GonzaCerv/noah-hardware/3D_model/electronics/LCD-1.8/s-l1600.png

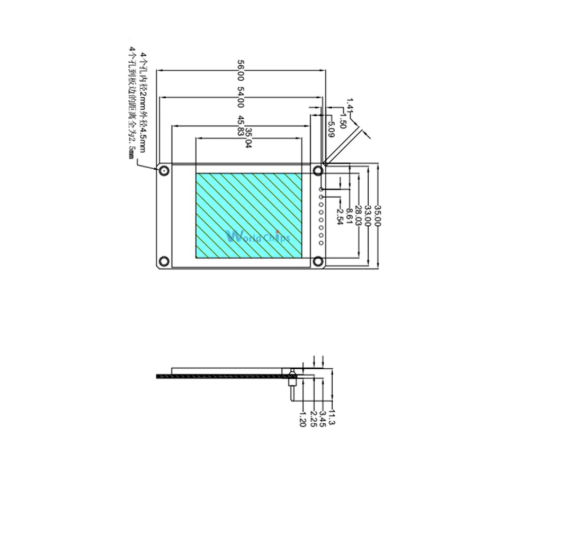
3D_model/electronics/LCD-1.8/s-l1600.png
