GonzaCerv/noah-hardware/3D_model/electronics/MG90S-Servo/Servo-MG90S.JPG

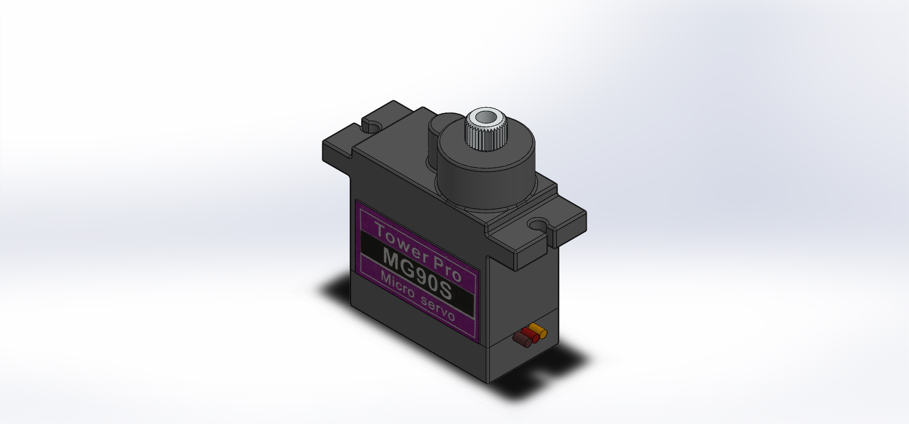
3D_model/electronics/MG90S-Servo/Servo-MG90S.JPG
