GonzaCerv/noah-hardware/3D_model/electronics/RPI3/renders/render1.jpg

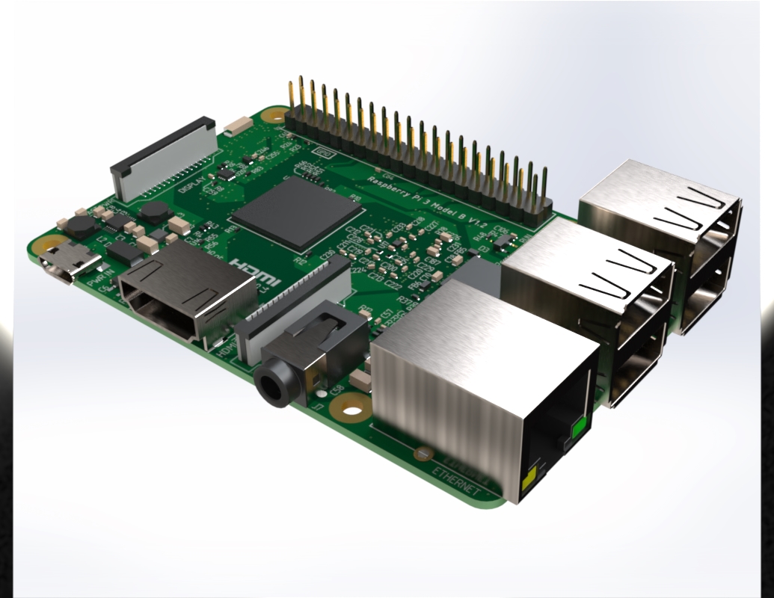
3D_model/electronics/RPI3/renders/render1.jpg
