GonzaCerv/noah-hardware/3D_model/electronics/RPI3/renders/render3.jpg

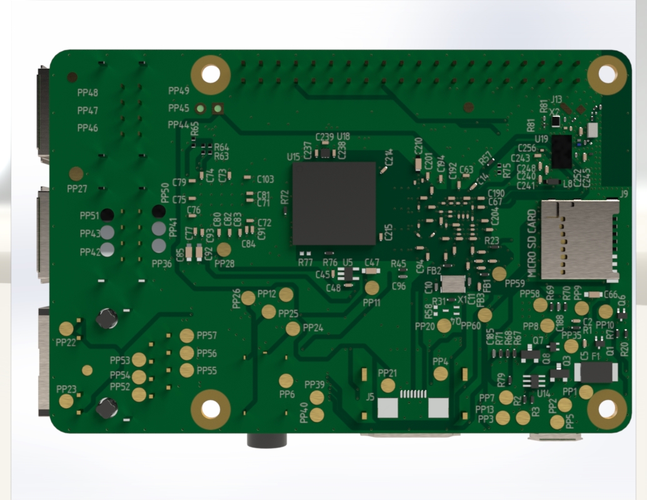
3D_model/electronics/RPI3/renders/render3.jpg
