GonzaCerv/noah-hardware/3D_model/electronics/RPI3/renders/render7.jpg

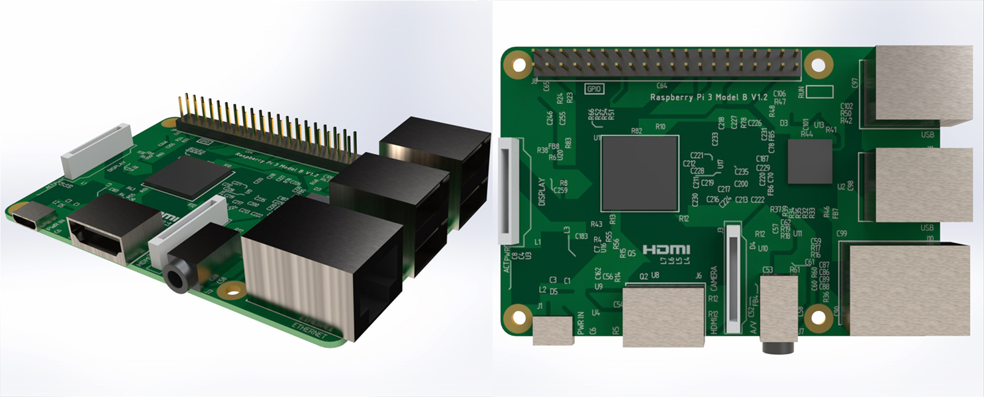
3D_model/electronics/RPI3/renders/render7.jpg
