GonzaCerv/noah-hardware/3D_model/electronics/RPI3/textures/textureBack.png

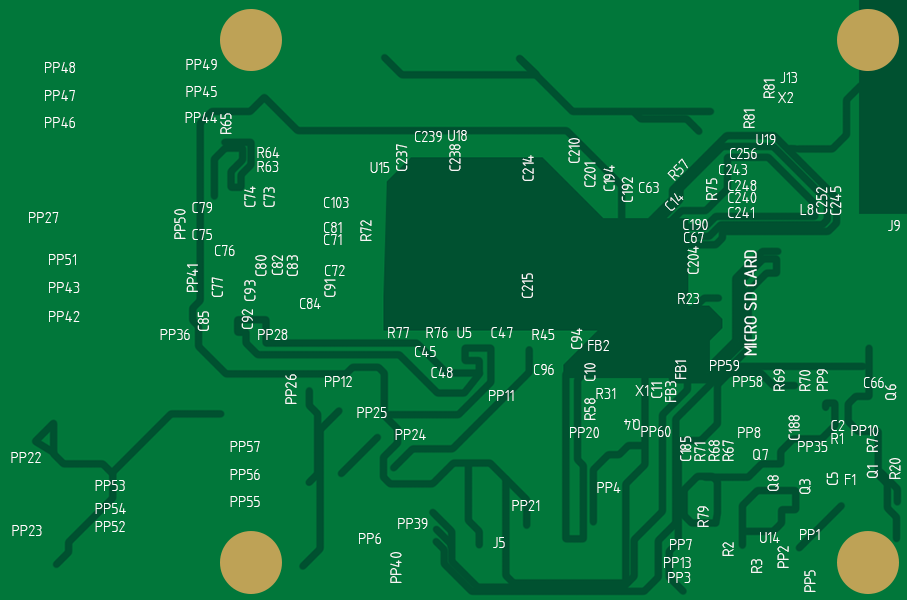
3D_model/electronics/RPI3/textures/textureBack.png
