GonzaCerv/noah-hardware/3D_model/electronics/RPI3/textures/textureFront.png

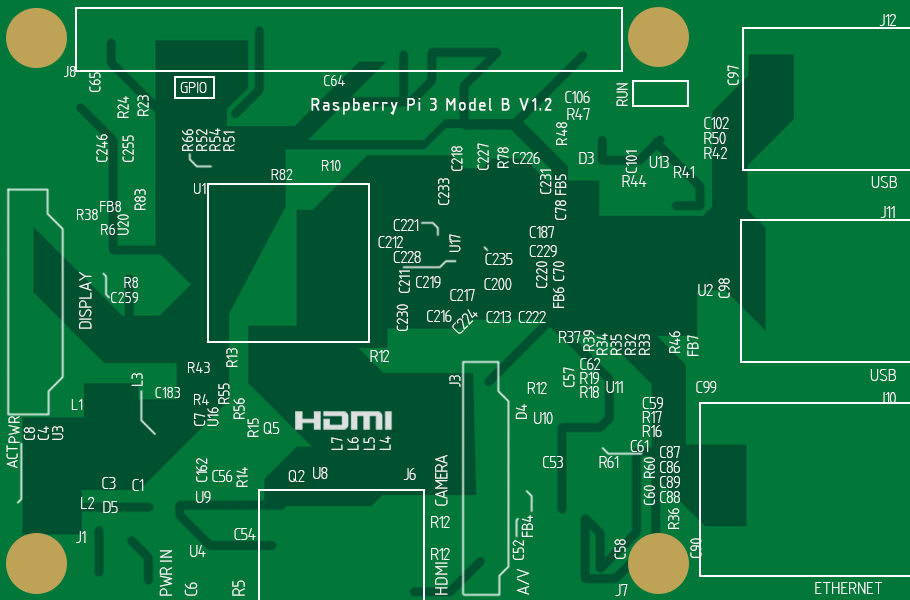
3D_model/electronics/RPI3/textures/textureFront.png
