GonzaCerv/noah-hardware/3D_model/electronics/RPI Cam/back.jpg

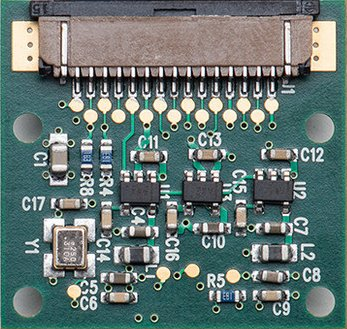
3D_model/electronics/RPI Cam/back.jpg
