GonzaCerv/noah-hardware/3D_model/electronics/RPI Cam/front.jpg

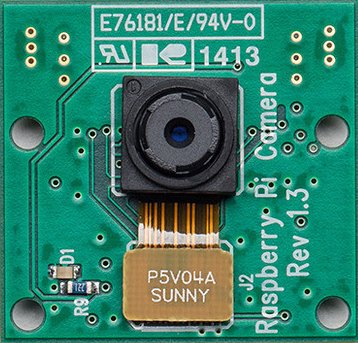
3D_model/electronics/RPI Cam/front.jpg
