GonzaCerv/noah-hardware/3D_model/electronics/RPI Cam/RasPi_Camera.JPG

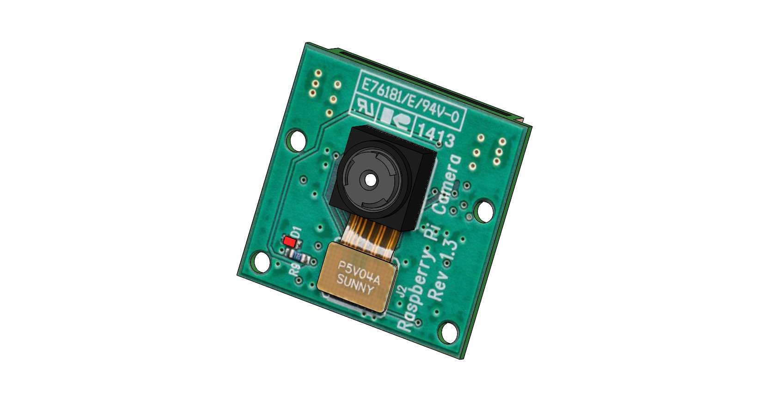
3D_model/electronics/RPI Cam/RasPi_Camera.JPG
