GonzaCerv/noah-hardware/3D_model/electronics/STM32F4/stm32f4/STM32F4-discovery-bottom.jpg

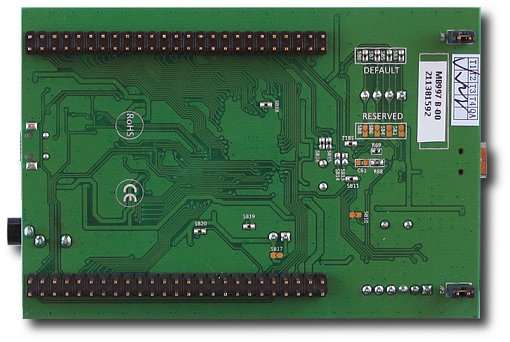
3D_model/electronics/STM32F4/stm32f4/STM32F4-discovery-bottom.jpg
