GonzaCerv/noah-hardware/3D_model/electronics/STM32F4/stm32f4/Stm32F4.jpg

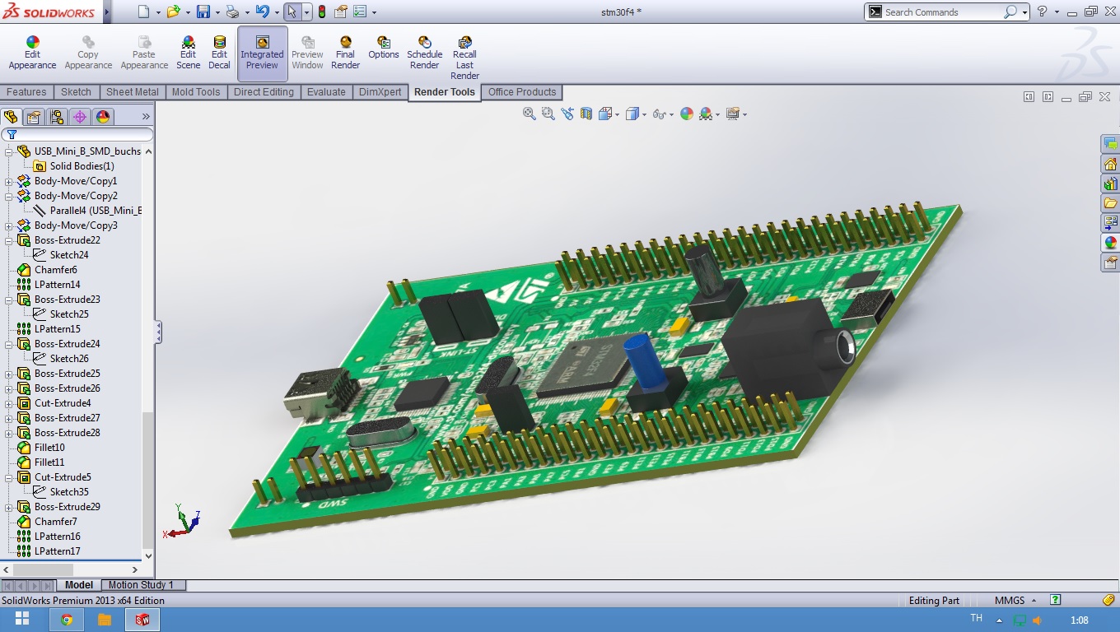
3D_model/electronics/STM32F4/stm32f4/Stm32F4.jpg
