GonzaCerv/noah-hardware/3D_model/electronics/STM32F4/stm32f4/stm32f4_discovery_small.jpg

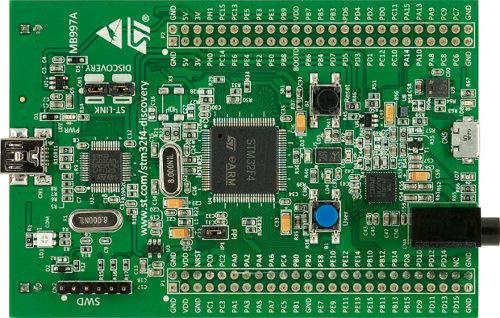
3D_model/electronics/STM32F4/stm32f4/stm32f4_discovery_small.jpg
