GonzaCerv/noah-hardware/Doc/Datasheet/GY-91_SCH.jpg

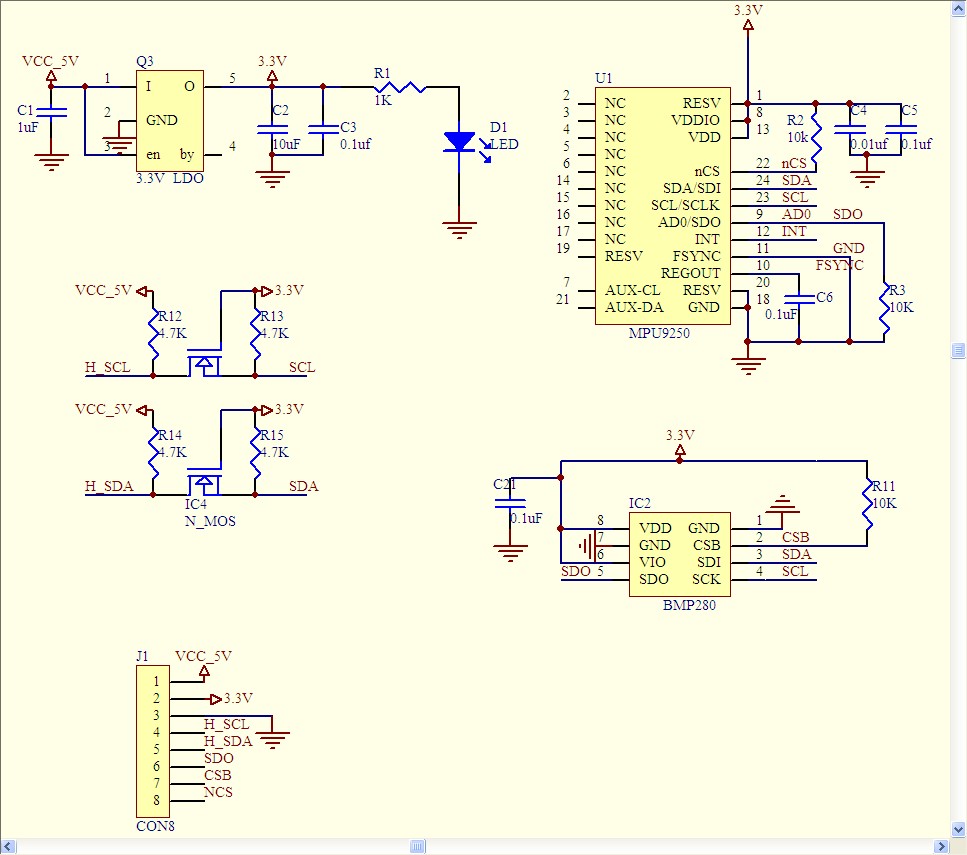
Doc/Datasheet/GY-91_SCH.jpg
