GonzaCerv/noah-hardware/Doc/images/noah_generic_1.jpg

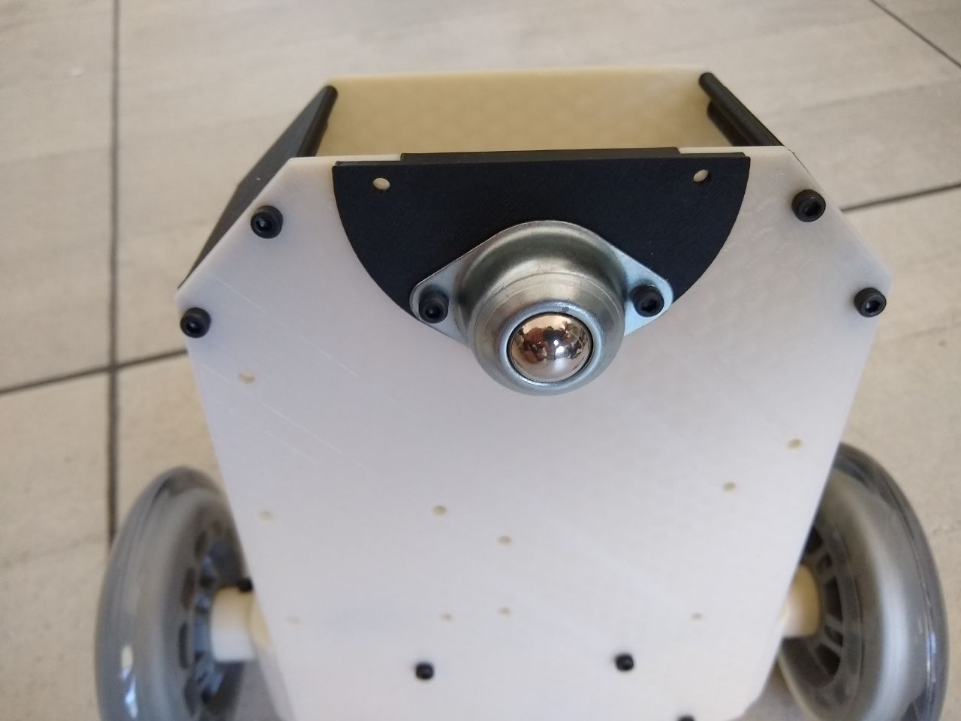
Doc/images/noah_generic_1.jpg
