GonzaCerv/noah-hardware/Doc/images/noah_generic_3.jpg

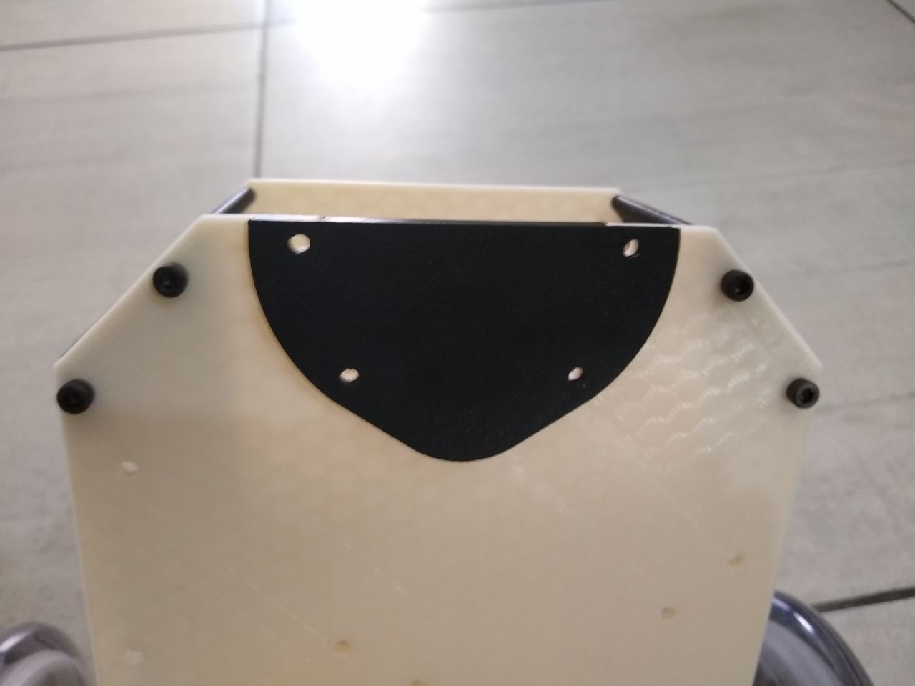
Doc/images/noah_generic_3.jpg
