GonzaCerv/noah-hardware/Doc/images/noah_generic_4.jpg

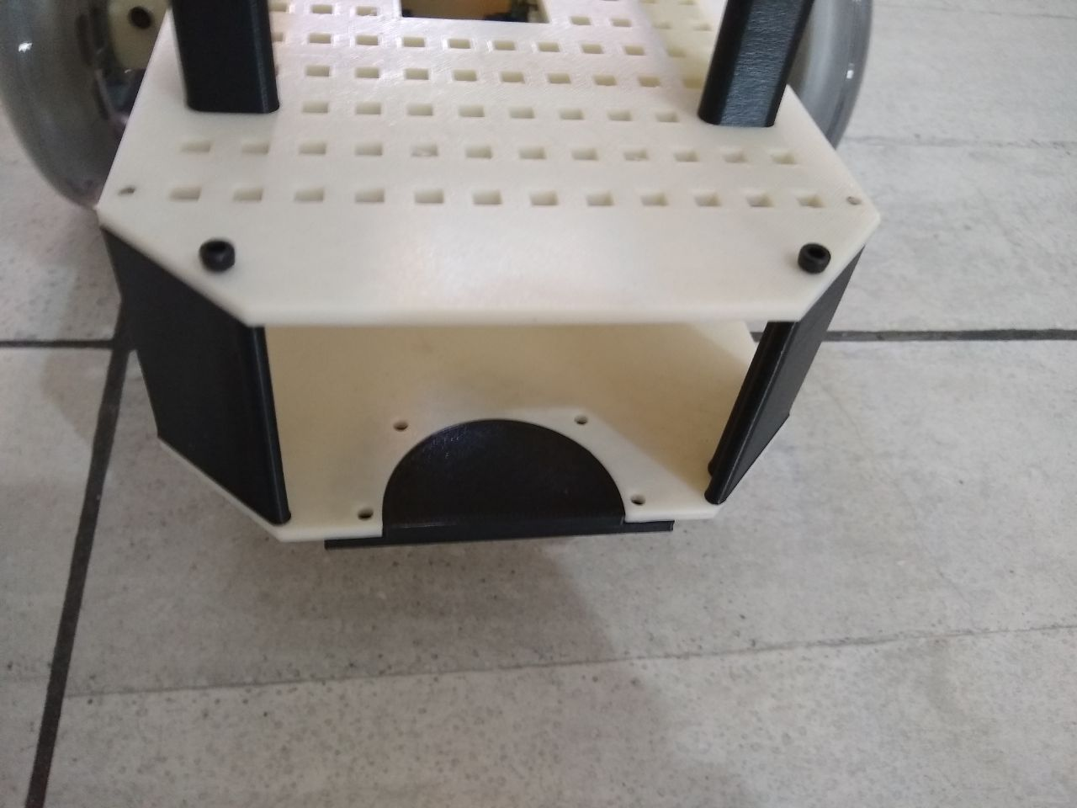
Doc/images/noah_generic_4.jpg
