GonzaCerv/noah-hardware/Doc/BOM.ods

Sheet: Noah-Generic
Item | Categoria | Fabricante | Descripcion | Proveedor | Costo U$S | Costo $ | Referencia
1 | Electronica | Element 14 | Raspberry PI 4 | MercadoLibre | $52.0 | 7,947 | https://articulo.mercadolibre.com.ar/MLA-881506910-raspberry-pi-4b-2gb-ram-original-made-in-uk-_JM
1 | Electrónica | UniBot, PatagoniaTec | Driver Motor DC | MercadoLibre | $3.2 | 500 | https://articulo.mercadolibre.com.ar/MLA-825601902-driver-tb6612-fng-doble-puente-h-15v-max-12a-robotica-ubot-_JM
2 | Electrónica | Itytarg | DC-DC converter | MercadoLibre | $4.6 | 707 | https://articulo.mercadolibre.com.ar/MLA-648618942-step-down-5a-xl4015-cc-cv-led-driver-cbateria-4v-38v-itytarg-_JM
1 | Electrónica | Element 14 | Blue Pill Stm32 | MercadoLibre | $3.9 | 599 | https://articulo.mercadolibre.com.ar/MLA-777080676-modulo-desarrollo-stm32f103c8t6-blue-pill-stm32-cs32f103c8t6-_JM
1 | Electrónica | China | DC motor + Encoder | Openhacks | $26.0 | 4030 | https://www.openhacks.com/page/productos/id/1775/title/DC6-24v-Gear-Motor-with-Encoder#.YJh7QbX0lPY
4 | Electrónica | China | Celda 3.7v 18650 | MercadoLibre | $5.8 | 900 | https://articulo.mercadolibre.com.ar/MLA-624246943-pila-de-litio-ion-icr18650-26f-samsung-2600mah-p-linternas-_JM
1 | Electrónica | China | BMS Proteccion-Balanceo Baterías litio | Mercadolibre | $10.9 | 1690 | https://articulo.mercadolibre.com.ar/MLA-795341093-modulo-proteccion-4-baterias-li-ion-18650-bms-4-celdas-30a-_JM
1 | Electrónica | China | Cables varios | Mercadolibre | $4.2 | 650 | https://articulo.mercadolibre.com.ar/MLA-621519912-kit-120-cables-x-20-cm-dupont-protoboard-arduino-mm-mh-hh-_JM
1 | Electronica | China | llave micro E | Mercadolibre | $7.2 | 1110 | https://articulo.mercadolibre.com.ar/MLA-866399995-smts102-micro-llave-palanca-simple-on-on-3a-250v-pack-x5-_JM
2 | Mecánica | Tuxs | Rueda Roller 100mm (no bearing) | Mercadolibre | $16.1 | 2490 | https://articulo.mercadolibre.com.ar/MLA-797050834-4-ruedas-silicona-para-rollers-monopatin-100-mm-estacion-deportes-olivos-_JM
8 | Mecánica | China | Holder 18650 | Mercadolibre | $0.5 | 75 | https://articulo.mercadolibre.com.ar/MLA-917623042-holder-separador-porta-pila-18650-encastrable-_JM
34 | Mecánica |  | Tornillos M3 x 10mm | Mercadolibre | $3.2 | 500 | https://articulo.mercadolibre.com.ar/MLA-724797219-tornillos-electronica-m3-x-10mm-caja-x-100-unid-con-tuercas-_JM
34 | Mecánica |  | Arandelas M3 | Mercadolibre | $2.5 | 389 | https://articulo.mercadolibre.com.ar/MLA-919535639-arandelas-m3-pack-x-200-unidades-plateadas-electronica-_JM
12 | Mecánica |  | Tuercas M3 | Mercadolibre | $1.2 | 191 | https://articulo.mercadolibre.com.ar/MLA-728283877-x20-tuerca-metrica-m3-hexagonal-lock-nust-05mm-_JM
2 | Mecánica |  | Rueda Loca Arduino | Mercadolibre | $1.4 | 214 | https://articulo.mercadolibre.com.ar/MLA-759018310-rueda-loca-arduino-tipo-bola-para-robot-rover-auto-ptec-_JM
1 | Parte 3D | - | front | - | - | -
1 | Parte 3D | - | C000 | - | - | -
1 | Parte 3D | - | C001 | - | - | -
2 | Parte 3D | - | Adapter1 | - | - | -
2 | Parte 3D | - | Adapter2 | - | - | -
1 | Parte 3D | - | base_generic | - | - | -
1 | Parte 3D | - | top_generic | - | - | -
1 | Parte 3D | - | shelf | - | - | -
1 | Parte 3D | - | back_left | - | - | -
1 | Parte 3D | - | back_right | - | - | -
1 | Parte 3D | - | SMPS_support | - | - | -
4 | Parte 3D | - | spacer50mm | - | - | -

Sheet: Copia de Hoja 1
Item | Categoria | Fabricante | Descripcion | Proveedor | Costo U$S | Costo $ | Referencia
1 | Vehiculo | Cub Cadet | 42" mower with 18HP Kohler engine | MercadoLibre | $1,650
1 | Direccion |  | 12 volt power steering motor | ebay | $50
1 | Transimision |  | linear actuator
1 | Direccion |  | motor controller |  |  |  | Investigate using a Sabertooth controller and py lib (https://github.com/MomsFriendlyRobotCompany/pysabertooth); See also https://www.dimensionengineering.com/datasheets/Sabertooth2x25v2.pdf
 | Seguridad |  | wireless kill switch and transmitter
 | Seguridad |  | lanyard kill switch
 | Electronica |  | RPi 3 for companion computer
 | Electronica | Tinkerforge | IMU Brick 2 | Tinkerforge
 | Electronica |  | Ppowered USB hub
 | Electronica |  | RTK GNSS module and antennae
 | Electronica |  | Terminal wiring blocks
 |  |  | 5 color wire (18 AWG)
