GonzaCerv/noah-hardware/3D_model/assembly_front.SLDASM

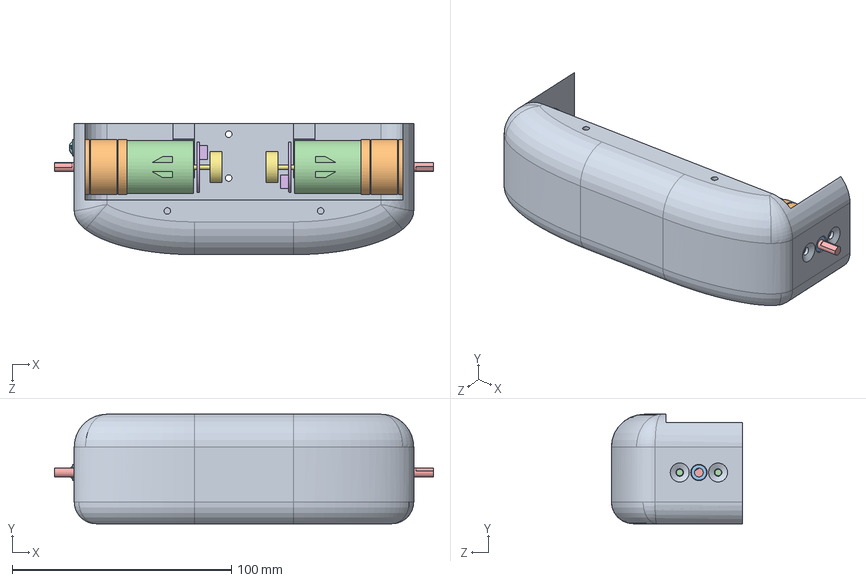
[picture p26: CAD file, 2020-10-06]
3D_model/assembly_front.SLDASM
173.0 x 50.0 x 60.0 mm
front_noah
Gearbox x 2
hub x 2
Motor x 2
Axis x 2
PCB x 2
Magnet x 2
