GonzaCerv/noah-hardware/3D_model/case/casterjoint/noah/CasterJoint.SLDASM

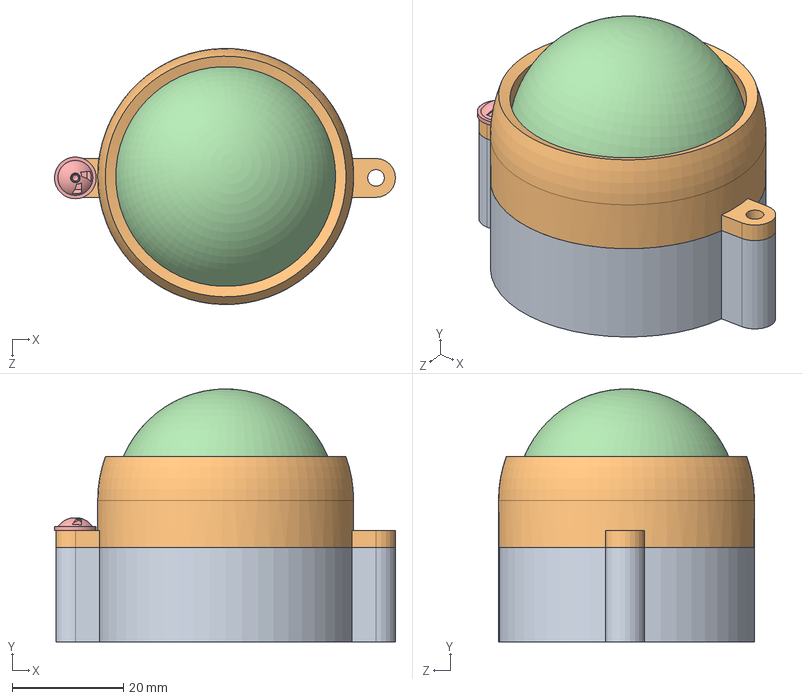
[picture p27: CAD file, 2020-10-18]
3D_model/case/casterjoint/noah/CasterJoint.SLDASM
61.2 x 45.4 x 46.0 mm
C000
C001
BALL6MM x 3
BALL40MM
