GonzaCerv/noah-hardware/3D_model/electronics/18650bat/BatteryPack.SLDASM

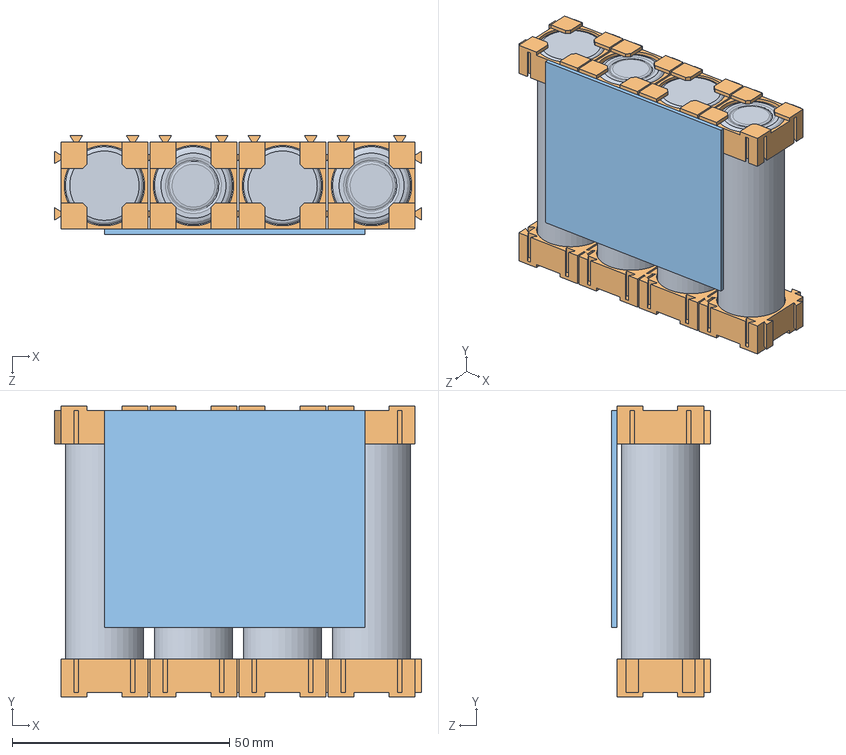
[picture p28: CAD file, 2020-05-14]
3D_model/electronics/18650bat/BatteryPack.SLDASM
84.5 x 67.0 x 22.7 mm
ELEB05 x 4
ELEB04 x 8
BMS
