GonzaCerv/noah-hardware/3D_model/electronics/JA25-371-12v motor/JA25-371-12V.SLDASM

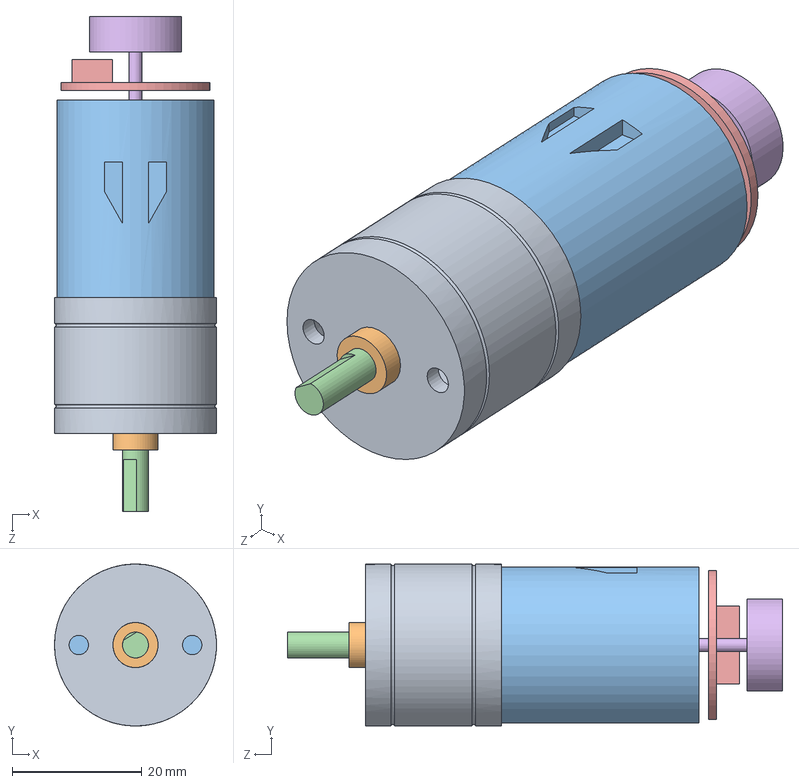
[picture p29: CAD file, 2020-05-14]
3D_model/electronics/JA25-371-12v motor/JA25-371-12V.SLDASM
25.0 x 25.0 x 76.4 mm
Gearbox
hub
Motor
Axis
PCB
Magnet
