GonzaCerv/noah-hardware/3D_model/electronics/Misc/LED 3mm Red 3mm Leads.SLDASM

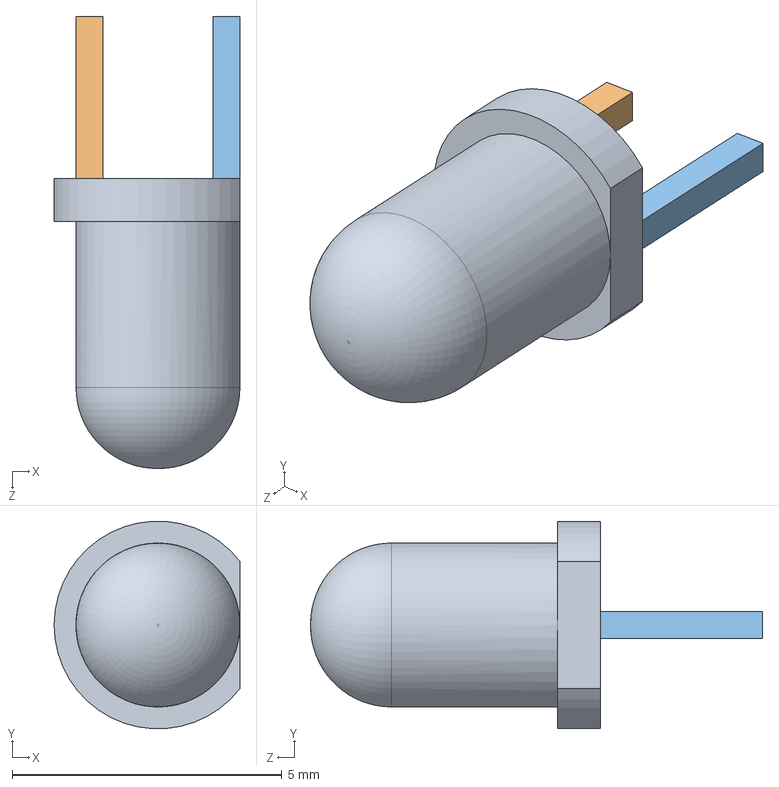
[picture p30: CAD file, 2020-10-06]
3D_model/electronics/Misc/LED 3mm Red 3mm Leads.SLDASM
3.44 x 3.84 x 8.38 mm
LEDBody.step
Lead1Body.step
Lead2Body.step
