GonzaCerv/noah-hardware/3D_model/assembly_button.SLDASM

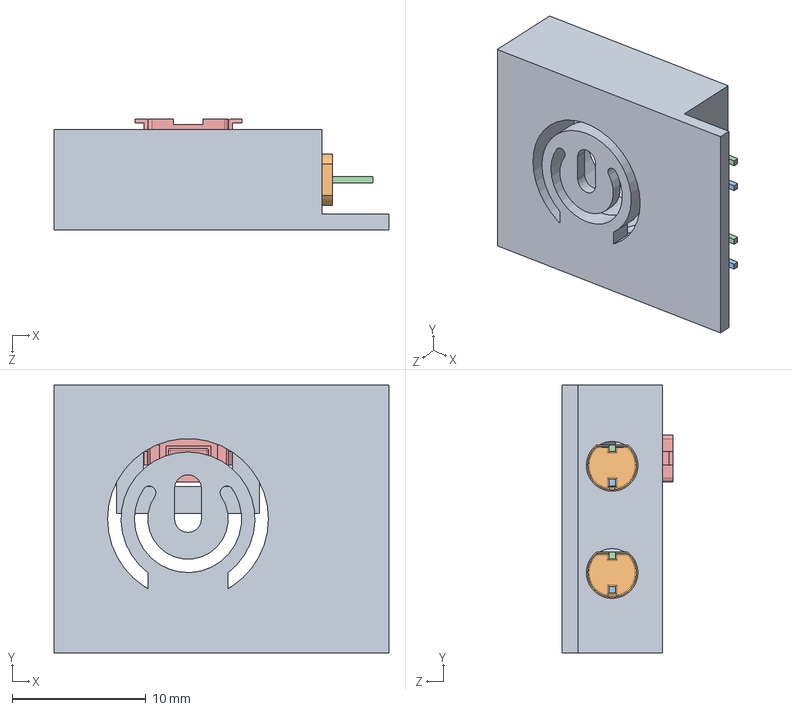
[picture p31: CAD file, 2020-10-06]
3D_model/assembly_button.SLDASM
25.0 x 20.0 x 8.30 mm
power_button_noah
LEDBody.step x 2
Lead1Body.step x 2
Lead2Body.step x 2
Tactile_Switch_SMD
hex thin nut gradeb_din x 2
