GonzaCerv/noah-hardware/3D_model/case/wheel/noah/TuxsWheel100mm.SLDASM

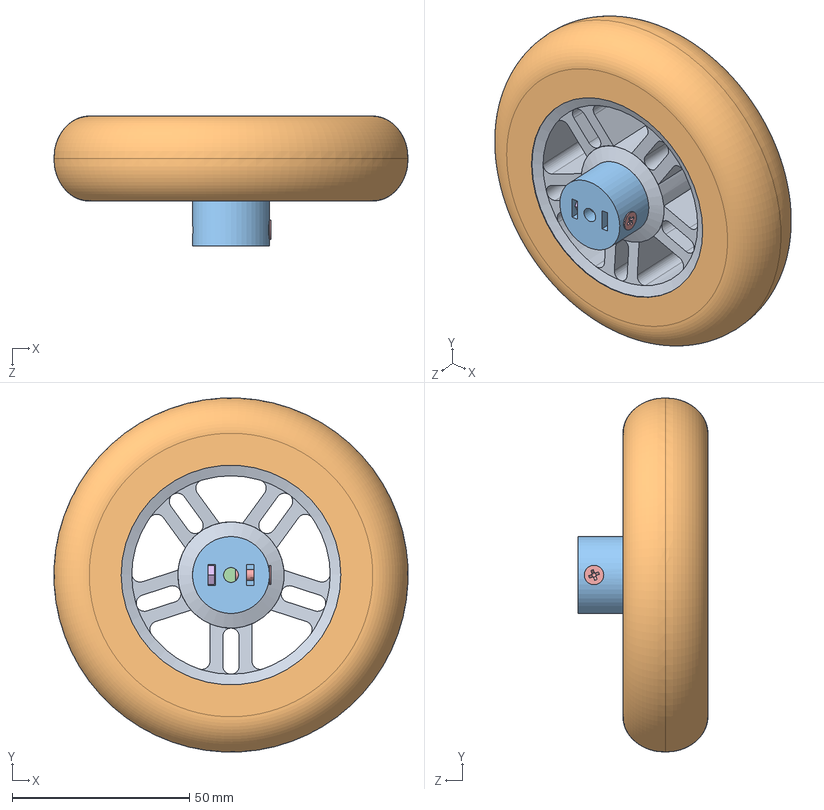
[picture p32: CAD file, 2020-10-18]
3D_model/case/wheel/noah/TuxsWheel100mm.SLDASM
99.9 x 99.9 x 36.6 mm
B02
B021
Adapter1
Adapter2
