GonzaCerv/noah-hardware/3D_model/electronics/N20 Micromotor/N20Motor.SLDASM

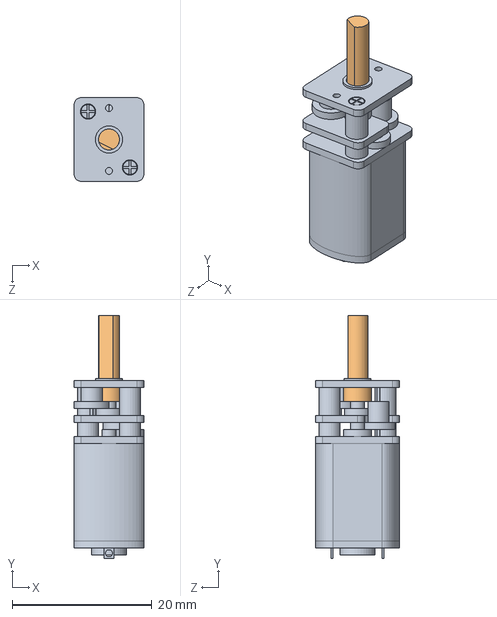
[picture p33: CAD file, 2020-04-07]
3D_model/electronics/N20 Micromotor/N20Motor.SLDASM
10.0 x 34.8 x 12.0 mm
Motor
Brazo
