GonzaCerv/noah-hardware/3D_model/electronics/RPI Cam/OVA5647.SLDASM

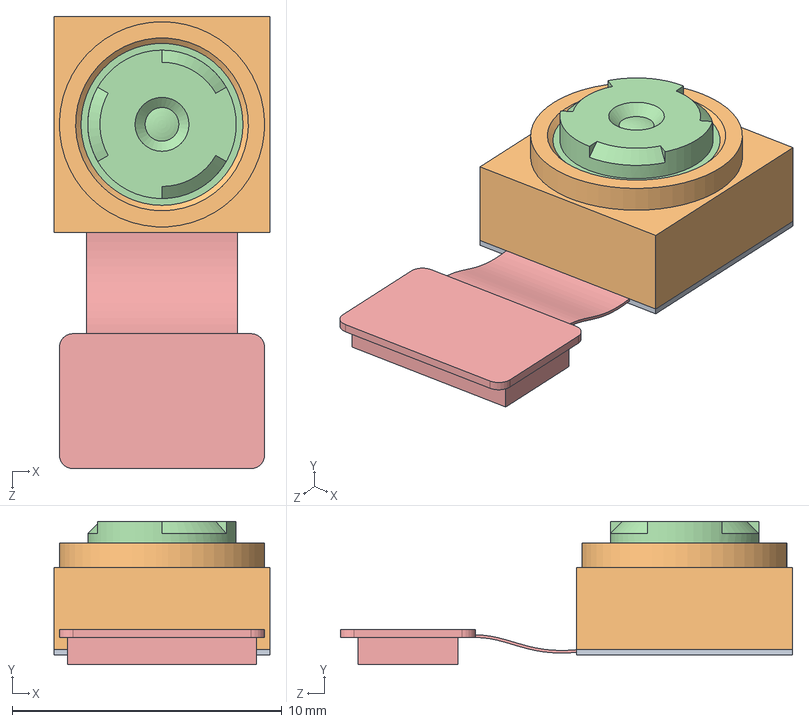
[picture p34: CAD file, 2020-04-07]
3D_model/electronics/RPI Cam/OVA5647.SLDASM
8.00 x 5.30 x 16.8 mm
OVA5647
OVA5647_Housing
OVA5647_IR-Glas
OVA5647_Lens
OVA5647_Pigtail
