GonzaCerv/noah-hardware/3D_model/electronics/TactSwitch/6mm button.SLDASM

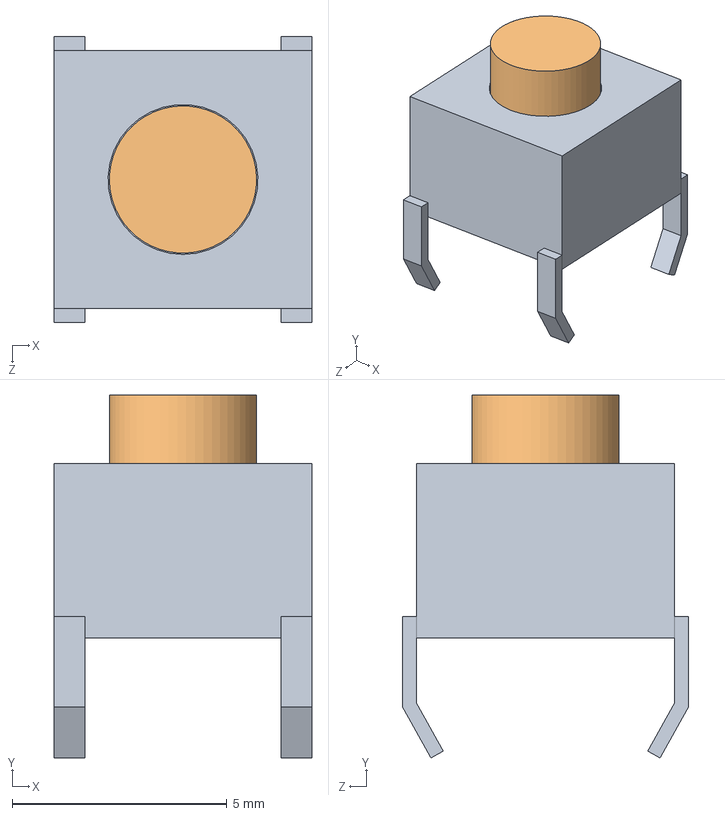
[picture p35: CAD file, 2020-04-07]
3D_model/electronics/TactSwitch/6mm button.SLDASM
6.00 x 8.46 x 6.66 mm
6mm button base
6mm button shaft
