GonzaCerv/noah-hardware/3D_model/electronics/Arduino/L298/Montaj - L298 DC Motor Drive.SLDASM

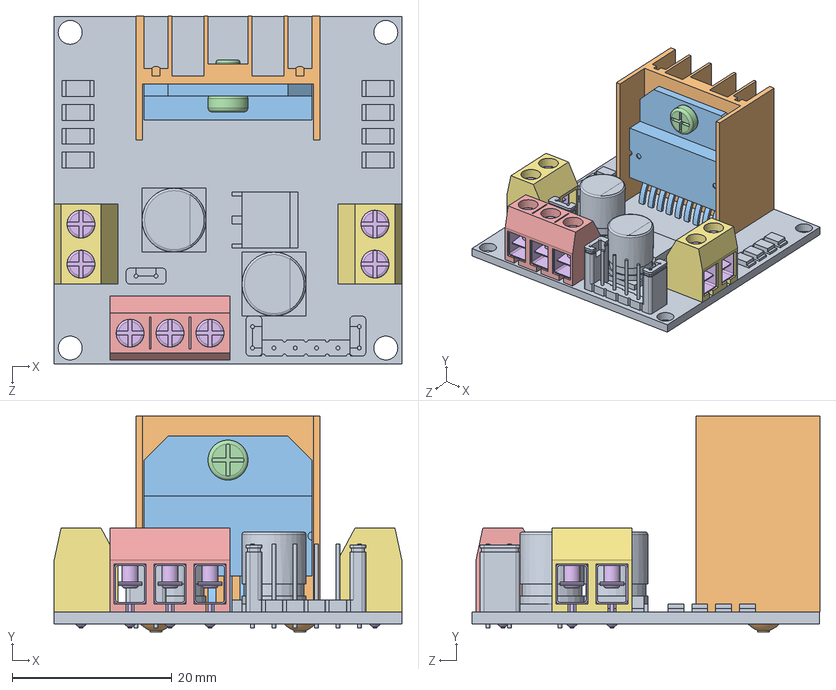
[picture p36: CAD file, 2020-10-18]
3D_model/electronics/Arduino/L298/Montaj - L298 DC Motor Drive.SLDASM
43.5 x 27.0 x 43.5 mm
L298 Board
Cooler Blok
L298N Regulator
Vida M3x4.5
Clamp Body
Metal Clamp Part x 7
Clamp Body 2x x 2
