GonzaCerv/noah-hardware/3D_model/electronics/PCB/PCB.SLDASM

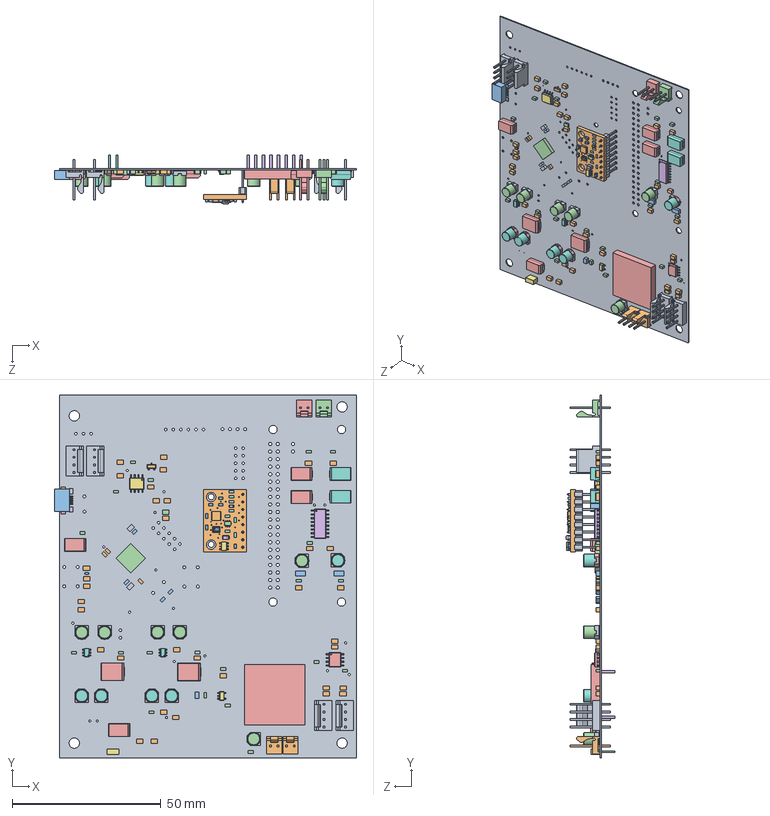
[picture p37: CAD file, 2020-04-07]
3D_model/electronics/PCB/PCB.SLDASM
101.6 x 122.0 x 16.3 mm
Board
Extruded x 34
Extruded_2 x 2
PinsArrayLR
PinKIdent
PinK
PinA
Extruded_3 x 19
Base
Pin1Fillet
Pin2Fillet
Base_2 x 2
Pin1Fillet_2 x 2
Pin2Fillet_2 x 2
FilletPin1 x 4
FilletPin2 x 4
FilletPin1_2 x 2
FilletPin2_2 x 2
Extruded_4
Extruded_5
Base_3 x 4
Pin1Fillet_3 x 4
Pin2Fillet_3 x 4
Base_4 x 4
Pin1Fillet_4 x 4
Pin2Fillet_4 x 4
Leads x 16
PinsArrayL
PinsArrayR
('pin'
('pin'_2
('pin'_3
('pin'_4
('pin'_5
('pin'_6
('pin'_7
('pin'_8
('pin'_9
('pin'_10
('pin'_11
Leads_2 x 2
Extruded_6 x 2
Extruded_7 x 3
Extruded_8 x 4
Extruded_9
FilletPin1_3 x 2
FilletPin2_3 x 2
PinsArrayLR_2 x 2
Board_2
C0603 x 6
SOT65P210X110-6
CHIP-LED0603
CAPMP2013X150
SOT95P280X145-5
R0603 x 8
2.54MM1X8
QFN24(3MMX3MMX1MM)
BMP280AU
Extruded_10
PinsArrayLR_3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
