GonzaCerv/noah-hardware/3D_model/case/base/base_generic.SLDPRT

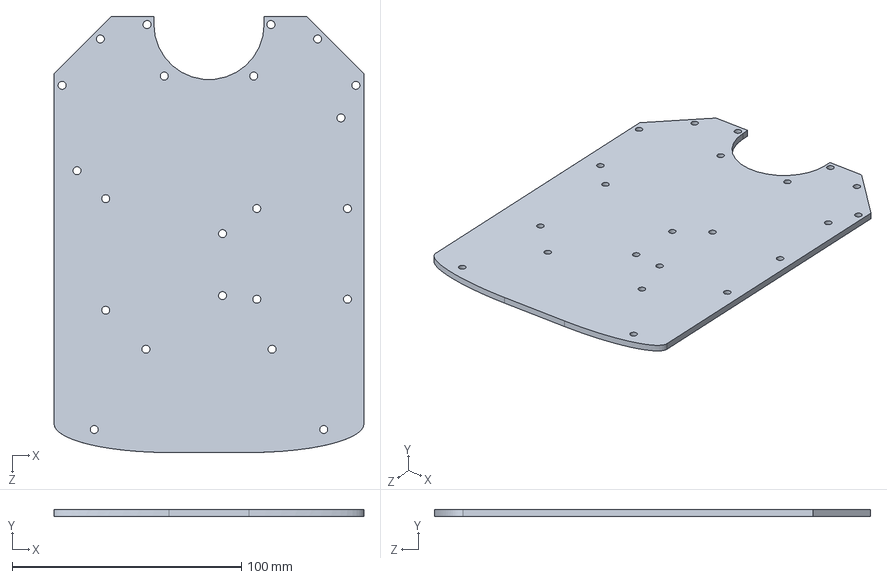
[picture p38: CAD file, 2020-10-18]
3D_model/case/base/base_generic.SLDPRT
135.0 x 3.00 x 190.0 mm
