GonzaCerv/noah-hardware/3D_model/case/casterjoint/caster_generic.SLDPRT

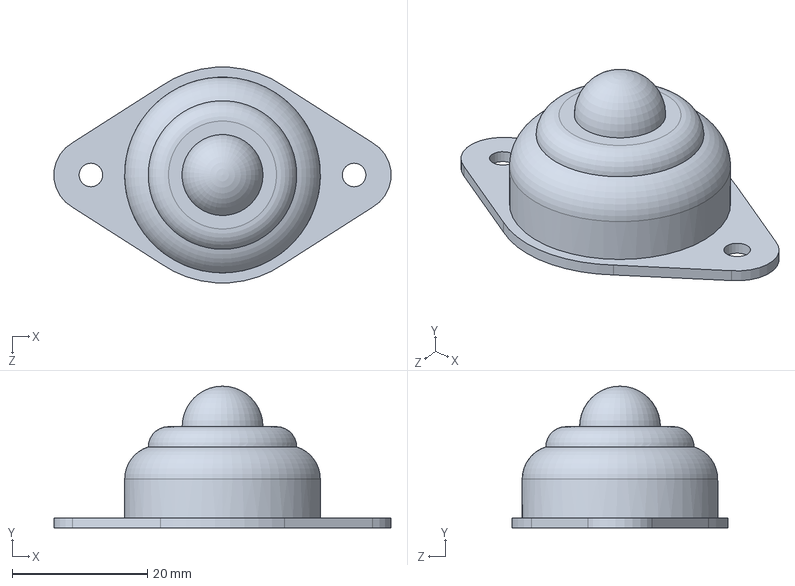
[picture p39: CAD file, 2020-10-18]
3D_model/case/casterjoint/caster_generic.SLDPRT
49.9 x 21.0 x 31.9 mm
