GonzaCerv/noah-hardware/3D_model/case/front/front_noah.SLDPRT

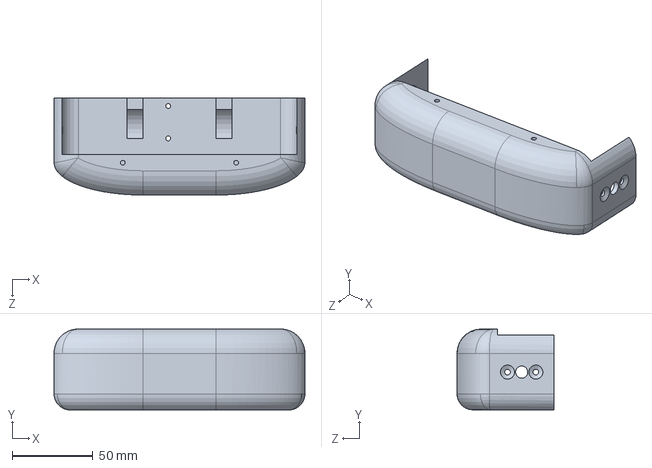
[picture p40: CAD file, 2020-08-07]
3D_model/case/front/front_noah.SLDPRT
155.0 x 50.0 x 60.0 mm
