GonzaCerv/noah-hardware/3D_model/case/pcb_bolder/noah/power_button_noah.SLDPRT

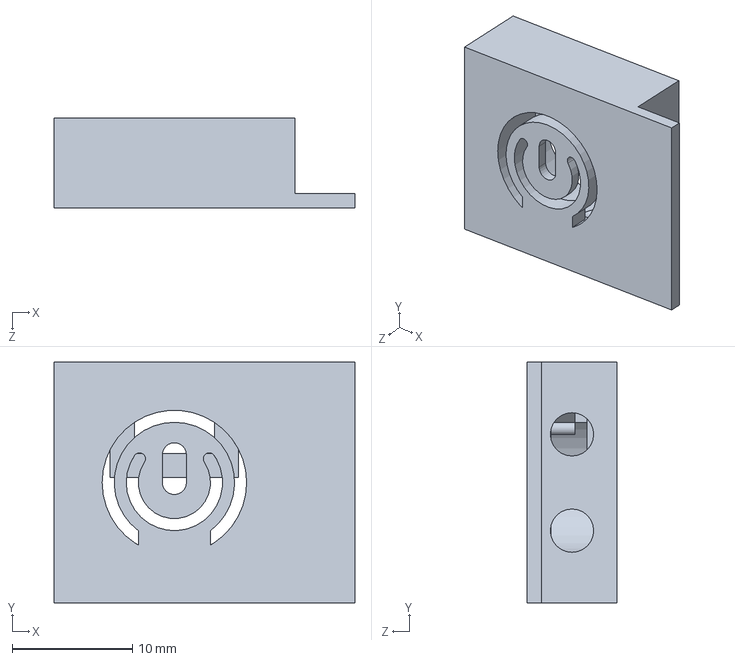
[picture p41: CAD file, 2020-10-06]
3D_model/case/pcb_bolder/noah/power_button_noah.SLDPRT
25.0 x 20.0 x 7.50 mm
