GonzaCerv/noah-hardware/3D_model/case/shelf/shelf_generic.SLDPRT

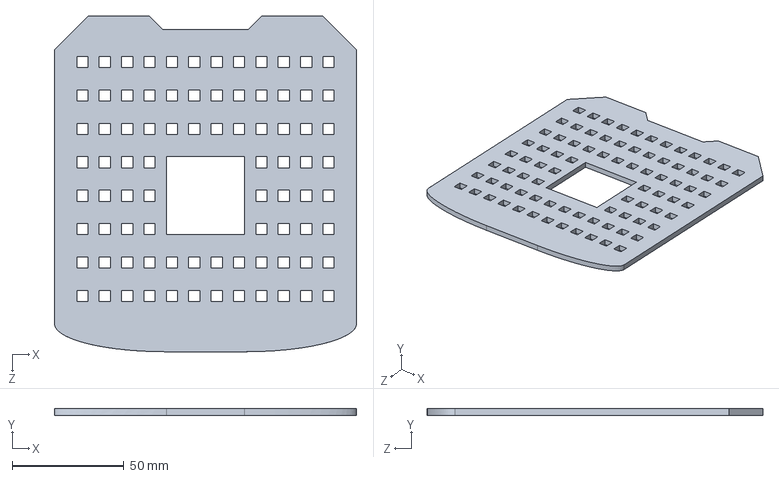
[picture p42: CAD file, 2020-10-18]
3D_model/case/shelf/shelf_generic.SLDPRT
135.0 x 3.00 x 150.0 mm
