GonzaCerv/noah-hardware/3D_model/case/support/generic/SMPS_support.SLDPRT

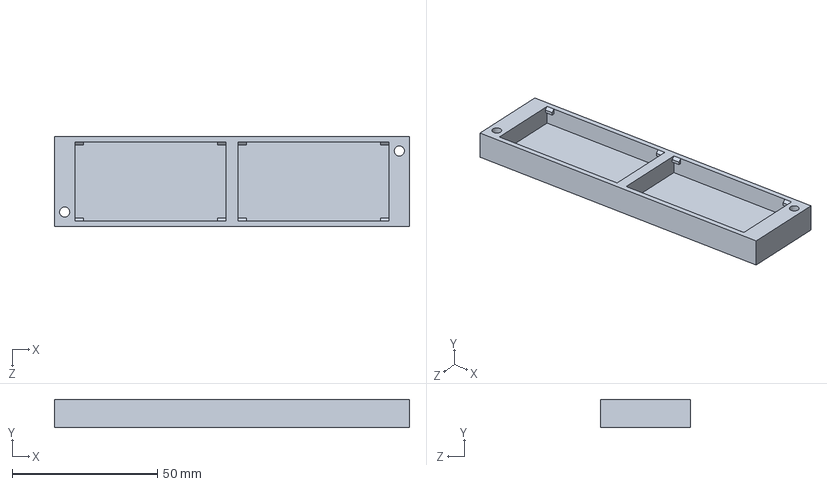
[picture p43: CAD file, 2020-10-18]
3D_model/case/support/generic/SMPS_support.SLDPRT
122.0 x 9.70 x 31.0 mm
