GonzaCerv/noah-hardware/3D_model/case/support/noah/Spacer50mm_metal.SLDPRT

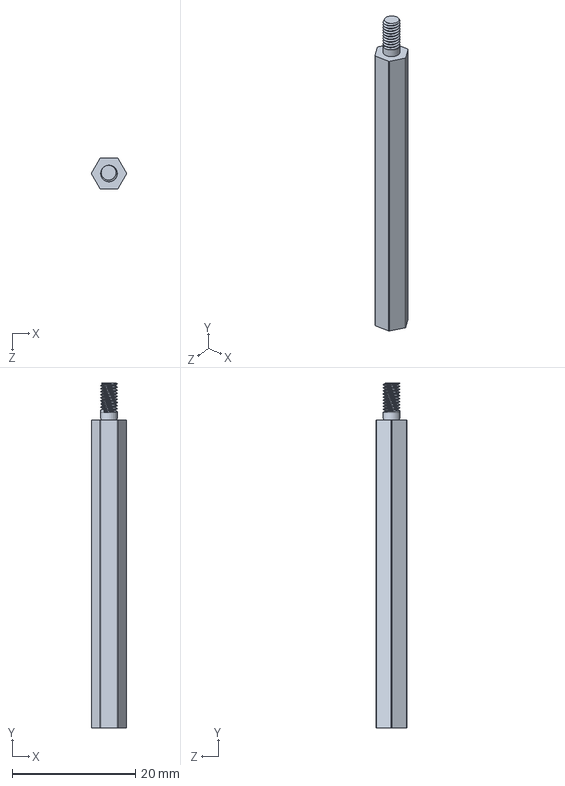
[picture p44: CAD file, 2020-04-07]
3D_model/case/support/noah/Spacer50mm_metal.SLDPRT
5.71 x 56.0 x 5.00 mm
