GonzaCerv/noah-hardware/3D_model/case/wheel/noah/Adapter1.SLDPRT

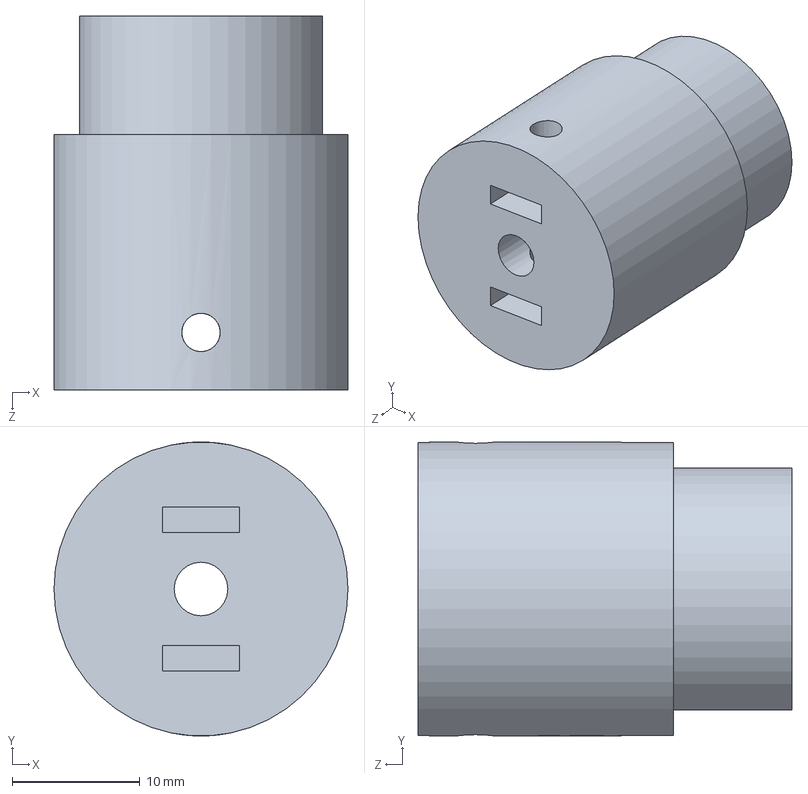
[picture p45: CAD file, 2020-10-18]
3D_model/case/wheel/noah/Adapter1.SLDPRT
23.0 x 23.0 x 29.3 mm
