GonzaCerv/noah-hardware/3D_model/case/wheel/printed/B02.SLDPRT

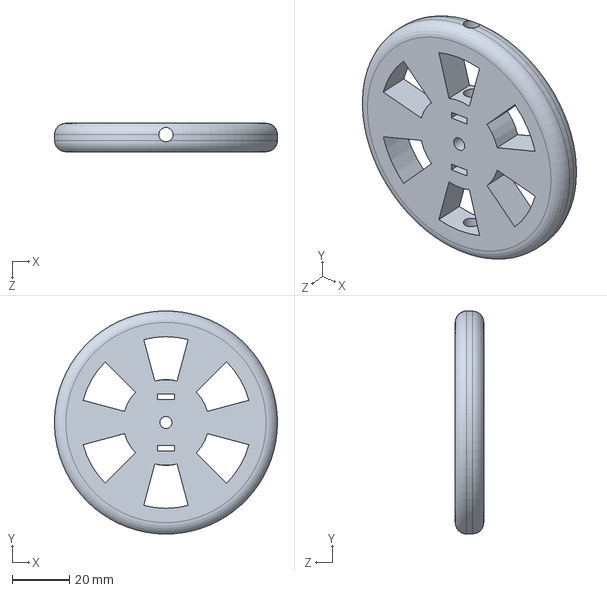
[picture p46: CAD file, 2020-04-07]
3D_model/case/wheel/printed/B02.SLDPRT
78.0 x 78.0 x 10.0 mm
