GonzaCerv/noah-hardware/3D_model/electronics/Arduino/Arduino Uno.SLDPRT

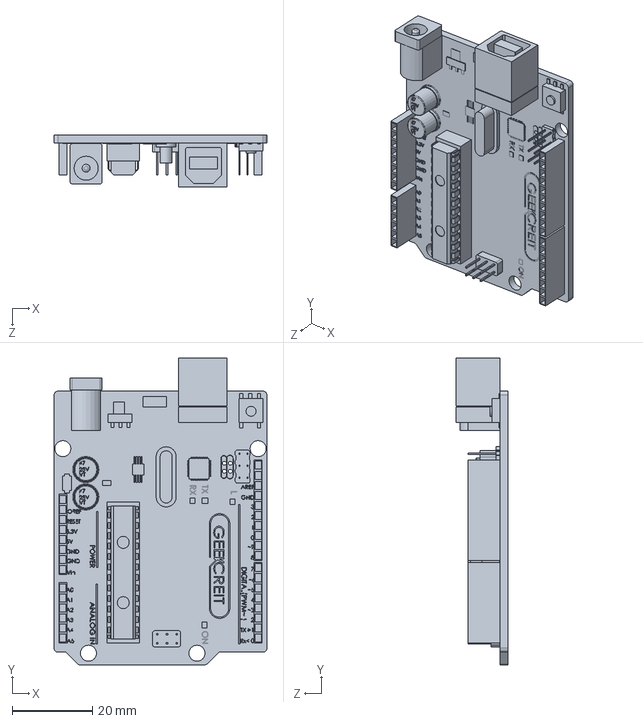
[picture p47: CAD file, 2020-10-18]
3D_model/electronics/Arduino/Arduino Uno.SLDPRT
53.0 x 76.4 x 13.0 mm
