GonzaCerv/noah-hardware/3D_model/electronics/Arduino/L298/Clamp Body.SLDPRT

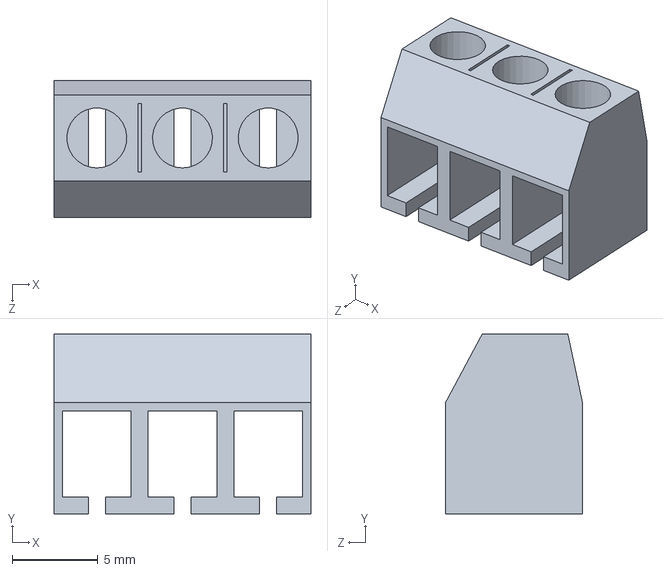
[picture p48: CAD file, 2020-10-18]
3D_model/electronics/Arduino/L298/Clamp Body.SLDPRT
15.0 x 10.5 x 8.00 mm
