GonzaCerv/noah-hardware/3D_model/electronics/CNY70/CNY70.SLDPRT

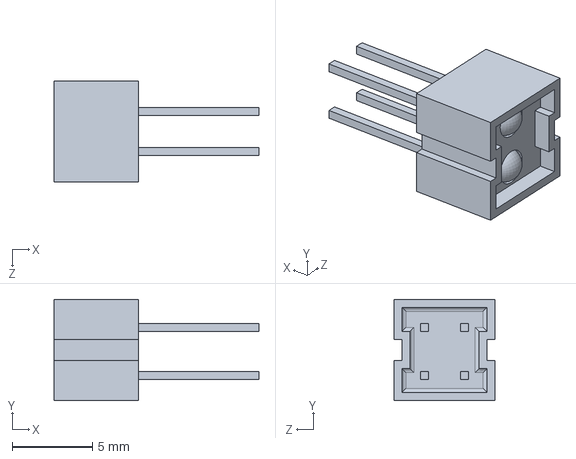
[picture p49: CAD file, 2020-04-07]
3D_model/electronics/CNY70/CNY70.SLDPRT
12.8 x 6.30 x 6.30 mm
