GonzaCerv/noah-hardware/3D_model/electronics/IR_Sensor/IRSensor.SLDPRT

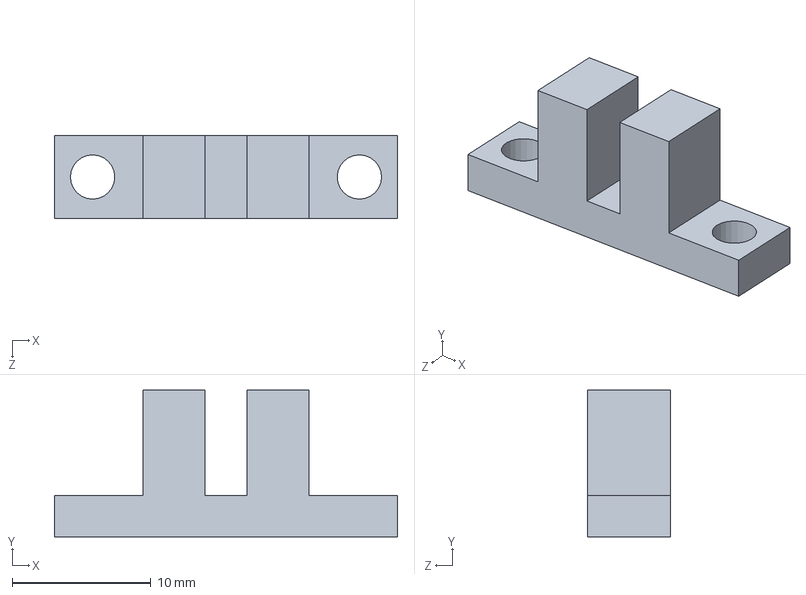
[picture p50: CAD file, 2020-04-07]
3D_model/electronics/IR_Sensor/IRSensor.SLDPRT
24.8 x 10.6 x 6.00 mm
