GonzaCerv/noah-hardware/3D_model/electronics/IR_Sensor2/IR_Sensor.SLDPRT

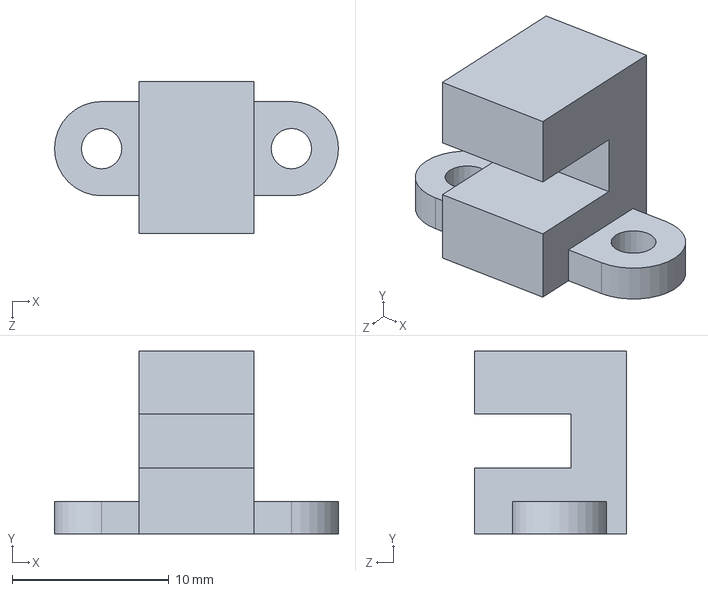
[picture p51: CAD file, 2020-04-07]
3D_model/electronics/IR_Sensor2/IR_Sensor.SLDPRT
18.1 x 11.6 x 9.68 mm
