GonzaCerv/noah-hardware/3D_model/electronics/LCD-1.8/1.8_inches_128x160_RGB_TFT_LCD.stp

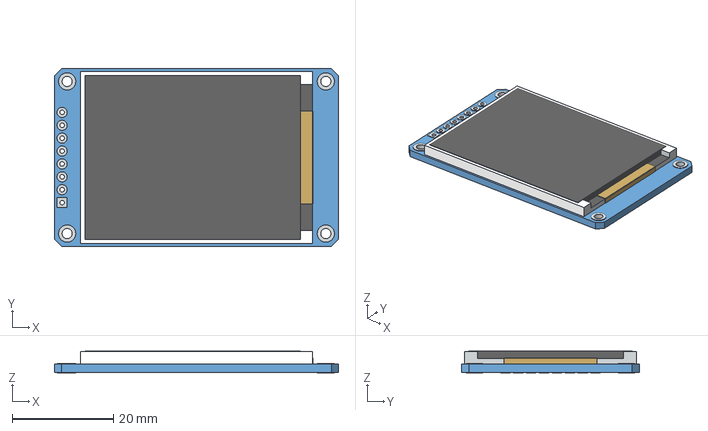
[picture p52: CAD file, 2020-04-07]
3D_model/electronics/LCD-1.8/1.8_inches_128x160_RGB_TFT_LCD.stp
56.0 x 35.0 x 4.25 mm
