GonzaCerv/noah-hardware/3D_model/electronics/MG90S-Servo/Servo-MG90S.SLDPRT

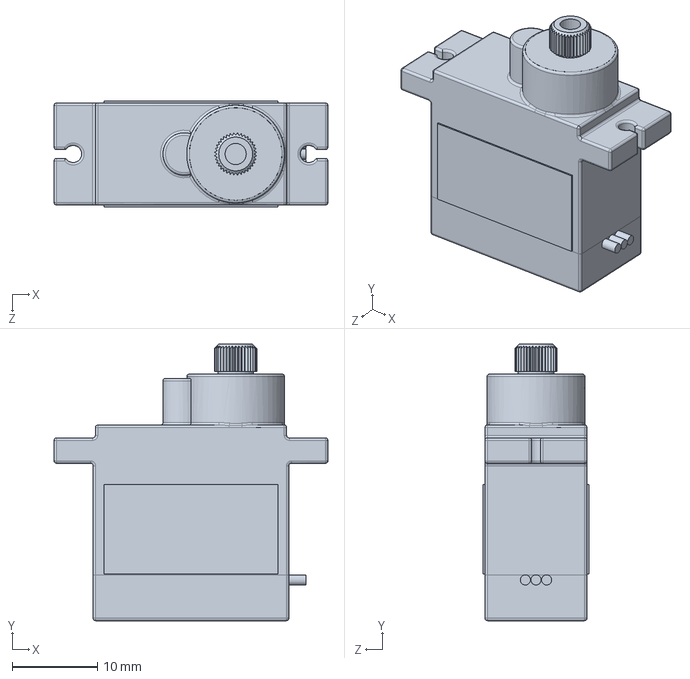
[picture p53: CAD file, 2020-04-07]
3D_model/electronics/MG90S-Servo/Servo-MG90S.SLDPRT
32.2 x 32.5 x 12.4 mm
