GonzaCerv/noah-hardware/3D_model/electronics/N20 Micromotor/Brazo.SLDPRT

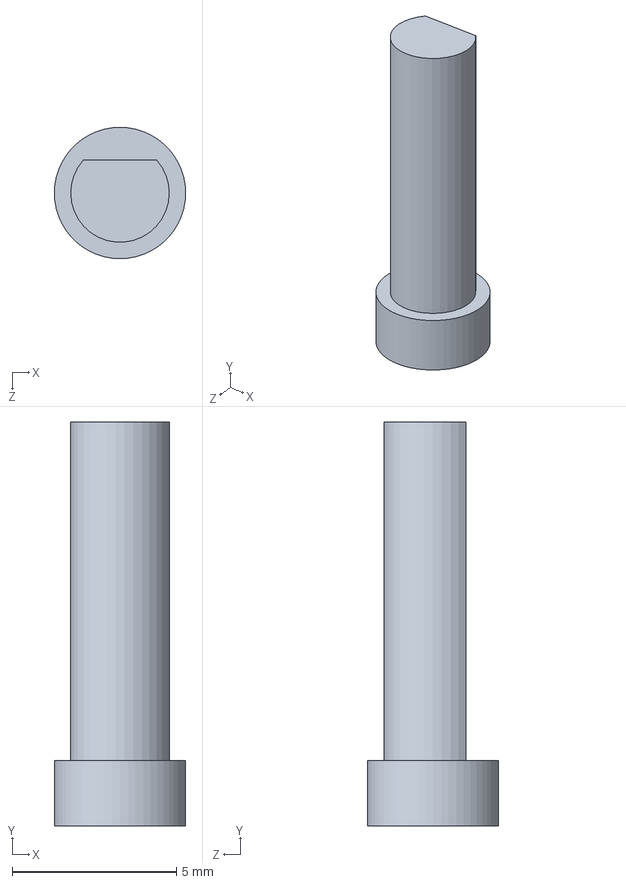
[picture p54: CAD file, 2020-04-07]
3D_model/electronics/N20 Micromotor/Brazo.SLDPRT
4.00 x 12.3 x 4.00 mm
