GonzaCerv/noah-hardware/3D_model/electronics/RPI Cam/OVA5647_IR-Glas.SLDPRT

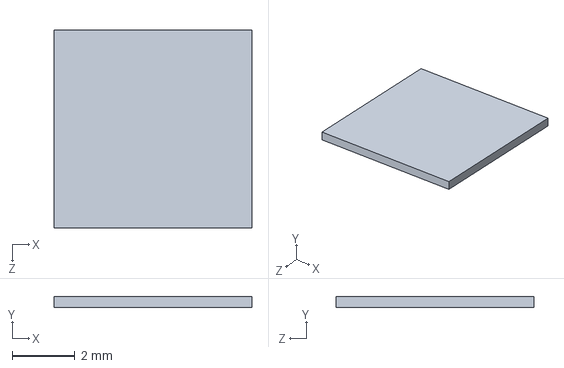
[picture p55: CAD file, 2020-04-07]
3D_model/electronics/RPI Cam/OVA5647_IR-Glas.SLDPRT
6.30 x 0.35 x 6.30 mm
