GonzaCerv/noah-hardware/3D_model/electronics/RPI IR/LED INFRARED CAMERA PI.STEP

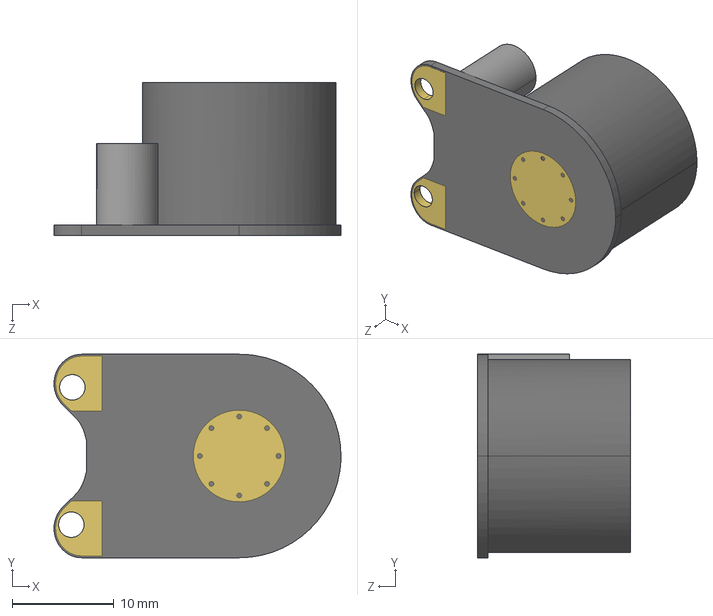
[picture p56: CAD file, 2020-04-07]
3D_model/electronics/RPI IR/LED INFRARED CAMERA PI.STEP
28.2 x 20.0 x 15.0 mm
