GonzaCerv/noah-hardware/3D_model/electronics/RPI Zero W/RaspberryPiZeroW.SLDPRT

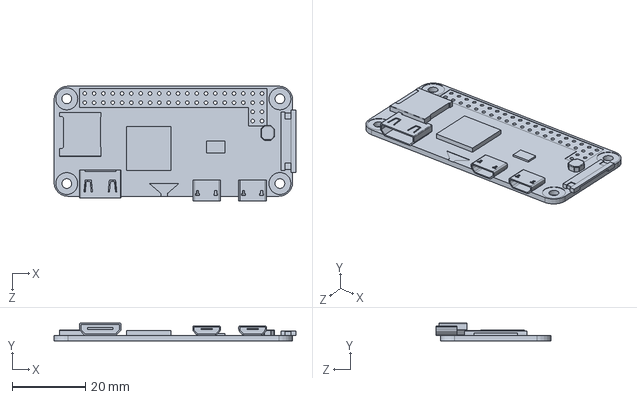
[picture p57: CAD file, 2020-04-07]
3D_model/electronics/RPI Zero W/RaspberryPiZeroW.SLDPRT
65.9 x 4.80 x 31.2 mm
