GonzaCerv/noah-hardware/3D_model/electronics/RPI3/raspberryPi3BSimplified_STEP.STEP

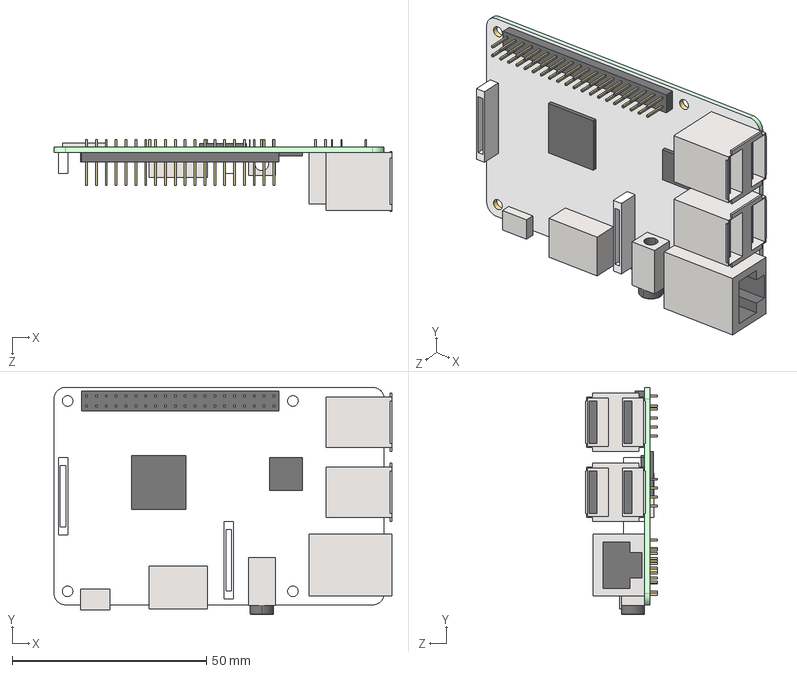
[picture p58: CAD file, 2020-04-07]
3D_model/electronics/RPI3/raspberryPi3BSimplified_STEP.STEP
87.0 x 58.5 x 18.6 mm
