GonzaCerv/noah-hardware/3D_model/electronics/TactSwitch/6mm button base.SLDPRT

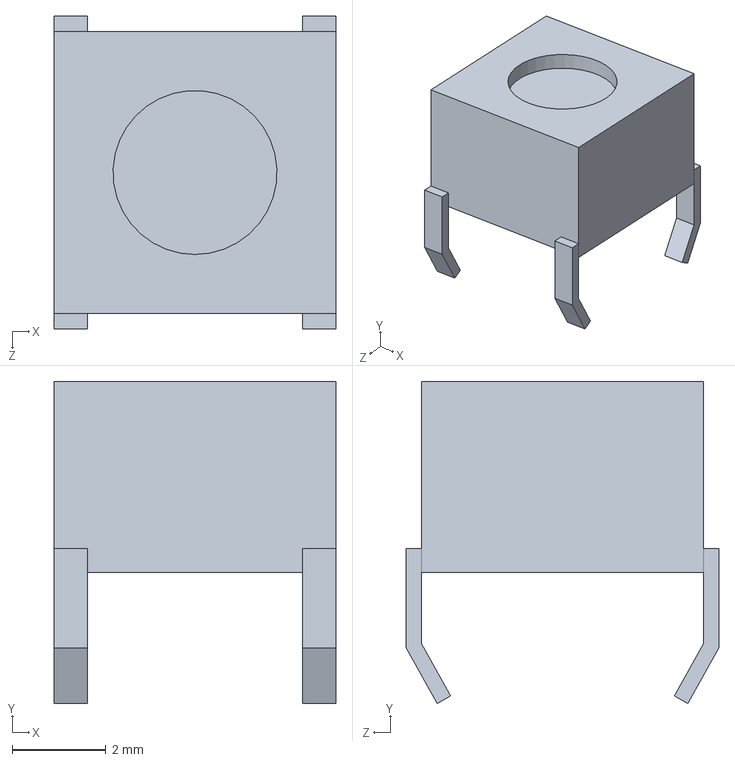
[picture p59: CAD file, 2020-04-07]
3D_model/electronics/TactSwitch/6mm button base.SLDPRT
6.00 x 6.86 x 6.66 mm
