GonzaCerv/noah-hardware/3D_model/electronics/VL53L0X/VL53L0X.SLDPRT

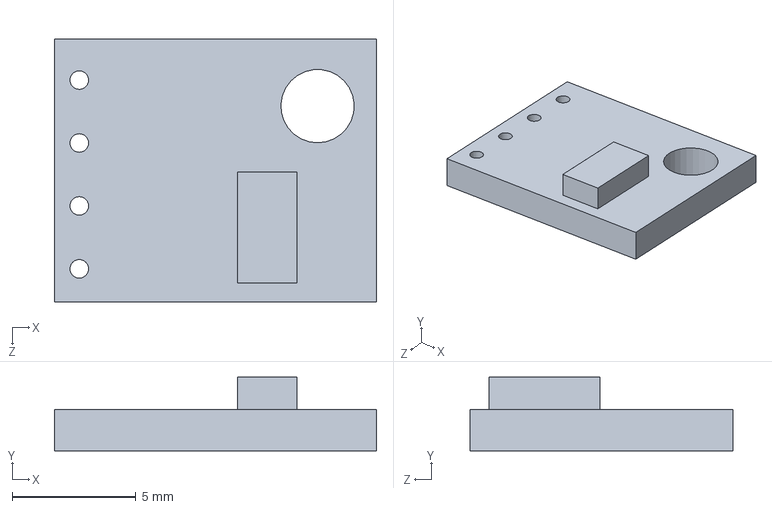
[picture p60: CAD file, 2020-04-07]
3D_model/electronics/VL53L0X/VL53L0X.SLDPRT
13.0 x 2.98 x 10.6 mm
