GonzaCerv/noah-hardware/(list of files, cad)

Other CAD files:
3D_model/electronics/PCB/C8.sldasm
3D_model/electronics/PCB/R8.sldasm
3D_model/electronics/PCB/R30.sldasm
3D_model/electronics/PCB/C32.sldasm
3D_model/electronics/PCB/C24.sldasm
3D_model/electronics/PCB/C51.sldasm
3D_model/electronics/PCB/J7.sldasm
3D_model/electronics/PCB/C7.sldasm
3D_model/electronics/PCB/R5.sldasm
3D_model/electronics/PCB/C43.sldasm
3D_model/electronics/PCB/C47.sldasm
3D_model/electronics/PCB/C37.sldasm
3D_model/electronics/PCB/C1.sldasm
3D_model/electronics/PCB/C39.sldasm
3D_model/electronics/PCB/C36.sldasm
3D_model/electronics/PCB/D3.sldasm
3D_model/electronics/PCB/C17.sldasm
3D_model/electronics/PCB/R24.sldasm
3D_model/electronics/PCB/C49.sldasm
3D_model/electronics/PCB/R13.sldasm
3D_model/electronics/PCB/R29.sldasm
3D_model/electronics/PCB/J9.sldasm
3D_model/electronics/PCB/U4.sldasm
3D_model/electronics/PCB/C12.sldasm
3D_model/electronics/PCB/J2.sldasm
3D_model/electronics/PCB/C4.sldasm
3D_model/electronics/PCB/R1.sldasm
3D_model/electronics/PCB/J3.sldasm
3D_model/electronics/PCB/R6.sldasm
3D_model/electronics/PCB/J4.sldasm
3D_model/electronics/PCB/IC3.sldasm
3D_model/electronics/PCB/R7.sldasm
3D_model/electronics/PCB/R10.sldasm
3D_model/electronics/PCB/R9.sldasm
3D_model/electronics/PCB/C14.sldasm
3D_model/electronics/PCB/C30.sldasm
3D_model/electronics/PCB/C38.sldasm
3D_model/electronics/PCB/D4.sldasm
3D_model/electronics/PCB/R12.sldasm
3D_model/electronics/PCB/GY-91.sldasm
3D_model/electronics/PCB/C28.sldasm
3D_model/electronics/PCB/U3.sldasm
3D_model/electronics/PCB/IC4.sldasm
3D_model/electronics/PCB/R15.sldasm
3D_model/electronics/PCB/C45.sldasm
3D_model/electronics/PCB/U1.sldasm
3D_model/electronics/PCB/R32.sldasm
3D_model/electronics/PCB/C35.sldasm
3D_model/electronics/PCB/R4.sldasm
3D_model/electronics/PCB/R28.sldasm
3D_model/electronics/PCB/C42.sldasm
3D_model/electronics/PCB/IC5.sldasm
3D_model/electronics/PCB/PCB_Component.sldasm
3D_model/electronics/PCB/C44.sldasm
3D_model/electronics/PCB/R26.sldasm
3D_model/electronics/PCB/C48.sldasm
3D_model/electronics/PCB/C9.sldasm
3D_model/electronics/PCB/C41.sldasm
3D_model/electronics/PCB/C46.sldasm
3D_model/electronics/PCB/R33.sldasm
3D_model/electronics/PCB/R21.sldasm
3D_model/electronics/PCB/R19.sldasm
3D_model/electronics/PCB/C22.sldasm
3D_model/electronics/PCB/C3.sldasm
3D_model/electronics/PCB/C33.sldasm
3D_model/electronics/PCB/C20.sldasm
3D_model/electronics/PCB/R17.sldasm
3D_model/electronics/PCB/R11.sldasm
3D_model/electronics/PCB/C19.sldasm
3D_model/electronics/PCB/R14.sldasm
3D_model/electronics/PCB/C25.sldasm
3D_model/electronics/PCB/D1.sldasm
3D_model/electronics/PCB/C18.sldasm
3D_model/electronics/PCB/R18.sldasm
3D_model/electronics/PCB/R22.sldasm
3D_model/electronics/PCB/C10.sldasm
3D_model/electronics/PCB/J1.sldasm
3D_model/electronics/PCB/R34.sldasm
3D_model/electronics/PCB/R2.sldasm
3D_model/electronics/PCB/Q1.sldasm
3D_model/electronics/PCB/C26.sldasm
3D_model/electronics/PCB/C2.sldasm
3D_model/electronics/PCB/U2.sldasm
3D_model/electronics/PCB/C52.sldasm
3D_model/electronics/PCB/RT1.sldasm
3D_model/electronics/PCB/IC6.sldasm
3D_model/electronics/PCB/C16.sldasm
3D_model/electronics/PCB/C23.sldasm
3D_model/electronics/PCB/C27.sldasm
3D_model/electronics/PCB/C31.sldasm
3D_model/electronics/PCB/C50.sldasm
3D_model/electronics/PCB/IC2.sldasm
3D_model/electronics/PCB/R25.sldasm
3D_model/electronics/PCB/R27.sldasm
3D_model/electronics/PCB/C40.sldasm
3D_model/electronics/PCB/R23.sldasm
3D_model/electronics/PCB/C34.sldasm
3D_model/electronics/PCB/R16.sldasm
3D_model/electronics/PCB/C6.sldasm
3D_model/electronics/PCB/R20.sldasm
3D_model/electronics/PCB/C29.sldasm
3D_model/electronics/PCB/C15.sldasm
3D_model/electronics/PCB/J5.sldasm
3D_model/electronics/PCB/J8.sldasm
3D_model/electronics/PCB/R3.sldasm
3D_model/electronics/PCB/D2.sldasm
3D_model/electronics/PCB/R31.sldasm
3D_model/electronics/PCB/J10.sldasm
3D_model/electronics/PCB/C21.sldasm
3D_model/case/top/top_generic.SLDPRT
3D_model/forConstruction/base/noah_base_generic_printed.STL
3D_model/forConstruction/casterjoint/noah/C000_printed.STL
3D_model/forConstruction/front/front_noah_printed.STL
3D_model/forConstruction/pcb_bolder/noah/power_button_printed.STL
3D_model/forConstruction/shelf/shelf_noah_printed.STL
3D_model/case/base/base_noah.SLDPRT
3D_model/case/casterjoint/noah/BALL40MM.SLDPRT
3D_model/case/casterjoint/noah/BALL6MM.SLDPRT
3D_model/case/casterjoint/noah/C00.SLDPRT
3D_model/case/casterjoint/noah/C000.SLDPRT
3D_model/case/casterjoint/noah/C001.SLDPRT
3D_model/case/casterjoint/noah/C01.SLDPRT
3D_model/case/casterjoint/noah/C02.SLDPRT
3D_model/case/pcb_bolder/noah/pcb_holder_noah.SLDPRT
3D_model/case/shelf/shelf_noah.SLDPRT
3D_model/case/support/generic/Spacer10mm.SLDPRT
3D_model/case/support/generic/Spacer50mm.SLDPRT
3D_model/case/support/generic/back_left.SLDPRT
3D_model/case/support/generic/back_right.SLDPRT
3D_model/case/top/top_noah.SLDPRT
3D_model/case/wheel/noah/Adapter2.SLDPRT
3D_model/case/wheel/noah/B02.SLDPRT
3D_model/case/wheel/noah/B021.SLDPRT
3D_model/case/wheel/printed/B021.SLDPRT
3D_model/electronics/18650bat/BMS.SLDPRT
3D_model/electronics/18650bat/ELEB04.SLDPRT
3D_model/electronics/18650bat/ELEB05.SLDPRT
3D_model/electronics/Arduino/L298/Clamp Body 2x.SLDPRT
3D_model/electronics/Arduino/L298/Cooler Blok.SLDPRT
3D_model/electronics/Arduino/L298/L298 Board.SLDPRT
3D_model/electronics/Arduino/L298/L298N Regulator.SLDPRT
3D_model/electronics/Arduino/L298/Metal Clamp Part.SLDPRT
3D_model/electronics/Arduino/L298/Vida M3x4.5.SLDPRT
3D_model/electronics/JA25-371-12v motor/Axis.SLDPRT
3D_model/electronics/JA25-371-12v motor/Gearbox.SLDPRT
3D_model/electronics/JA25-371-12v motor/Magnet.SLDPRT
3D_model/electronics/JA25-371-12v motor/Motor.SLDPRT
3D_model/electronics/JA25-371-12v motor/PCB.SLDPRT
3D_model/electronics/JA25-371-12v motor/hub.SLDPRT
3D_model/electronics/LCD-1.8/1.8_inches_128x160_RGB_TFT_LCD.ipt
3D_model/electronics/LCD-1.8/LCD_1.8.SLDPRT
3D_model/electronics/Misc/Tactile_Switch_SMD.SLDPRT
3D_model/electronics/N20 Micromotor/Motor.SLDPRT
3D_model/electronics/PCB/('pin'.sldprt
3D_model/electronics/PCB/('pin'_10.sldprt
3D_model/electronics/PCB/('pin'_11.sldprt
3D_model/electronics/PCB/('pin'_2.sldprt
3D_model/electronics/PCB/('pin'_3.sldprt
3D_model/electronics/PCB/('pin'_4.sldprt
3D_model/electronics/PCB/('pin'_5.sldprt
3D_model/electronics/PCB/('pin'_6.sldprt
3D_model/electronics/PCB/('pin'_7.sldprt
3D_model/electronics/PCB/('pin'_8.sldprt
3D_model/electronics/PCB/('pin'_9.sldprt
3D_model/electronics/PCB/2.54MM1X8.sldprt
3D_model/electronics/PCB/861464560.sldasm
3D_model/electronics/PCB/861617032.sldasm
3D_model/electronics/PCB/861619208.sldasm
3D_model/electronics/PCB/861619344.sldprt
3D_model/electronics/PCB/861628320.sldasm
3D_model/electronics/PCB/861628456.sldasm
3D_model/electronics/PCB/861628592.sldasm
3D_model/electronics/PCB/861628728.sldasm
3D_model/electronics/PCB/861628864.sldasm
3D_model/electronics/PCB/861629000.sldasm
3D_model/electronics/PCB/861629136.sldasm
3D_model/electronics/PCB/861629272.sldasm
3D_model/electronics/PCB/861629408.sldasm
3D_model/electronics/PCB/861629544.sldasm
3D_model/electronics/PCB/977575040.sldprt
3D_model/electronics/PCB/977575296.sldprt
3D_model/electronics/PCB/977576320.sldasm
3D_model/electronics/PCB/977576448.sldasm
3D_model/electronics/PCB/977576576.sldasm
3D_model/electronics/PCB/977576704.sldasm
3D_model/electronics/PCB/977576832.sldasm
3D_model/electronics/PCB/977576960.sldprt
3D_model/electronics/PCB/977577088.sldasm
3D_model/electronics/PCB/977577216.sldasm
3D_model/electronics/PCB/977577344.sldasm
3D_model/electronics/PCB/977577472.sldasm
3D_model/electronics/PCB/977577600.sldasm
3D_model/electronics/PCB/977577728.sldasm
3D_model/electronics/PCB/977577984.sldasm
3D_model/electronics/PCB/977578112.sldasm
3D_model/electronics/PCB/977578368.sldasm
3D_model/electronics/PCB/BMP280AU.sldprt
3D_model/electronics/PCB/Base.sldprt
3D_model/electronics/PCB/Base_2.sldprt
3D_model/electronics/PCB/Base_3.sldprt
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
