GonzaCerv/noah-hardware/Doc/assembly_noah.md

# Mechanics assembly

## Table of Contents

- [Mechanics assembly](#mechanics-assembly)
  - [Table of Contents](#table-of-contents)
  - [About ](#about-)
  - [Parts required ](#parts-required-)
  - [Electronics ](#electronics-)
    - [Assembly of power button ](#assembly-of-power-button-)
    - [Assembly of pcb holder ](#assembly-of-pcb-holder-)
  - [Mechanics ](#mechanics-)
    - [Assembly of Caster joint ](#assembly-of-caster-joint-)
    - [Assembly of wheel adapter ](#assembly-of-wheel-adapter-)
    - [Assembly front ](#assembly-front-)
    - [Assembly base ](#assembly-base-)

----------

## About 

This file lists all the necessary steps in order to assembly the mechanics of the robot.

----------

## Parts required 

In order to build the robot you will need some 3D printed parts, some laser cut parts and some vitamins (parts that must be bought). All the models are inside **3D_model**. 
the files required for materialization are available [here](../3D_model/forConstruction/). In case you need to modify the parts to suit your requirements you can have access to the designs in the [case](../3D_model/case/) section. The designs were made on SolidWorks 2019

You can see that all the parts are grouped into folders. Each folder represent a type of piece that is needed to build the robot. You will need at least one piece of each folder in to build it. multiple designs will be implemented and stored on the same folders. In order to identify the right piece for your project, look for the same project name, for example **_generic** or **_noah** (most of the parts of the same type are interchangeable). 

The most biggest parts (base, top and shelf) are designed to be laser cut but it was also provided the files for 3D printing.

3D printed elementary parts:

|Parts | Quantity | 
|---|---|
| front | 1 |
| C000 | 1 |
| C001 | 1 |
| Adapter1 | 2 |
| Adapter2 | 2 |
| base | 1 |
| top | 1 |
| shelf | 1 |

If you are going to use Noah board V2:

|Parts | Quantity | 
|---|---|
| pcb_holder | 1 |
| power_button | 1 |

These are the vitamins, parts that are neither printed nor laser cut.
 
|Parts | Quantity | 
|---|---|
| 10mm M3 screw | 38 |
| 10mm M3 washer | 42 |
| 10mm M3 nut | 20 |
| 50mm M3 separator | 6 |
| 100mm roller wheel | 2 | 
| 6mm steel ball | 3 | 

----------

## Electronics 

----------

### Assembly of power button 

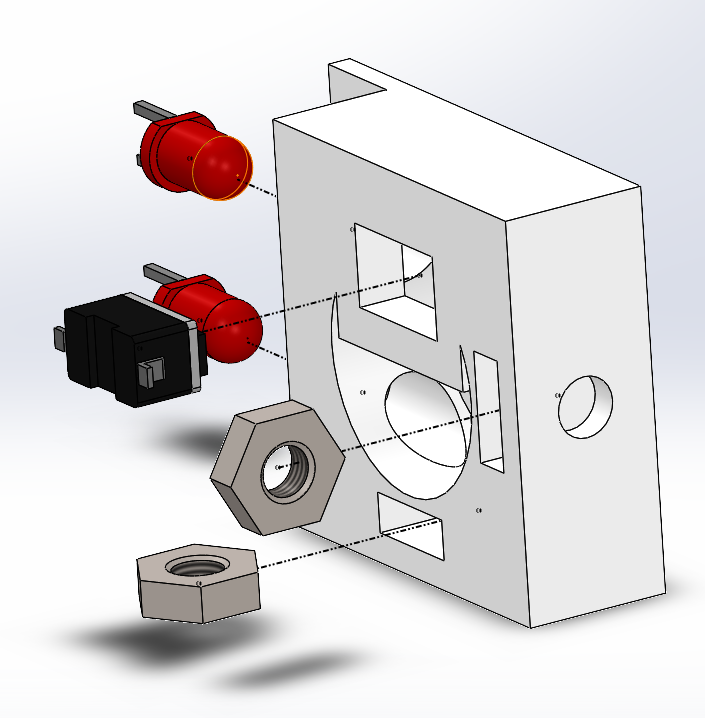
[picture p70: Doc/images/assembly_power_button.png]
</a>

### Assembly of pcb holder 

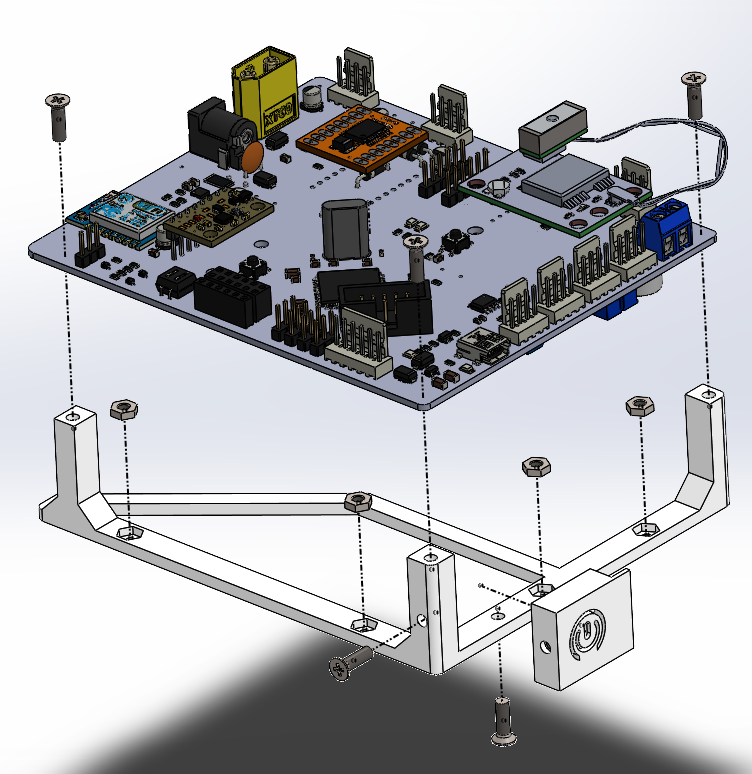
[picture p71: Doc/images/assembly_pcb_support.png]
</a>

----------

## Mechanics 

----------

### Assembly of Caster joint 

Project logo</a>

### Assembly of wheel adapter 

Project logo</a>

### Assembly front 

Project logo</a>

### Assembly base 

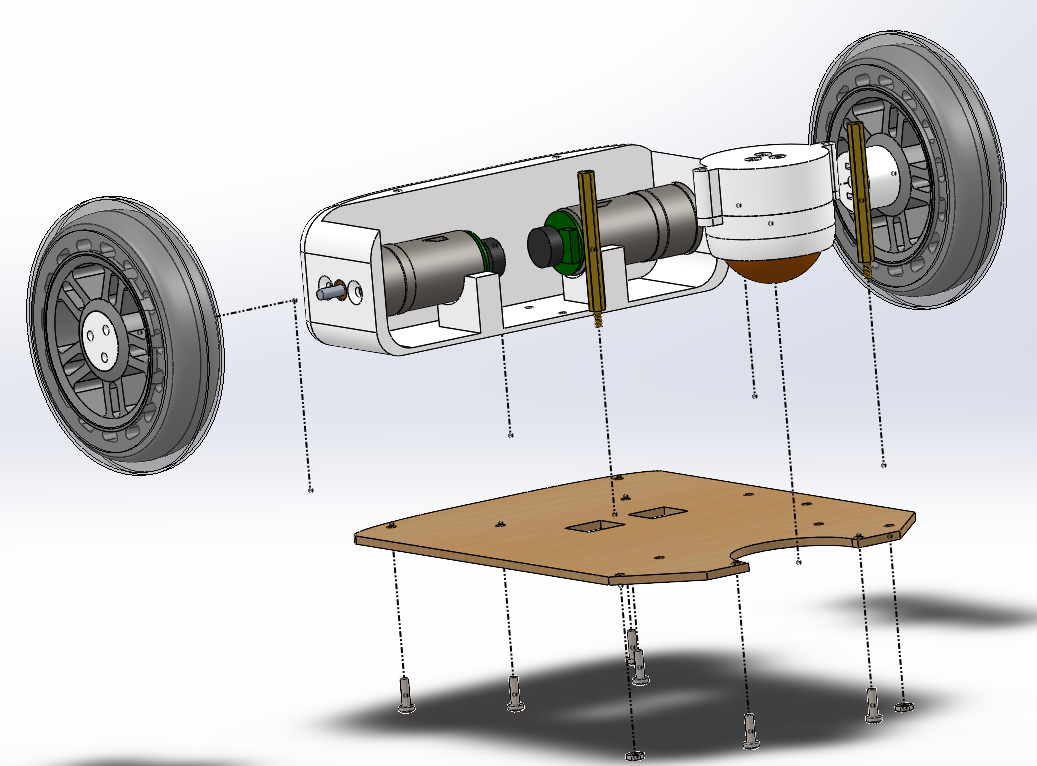
[picture p72: Doc/images/assembly_base_1.png]
</a>

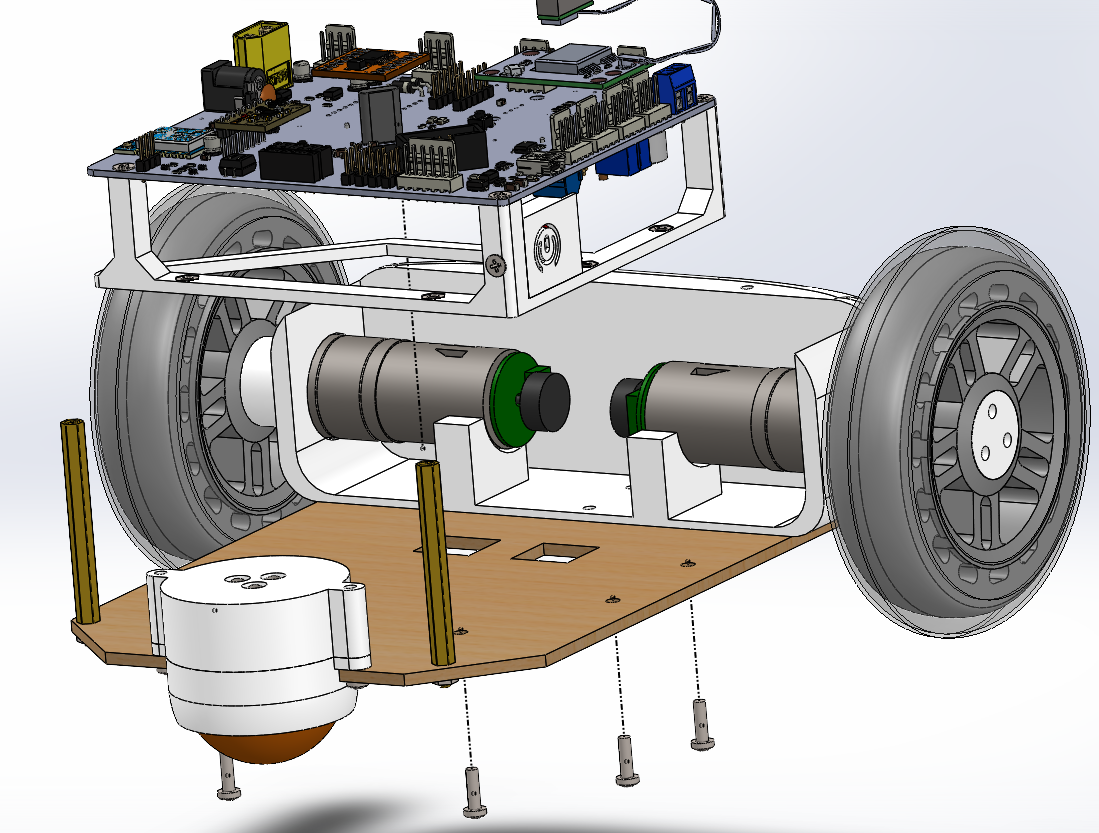
[picture p73: Doc/images/assembly_base_2.png]
</a>

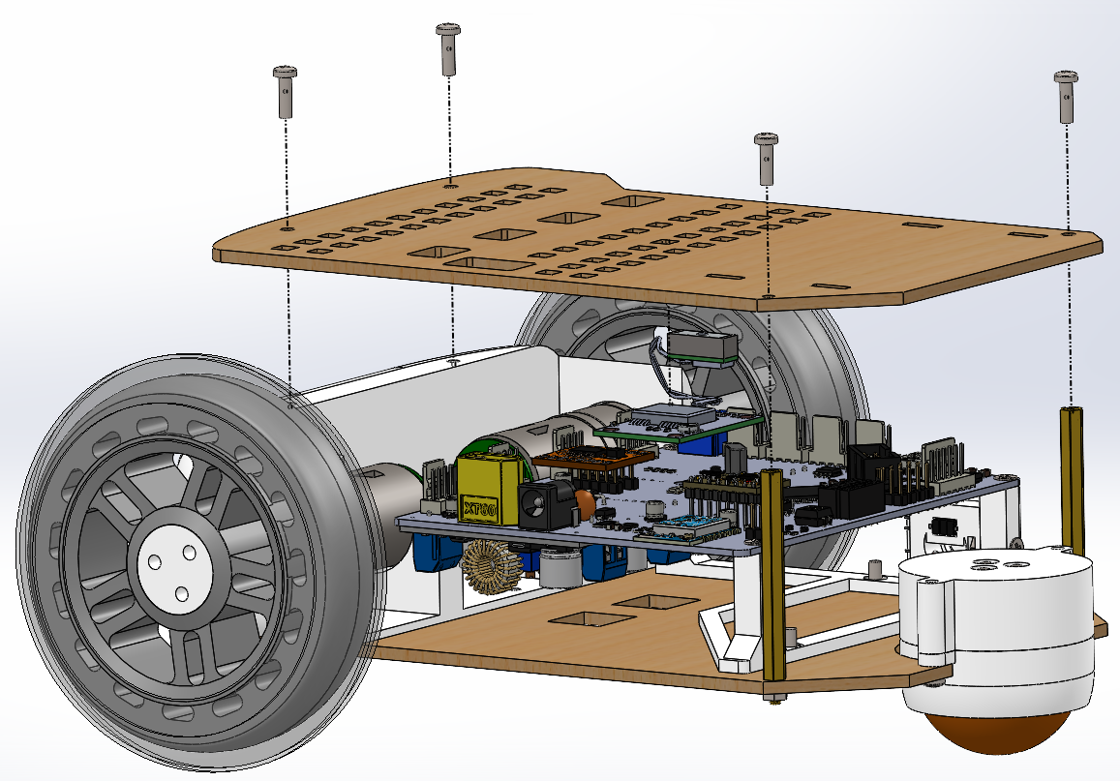
[picture p74: Doc/images/assembly_base_3.png]
</a>

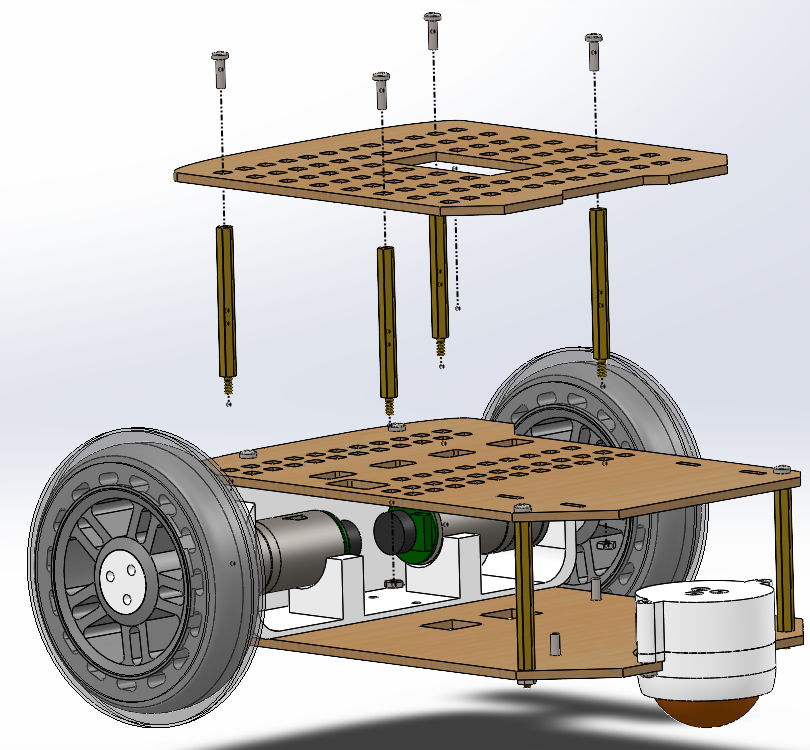
[picture p75: Doc/images/assembly_base_4.png]
</a>
