GonzaCerv/noah-hardware/(threads)

Thread 16 (2021-04-27):

Add BOM of materials

GonzaCerv, 2021-04-27:
I need some file which lists the elements I need to build the robot

rje1974, 2021-04-27:
I do not understand what you mean. In other projects we use a [simple spreadsheet file like this](https://docs.google.com/spreadsheets/d/1Sx_uUpSsDXjSyWeXivDuVfrgE3z1wKk2N7qOIa2kCy0/edit?usp=sharing).

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
