GonzaCerv/noah-hardware/3D_model/forConstruction/base/base_generic_laser.PDF

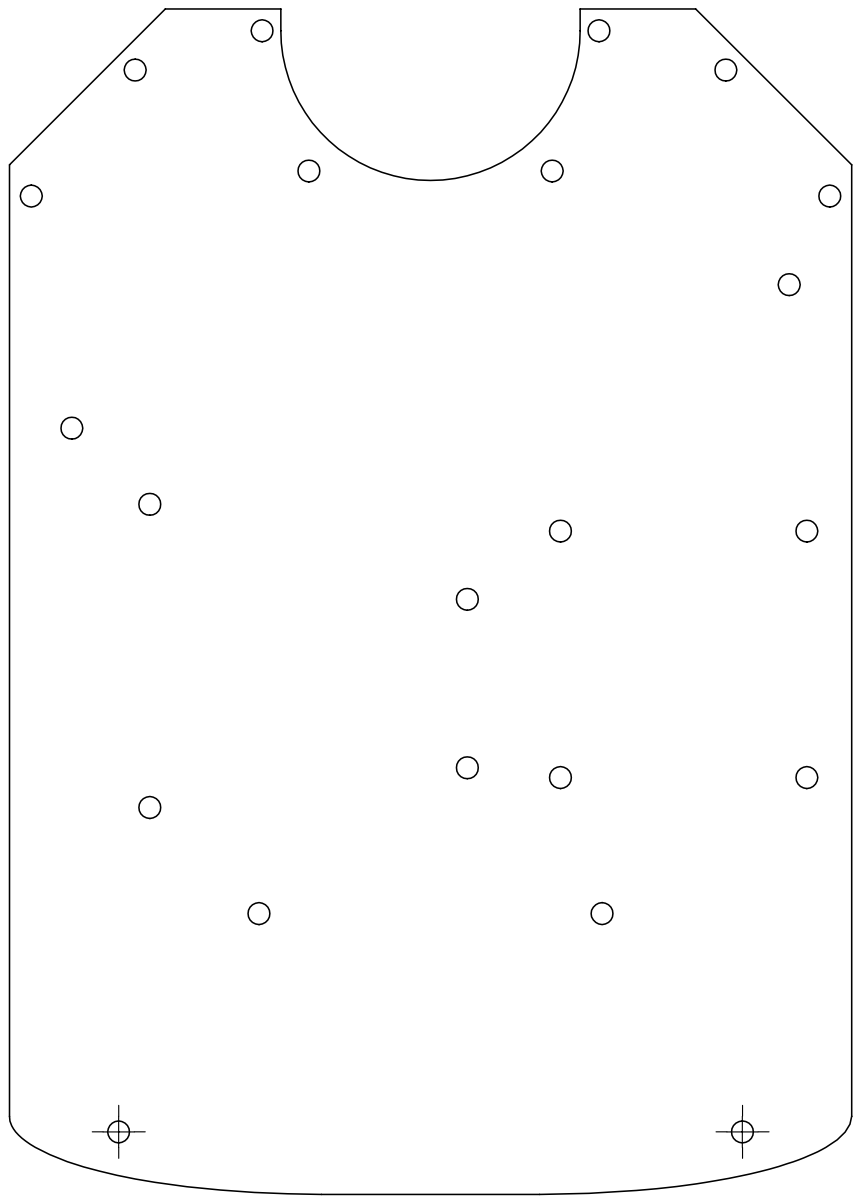
[picture p76: page 1]
