GonzaCerv/noah-hardware/3D_model/forConstruction/shelf/shelf_noah_laser.PDF

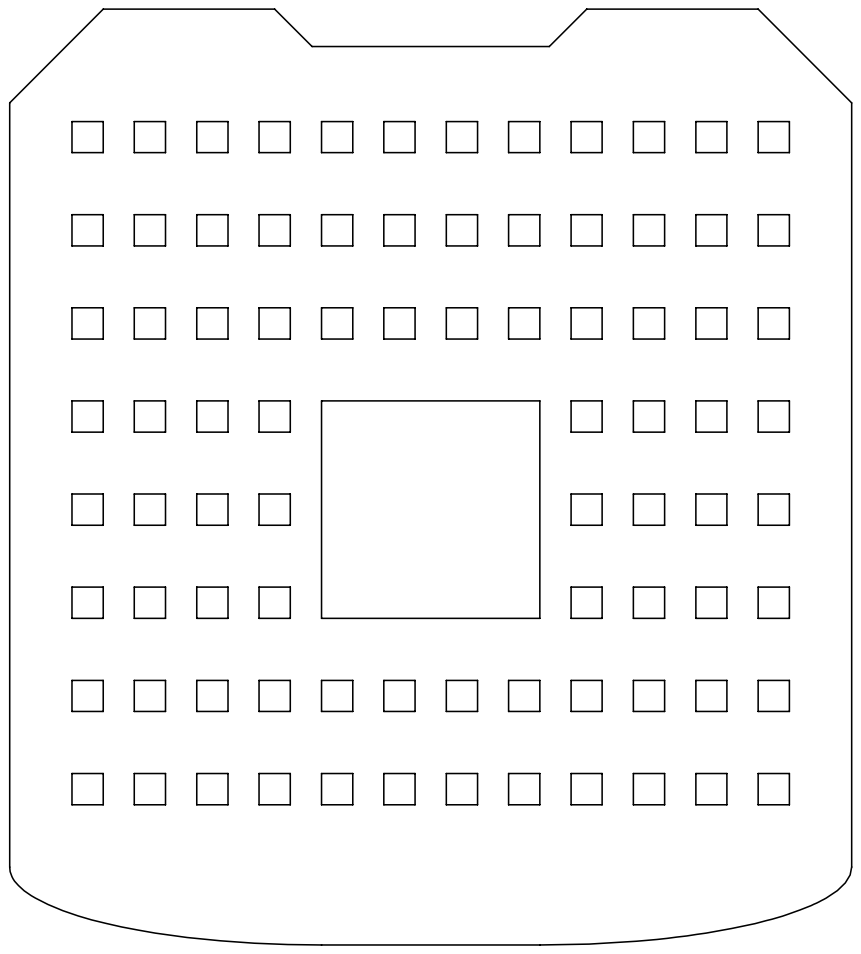
[picture p77: page 1]
