GonzaCerv/noah-hardware/3D_model/forConstruction/top/top_generic_laser.PDF

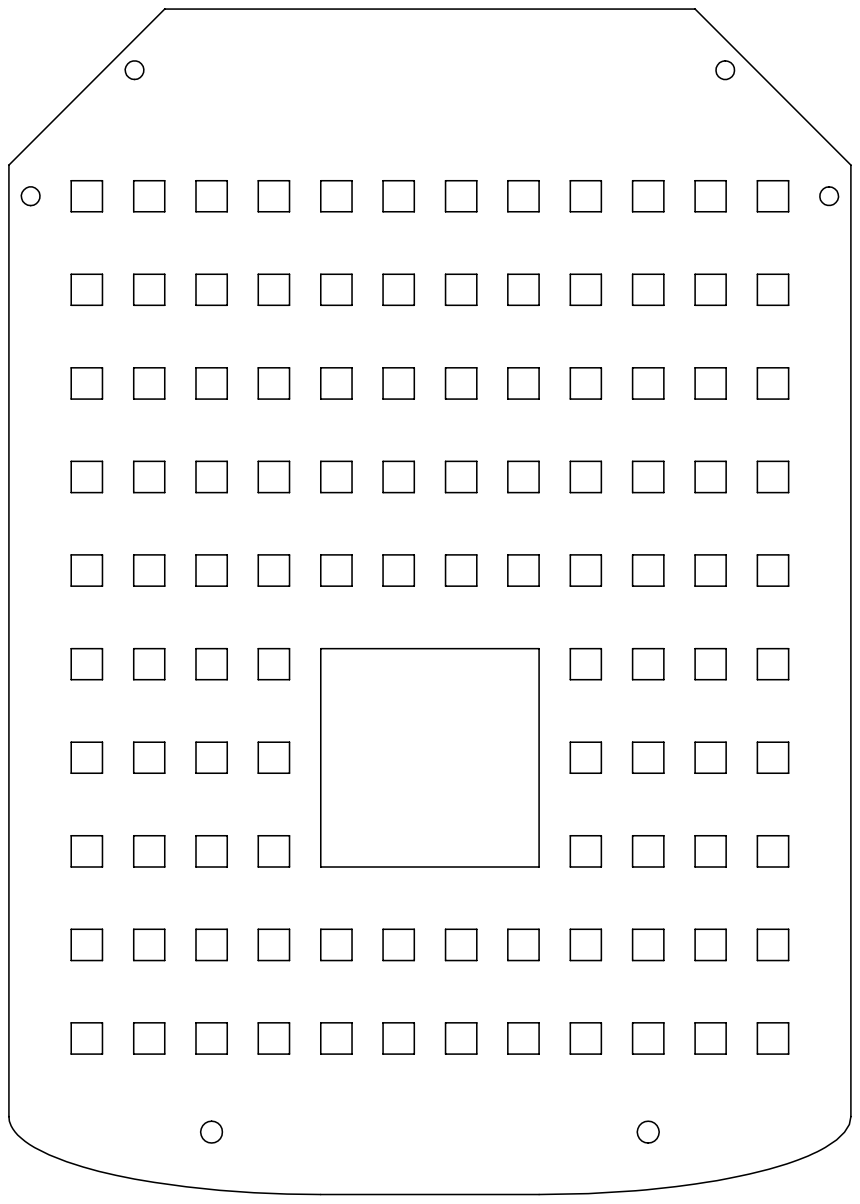
[picture p78: page 1]
