GonzaCerv/noah-hardware/3D_model/forConstruction/base/noah_base_laser.pdf

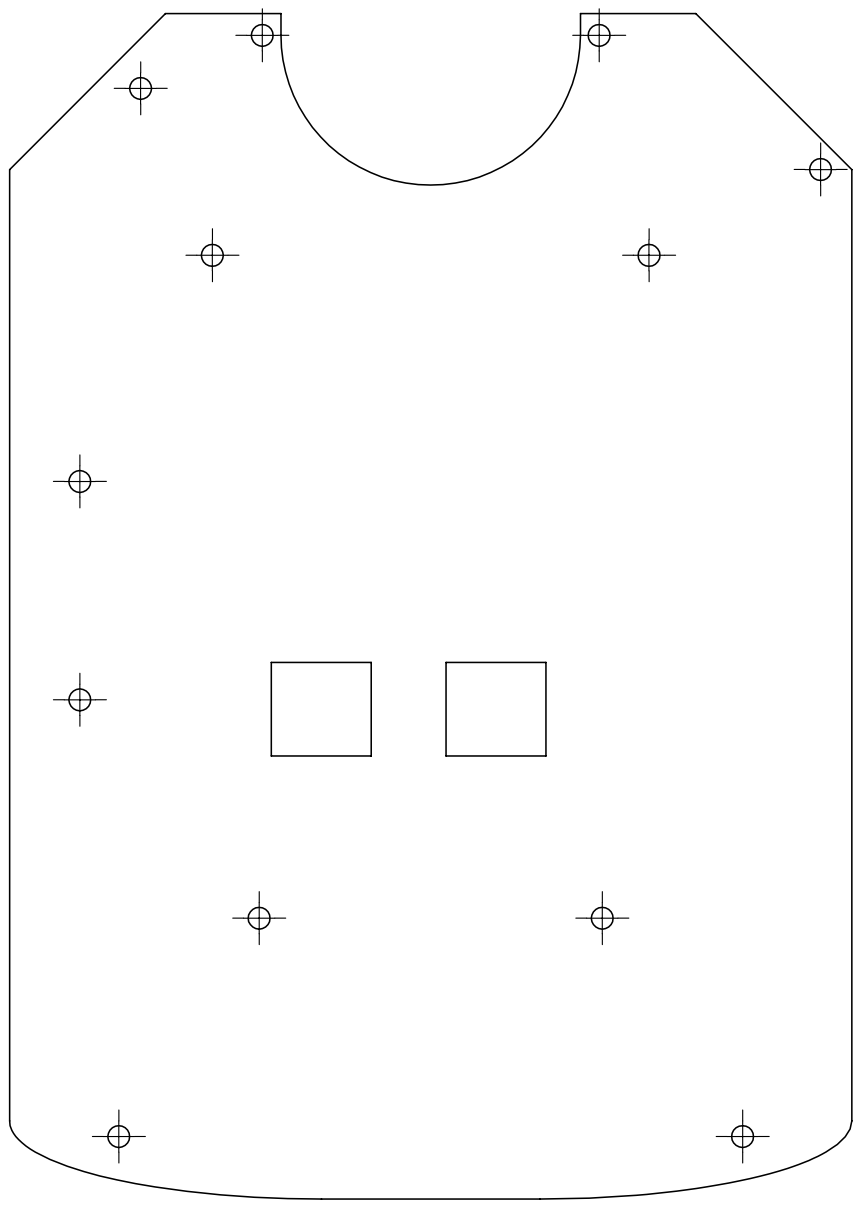
[picture p79: page 1]
