GonzaCerv/noah-hardware/3D_model/forConstruction/top/top_noah_laser.PDF

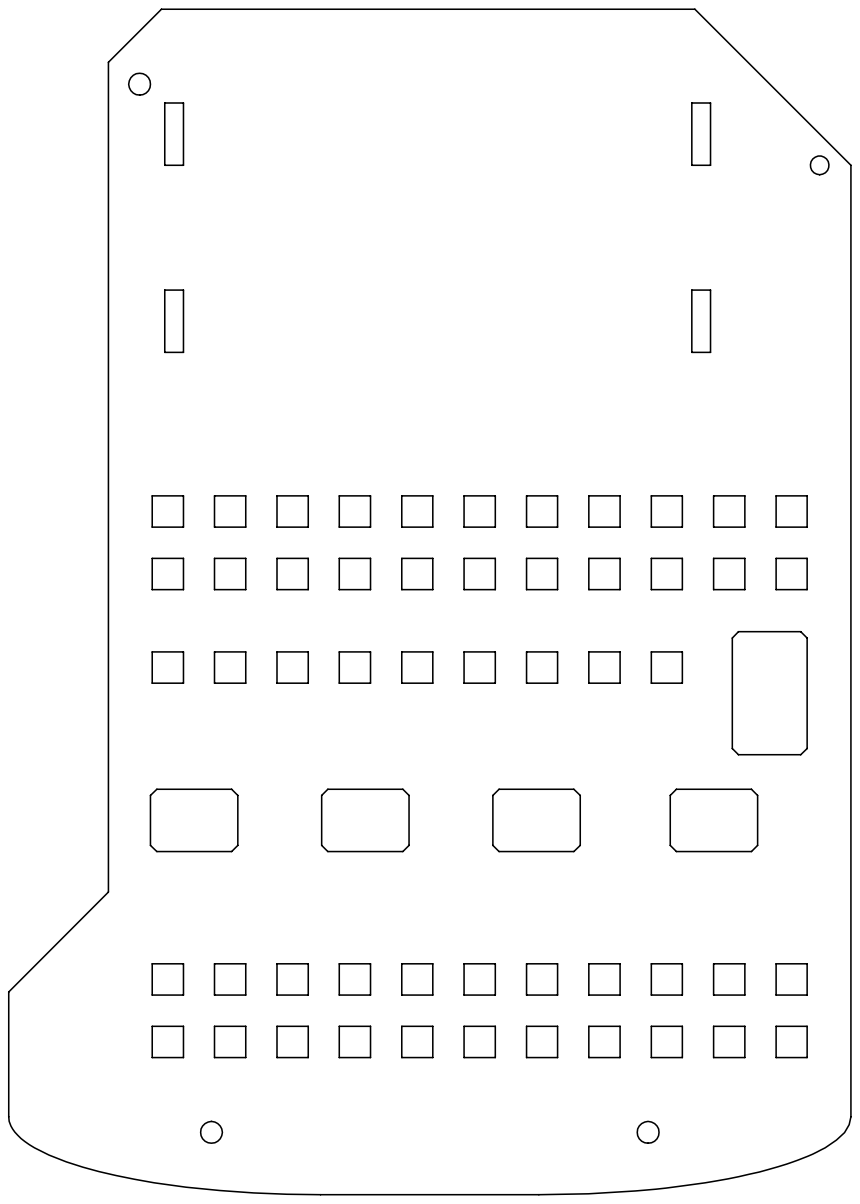
[picture p80: page 1]
