GonzaCerv/noah-hardware/PCB/root.kicad_pcb

## KiCad design PCB/root.kicad_pcb (2020-09-16)

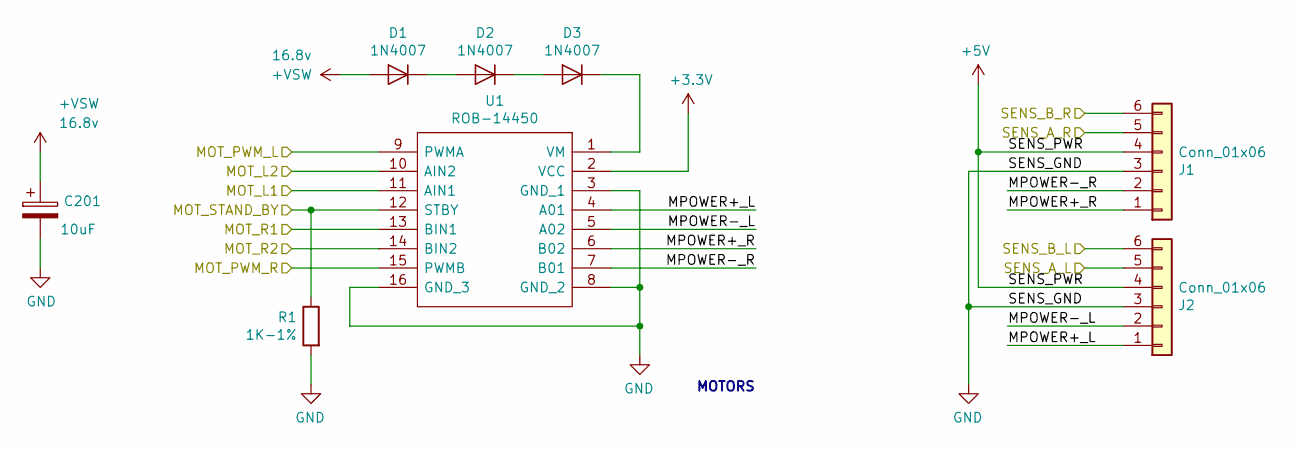
[picture p81: schematic Motors.sch]

Parts:
C201: 10uF; CP_Elec_4x4.5
D1, D2, D3: 1N4007; D_DO-41_SOD81_P10.16mm_Horizontal
J1, J2: Conn_01x06; PinHeader_1x06_P2.54mm_Vertical
R1: 1K-1%; R_0805_2012Metric_Pad1.15x1.40mm_HandSolder
U1: ROB-14450; ROB14450; Manufacturer_Part_Number ROB-14450; Mouser Part Number 474-ROB-14450

Connections:
+3V3: U1.2 (VCC); also elsewhere on the board
+5V: J1.4, J2.4; also elsewhere on the board
+VSW: C201.1, D1.2 (A); also elsewhere on the board
/Microcontroller/MOT_L1: U1.11 (AIN1); also elsewhere on the board
/Microcontroller/MOT_L2: U1.10 (AIN2); also elsewhere on the board
/Microcontroller/MOT_PWM_L: U1.9 (PWMA); also elsewhere on the board
/Microcontroller/MOT_PWM_R: U1.15 (PWMB); also elsewhere on the board
/Microcontroller/MOT_R1: U1.13 (BIN1); also elsewhere on the board
/Microcontroller/MOT_R2: U1.14 (BIN2); also elsewhere on the board
/Microcontroller/MOT_STAND_BY: R1.1, U1.12 (STBY); also elsewhere on the board
/Microcontroller/SENS_A_L: J2.5; also elsewhere on the board
/Microcontroller/SENS_A_R: J1.5; also elsewhere on the board
/Microcontroller/SENS_B_L: J2.6; also elsewhere on the board
/Microcontroller/SENS_B_R: J1.6; also elsewhere on the board
/Motors/MPOWER+_L: J2.1, U1.4 (A01)
/Motors/MPOWER+_R: J1.1, U1.6 (B02)
/Motors/MPOWER-_L: J2.2, U1.5 (A02)
/Motors/MPOWER-_R: J1.2, U1.7 (B01)
GND: C201.2, J1.3, J2.3, R1.2, U1.3 (GND_1), U1.8 (GND_2), U1.16 (GND_3); also elsewhere on the board
unnamed: D1.1 (K), D2.2 (A)
unnamed: D2.1 (K), D3.2 (A)
unnamed: D3.1 (K), U1.1 (VM)

Notes on the sheet:
MOTORS

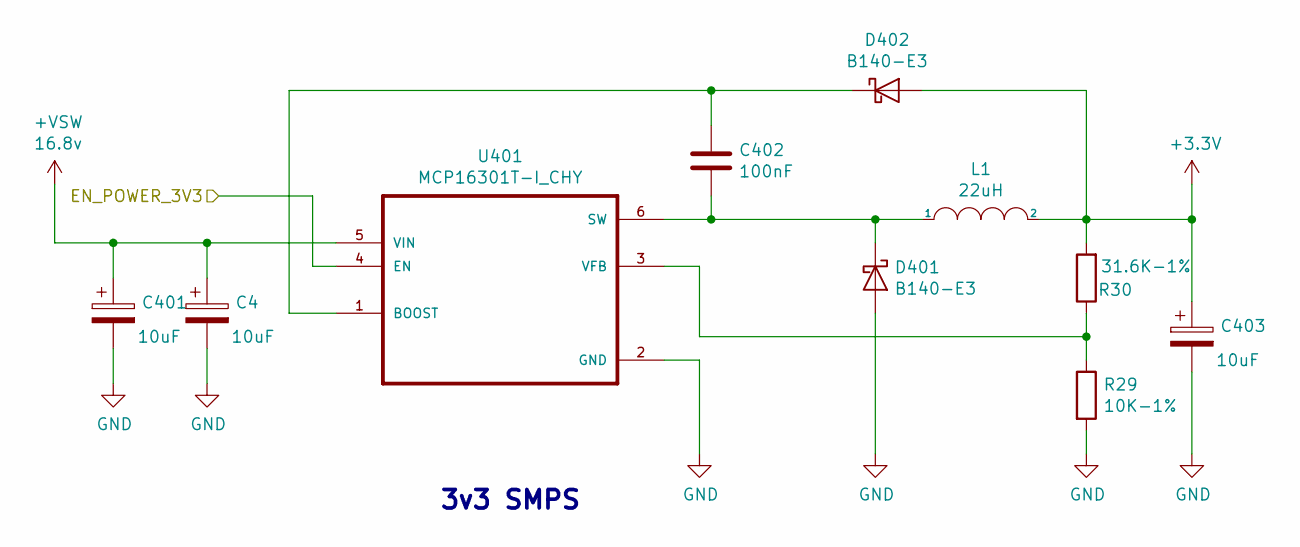
[picture p82: schematic MC34063.sch]

Parts:
C4, C401, C403: 10uF; CP_Elec_4x4.5
C402: 100nF; C_0805_2012Metric_Pad1.15x1.40mm_HandSolder
D401, D402: B140-E3; D_SMA
L1: 22uH; L_Bourns_SRN8040TA
R29: 10K-1%; R_0805_2012Metric_Pad1.15x1.40mm_HandSolder
R30: 31.6K-1%; R_0805_2012Metric_Pad1.15x1.40mm_HandSolder
U401: MCP16301T-I_CHY; SOT95P270X145-6N

Connections:
+3V3: C403.1, D402.2 (A), L1.2, R30.2; also elsewhere on the board
+VSW: C4.1, C401.1, U401.5 (VIN); also elsewhere on the board
/MC34063/EN_POWER_3V3: U401.4 (EN); also elsewhere on the board
GND: C4.2, C401.2, C403.2, D401.2 (A), R29.2, U401.2 (GND); also elsewhere on the board
unnamed: C402.1, D401.1 (K), L1.1, U401.6 (SW)
unnamed: C402.2, D402.1 (K), U401.1 (BOOST)
unnamed: R29.1, R30.1, U401.3 (VFB)

Notes on the sheet:
3v3 SMPS

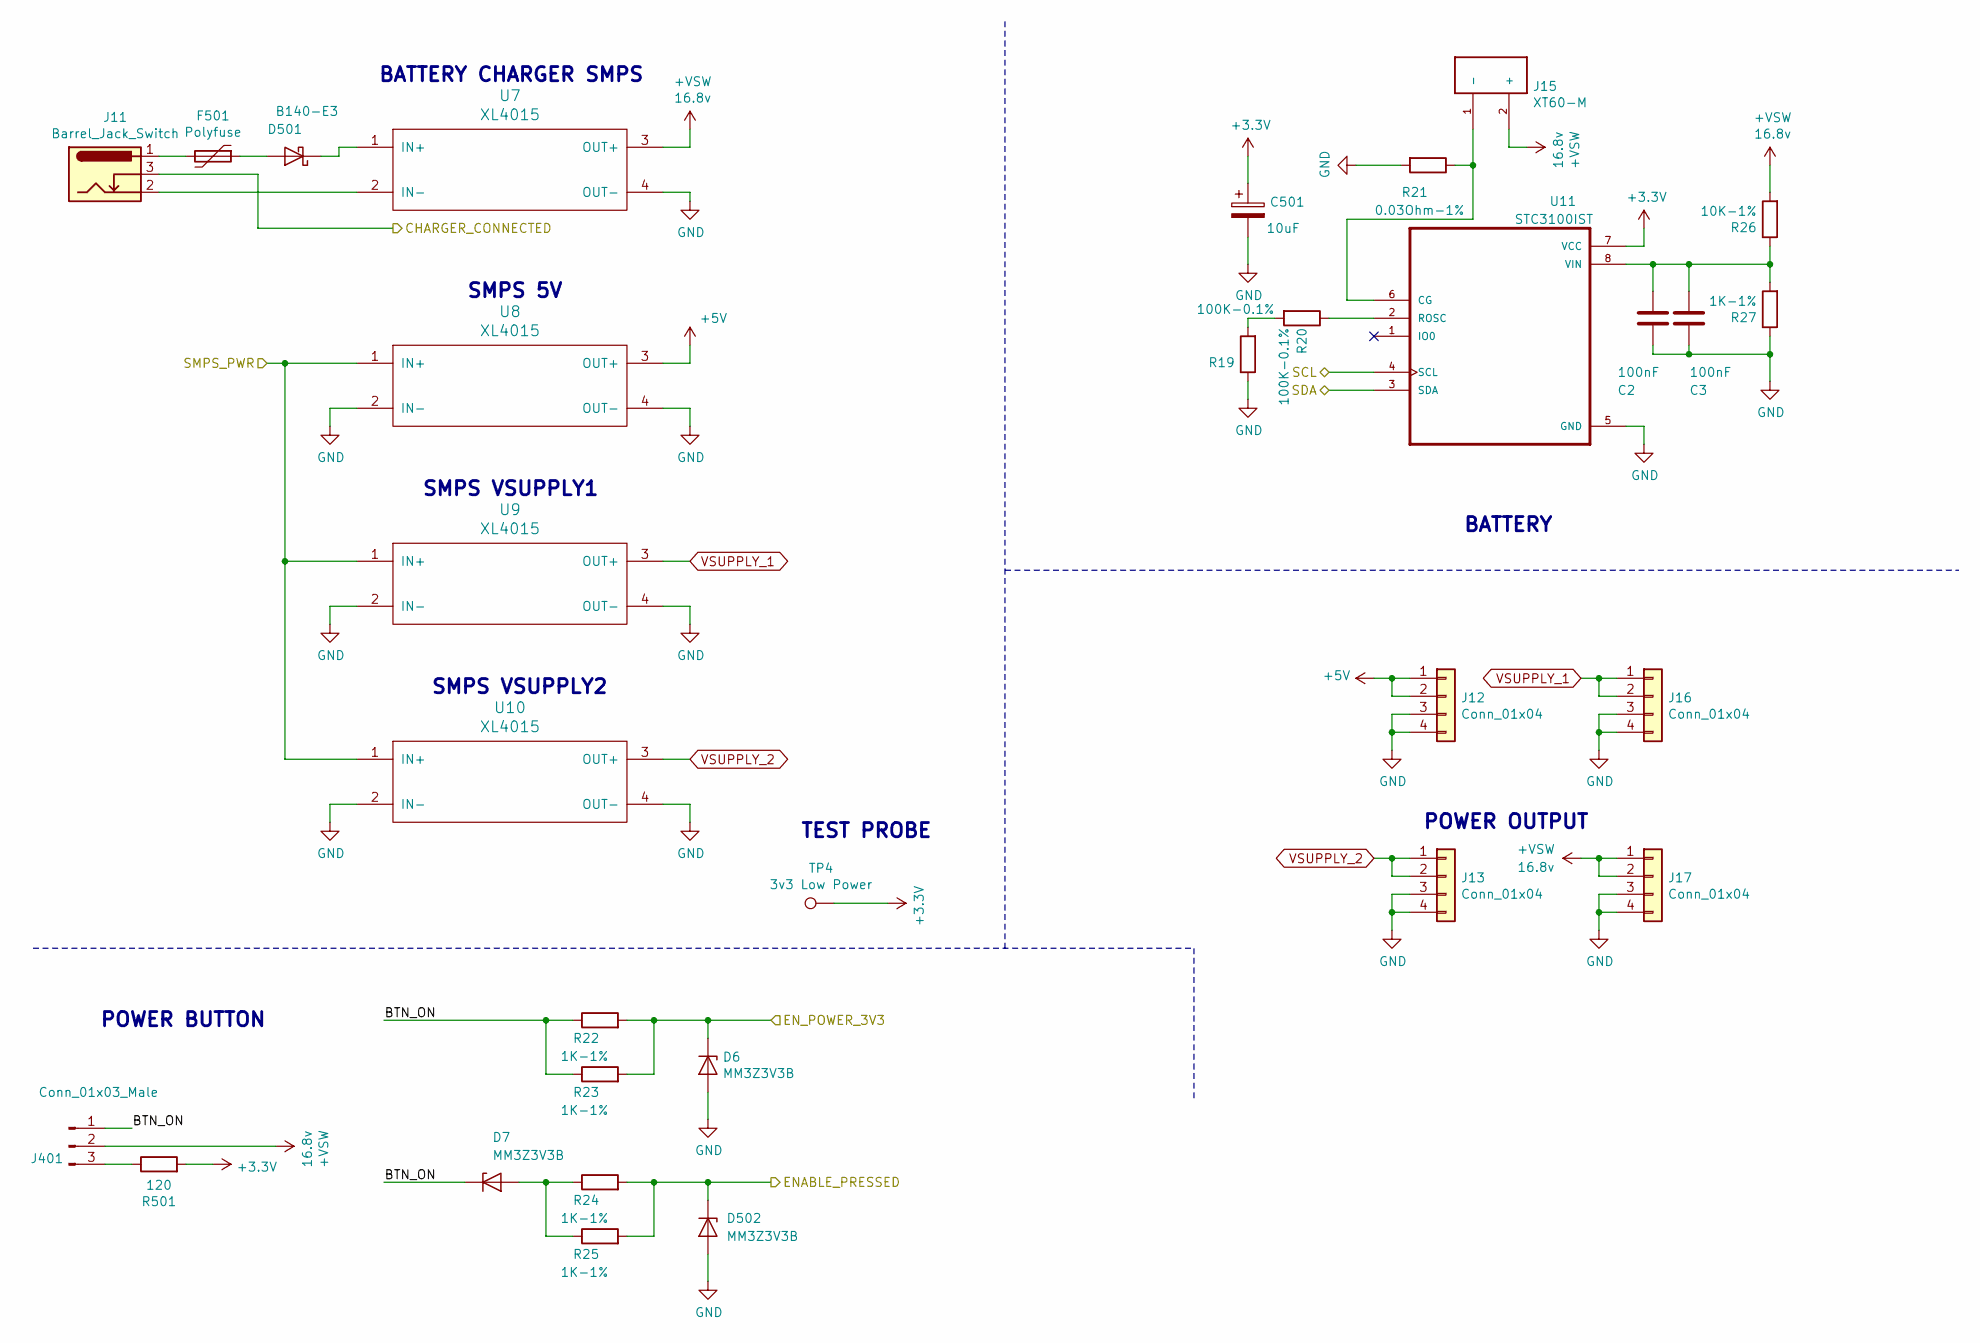
[picture p83: schematic Supply.sch]

Parts:
C2, C3: 100nF; C_0805_2012Metric_Pad1.15x1.40mm_HandSolder
C501: 10uF; CP_Elec_4x4.5
D6, D7, D502: MM3Z3V3B; D_SOD-323_HandSoldering
D501: B140-E3; D_SMA
F501: Polyfuse; C_Disc_D7.5mm_W2.5mm_P5.00mm
J11: Barrel_Jack_Switch; BarrelJack_Wuerth_6941xx301002
J12, J13, J16, J17: Conn_01x04; Molex_KK-254_AE-6410-04A_1x04_P2.54mm_Vertical
J15: XT60-M; AMASS_XT60-M
J401: Conn_01x03_Male; PinHeader_1x03_P2.54mm_Vertical
R19, R20: 100K-0.1%; R_0805_2012Metric_Pad1.15x1.40mm_HandSolder
R21: 0.03Ohm-1%; R_2512_6332Metric
R22, R23, R24, R25, R27: 1K-1%; R_0805_2012Metric_Pad1.15x1.40mm_HandSolder
R26: 10K-1%; R_0805_2012Metric_Pad1.15x1.40mm_HandSolder
R501: 120; R_0805_2012Metric_Pad1.15x1.40mm_HandSolder
TP4: 3v3 Low Power; TestPoint_Pad_D3.0mm
U7, U8, U9, U10: XL4015; XL4015_Converter
U11: STC3100IST; DFN-8-1EP_3x3mm_P0.5mm_EP1.66x2.38mm

Connections:
+3V3: C501.1, R501.2, TP4.1, U11.7 (VCC); also elsewhere on the board
+5V: J12.1, J12.2, U8.3 (OUT+); also elsewhere on the board
+VSW: J15.2 (+), J17.1, J17.2, J401.2, R26.2, U7.3 (OUT+); also elsewhere on the board
/MC34063/EN_POWER_3V3: D6.1 (K), R22.2, R23.2; also elsewhere on the board
/Microcontroller/CHARGER_CONNECTED: J11.3; also elsewhere on the board
/Microcontroller/ENABLE_PRESSED: D502.1 (K), R24.2, R25.2; also elsewhere on the board
/Microcontroller/I2C_SCL: U11.4 (SCL); also elsewhere on the board
/Microcontroller/I2C_SDA: U11.3 (SDA); also elsewhere on the board
/Peripheral/SMPS_PWR: U8.1 (IN+), U9.1 (IN+), U10.1 (IN+); also elsewhere on the board
/Supply/BTN_ON: D7.1 (K), J401.1, R22.1, R23.1
GND: C2.2, C3.2, C501.2, D6.2 (A), D502.2 (A), J12.3, J12.4, J13.3, J13.4, J16.3, J16.4, J17.3, J17.4, R19.1, R21.2, R27.1, U7.4 (OUT-), U8.2 (IN-), U8.4 (OUT-), U9.2 (IN-), U9.4 (OUT-), U10.2 (IN-), U10.4 (OUT-), U11.5 (GND); also elsewhere on the board
unnamed: C2.1, C3.1, R26.1, R27.2, U11.8 (VIN)
unnamed: D7.2 (A), R24.1, R25.1
unnamed: D501.1 (K), U7.1 (IN+)
unnamed: D501.2 (A), F501.1
unnamed: F501.2, J11.1
unnamed: J11.2, U7.2 (IN-)
unnamed: J15.1 (-), R21.1, U11.6 (CG)
unnamed: J401.3, R501.1
unnamed: R19.2, R20.2
unnamed: R20.1, U11.2 (ROSC)
VSUPPLY_1: J16.1, J16.2, U9.3 (OUT+)
VSUPPLY_2: J13.1, J13.2, U10.3 (OUT+)

Notes on the sheet:
POWER OUTPUT
BATTERY CHARGER SMPS
POWER BUTTON
BATTERY
SMPS 5V
SMPS VSUPPLY1
SMPS VSUPPLY2
TEST PROBE

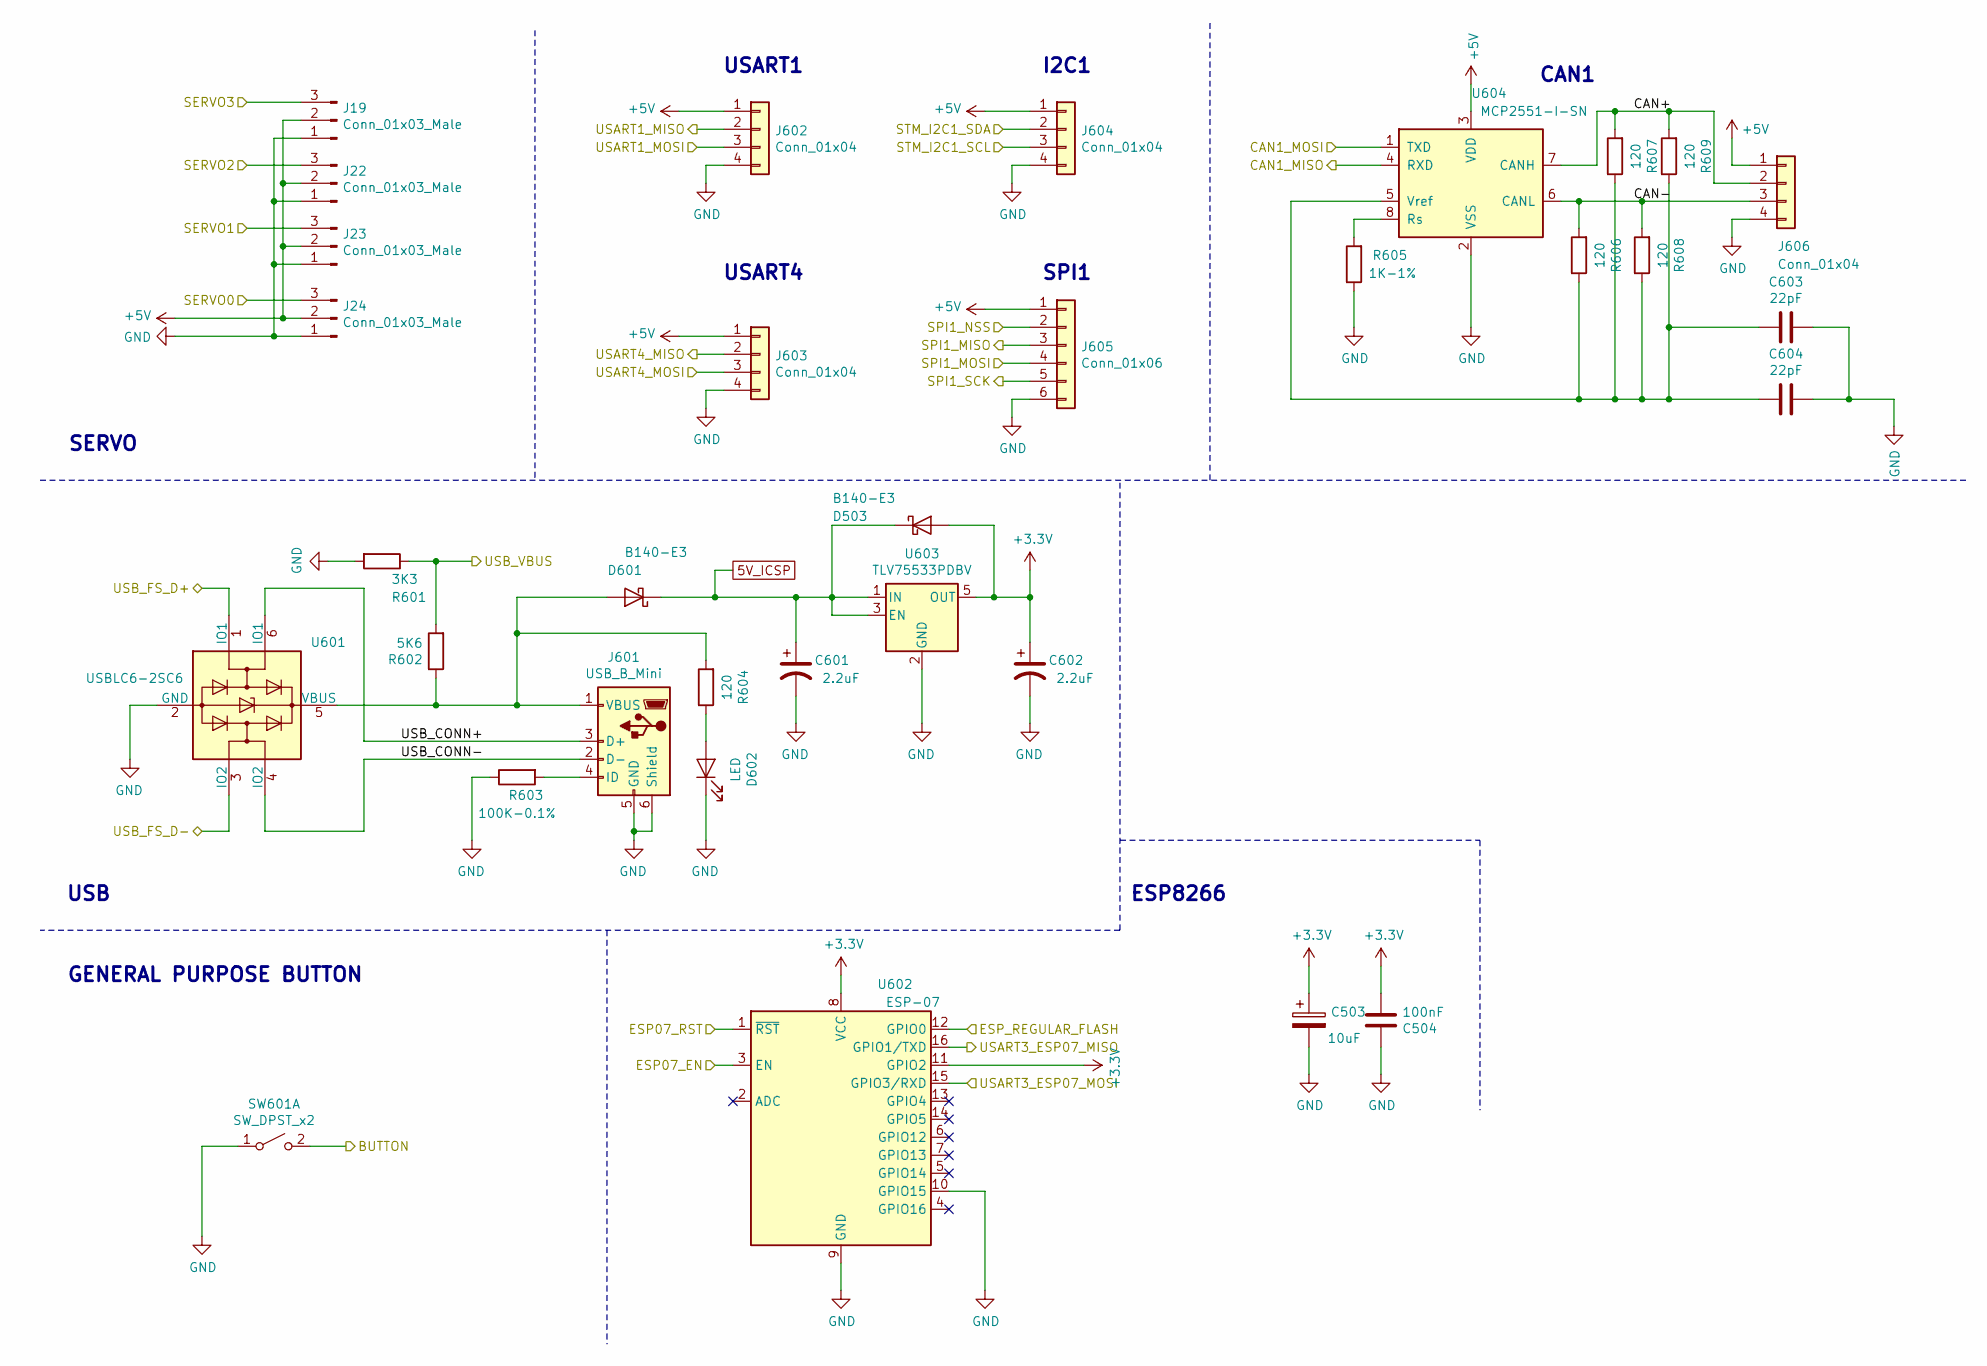
[picture p84: schematic Peripheral2.sch]

Parts:
C503: 10uF; CP_Elec_4x4.5
C504: 100nF; C_0805_2012Metric_Pad1.15x1.40mm_HandSolder
C601, C602: 2.2uF; C_1206_3216Metric_Pad1.42x1.75mm_HandSolder
C603, C604: 22pF; C_0603_1608Metric_Pad1.05x0.95mm_HandSolder
D503, D601: B140-E3; D_SMA
D602: LED; LED_1206_3216Metric_Pad1.42x1.75mm_HandSolder
J19, J22, J23, J24: Conn_01x03_Male; PinHeader_1x03_P2.54mm_Vertical
J601: USB_B_Mini; USB_Mini-B_Lumberg_2486_01_Horizontal
J602, J603, J604, J606: Conn_01x04; Molex_KK-254_AE-6410-04A_1x04_P2.54mm_Vertical
J605: Conn_01x06; Molex_KK-254_AE-6410-06A_1x06_P2.54mm_Vertical
R601: 3K3; R_0805_2012Metric_Pad1.15x1.40mm_HandSolder
R602: 5K6; R_0805_2012Metric_Pad1.15x1.40mm_HandSolder
R603: 100K-0.1%; R_0805_2012Metric_Pad1.15x1.40mm_HandSolder
R604, R606, R607, R608, R609: 120; R_0805_2012Metric_Pad1.15x1.40mm_HandSolder
R605: 1K-1%; R_0805_2012Metric_Pad1.15x1.40mm_HandSolder
SW601: SW_DPST_x2; SW_SPST_EVPBF
U601: USBLC6-2SC6; SOT-23-6
U602: ESP-07
U603: TLV75533PDBV; SOT-23-5
U604: MCP2551-I-SN; SOIC-8_3.9x4.9mm_P1.27mm

Connections:
5V_ICSP: C601.1, D503.1 (K), D601.1 (K), U603.1 (IN), U603.3 (EN); also elsewhere on the board
+3V3: C503.1, C504.1, C602.1, D503.2 (A), U602.8 (VCC), U602.11 (GPIO2), U603.5 (OUT); also elsewhere on the board
+5V: J19.2, J22.2, J23.2, J24.2, J602.1, J603.1, J604.1, J605.1, J606.1, U604.3 (VDD); also elsewhere on the board
/Microcontroller/BUTTON: SW601.2 (B); also elsewhere on the board
/Microcontroller/CAN1_MISO: U604.4 (RXD); also elsewhere on the board
/Microcontroller/CAN1_MOSI: U604.1 (TXD); also elsewhere on the board
/Microcontroller/ESP07_EN: U602.3 (EN); also elsewhere on the board
/Microcontroller/ESP07_RST: U602.1 (~RST); also elsewhere on the board
/Microcontroller/ESP_REGULAR_FLASH: U602.12 (GPIO0); also elsewhere on the board
/Microcontroller/I2C_SCL: J604.3; also elsewhere on the board
/Microcontroller/I2C_SDA: J604.2; also elsewhere on the board
/Microcontroller/SERVO0: J24.3; also elsewhere on the board
/Microcontroller/SERVO1: J23.3; also elsewhere on the board
/Microcontroller/SERVO2: J22.3; also elsewhere on the board
/Microcontroller/SERVO3: J19.3; also elsewhere on the board
/Microcontroller/SPI1_MISO: J605.3; also elsewhere on the board
/Microcontroller/SPI1_MOSI: J605.4; also elsewhere on the board
/Microcontroller/SPI1_NSS: J605.2; also elsewhere on the board
/Microcontroller/SPI1_SCK: J605.5; also elsewhere on the board
/Microcontroller/USART1_MISO: J602.2; also elsewhere on the board
/Microcontroller/USART1_MOSI: J602.3; also elsewhere on the board
/Microcontroller/USART3_ESP07_MISO: U602.16 (GPIO1/TXD); also elsewhere on the board
/Microcontroller/USART3_ESP07_MOSI: U602.15 (GPIO3/RXD); also elsewhere on the board
/Microcontroller/USART4_MISO: J603.2; also elsewhere on the board
/Microcontroller/USART4_MOSI: J603.3; also elsewhere on the board
/Microcontroller/USB_FS_D+: U601.1 (IO1); also elsewhere on the board
/Microcontroller/USB_FS_D-: U601.3 (IO2); also elsewhere on the board
/Microcontroller/USB_FS_VBUS: R601.1, R602.2; also elsewhere on the board
/Peripheral2/CAN+: J606.2, R607.2, R609.2, U604.7 (CANH)
/Peripheral2/CAN-: J606.3, R606.2, R608.2, U604.6 (CANL)
/Peripheral2/USB_CONN+: J601.3 (D+), U601.6 (IO1)
/Peripheral2/USB_CONN-: J601.2 (D-), U601.4 (IO2)
GND: C503.2, C504.2, C601.2, C602.2, C603.1, C604.1, D602.1 (K), J19.1, J22.1, J23.1, J24.1, J601.5 (GND), J601.6 (Shield), J602.4, J603.4, J604.4, J605.6, J606.4, R601.2, R603.1, R605.1, SW601.1 (A), U601.2 (GND), U602.9 (GND), U602.10 (GPIO15), U603.2 (GND), U604.2 (VSS); also elsewhere on the board
unnamed: C603.2, C604.2, R606.1, R607.1, R608.1, R609.1, U604.5 (Vref)
unnamed: D601.2 (A), J601.1 (VBUS), R602.1, R604.2, U601.5 (VBUS)
unnamed: D602.2 (A), R604.1
unnamed: J601.4 (ID), R603.2
unnamed: R605.2, U604.8 (Rs)

Notes on the sheet:
USART1
SERVO
USB
GENERAL PURPOSE BUTTON
CAN1
ESP8266
USART4
SPI1
I2C1

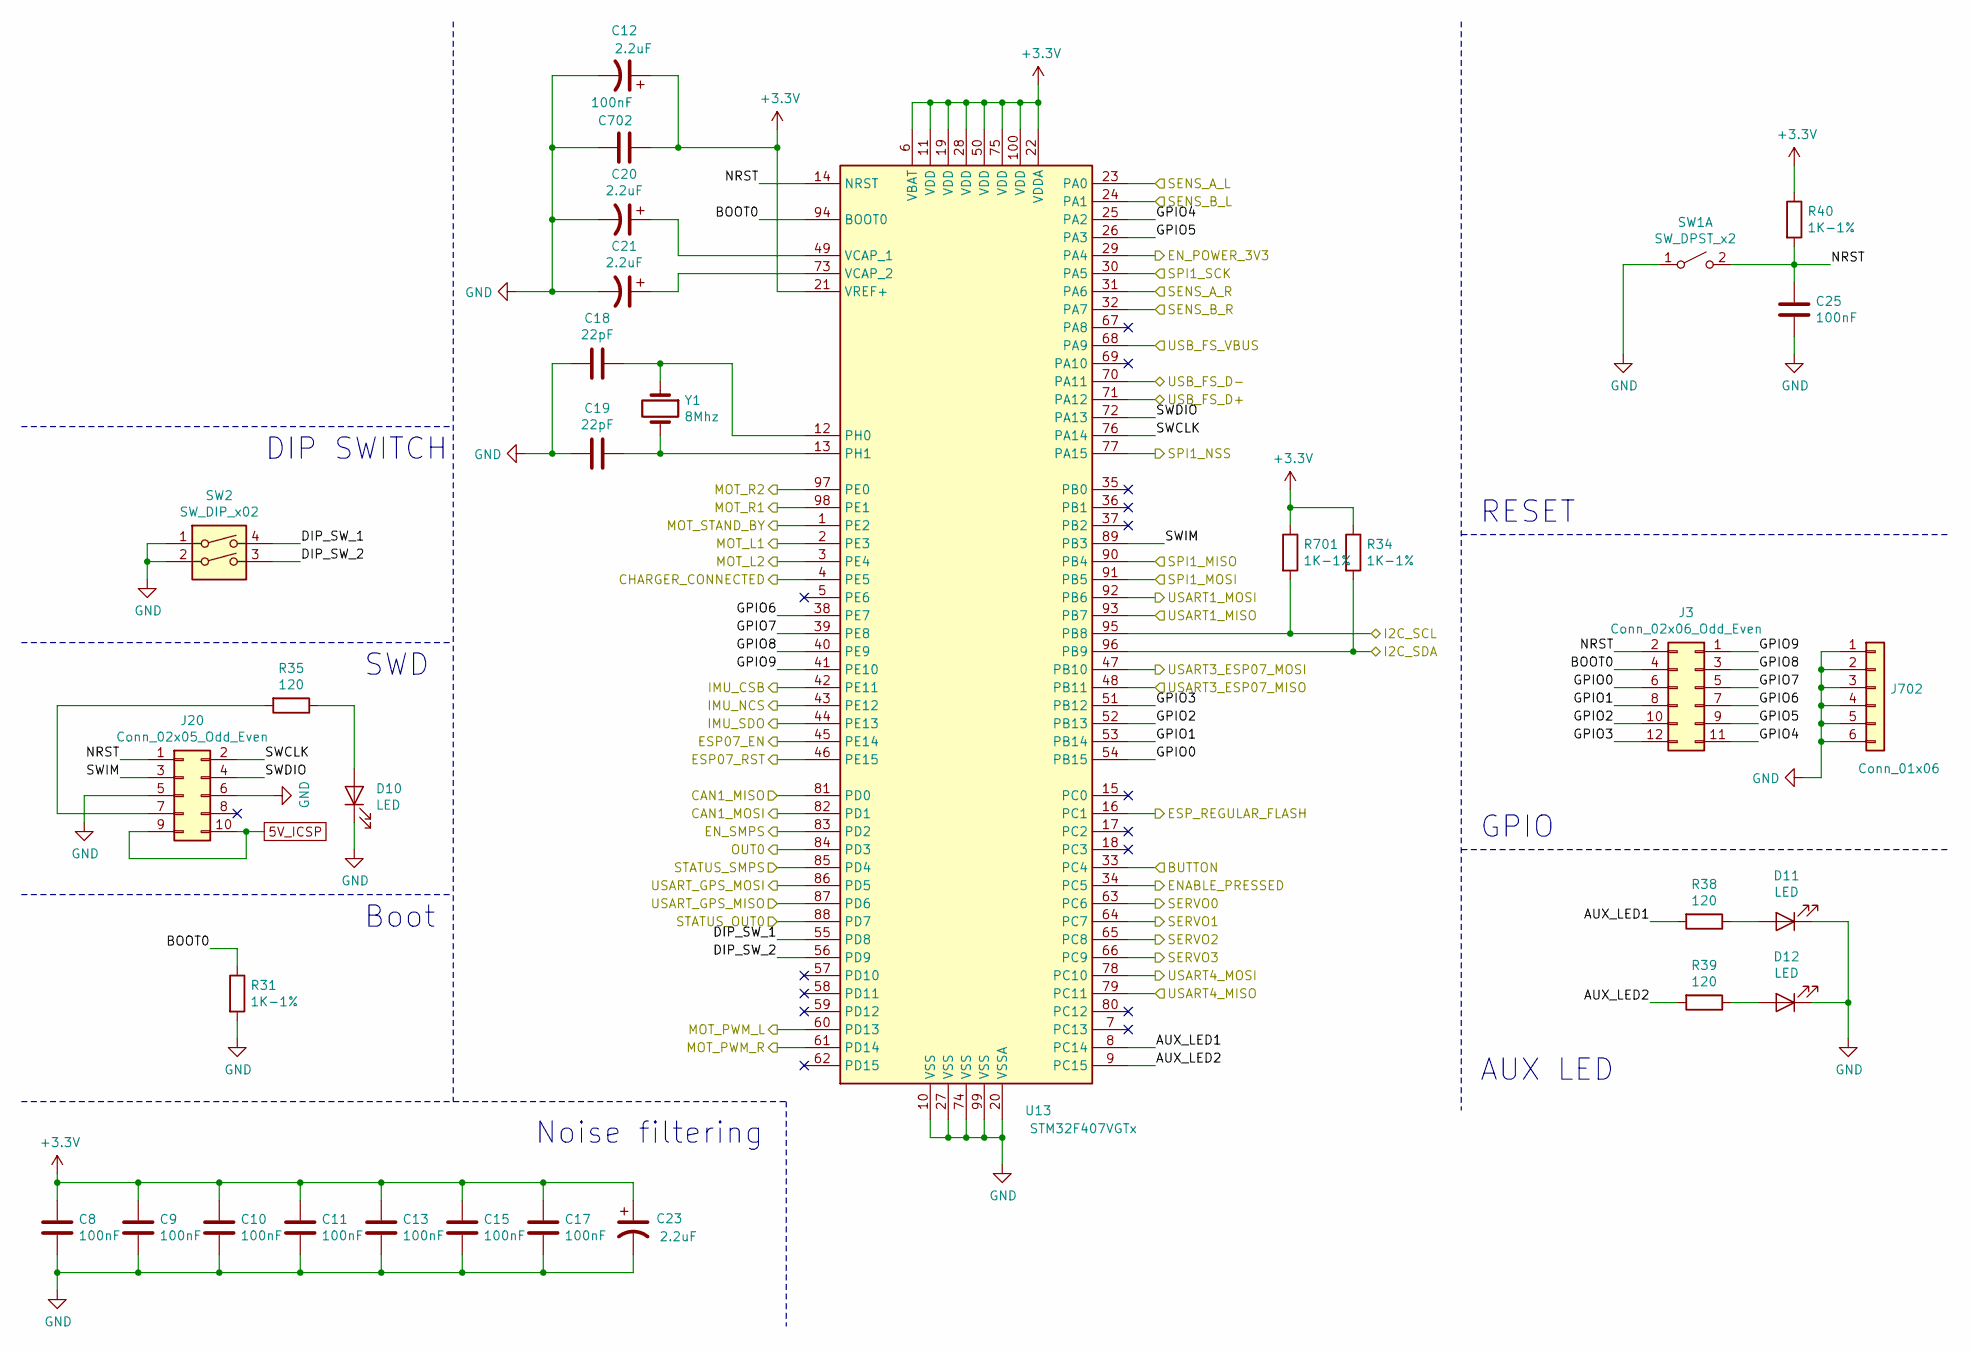
[picture p85: schematic Microcontroller.sch]

Parts:
C8, C9, C10, C11, C13, C15, C17, C25, C702: 100nF; C_0805_2012Metric_Pad1.15x1.40mm_HandSolder
C12, C20, C21, C23: 2.2uF; C_1206_3216Metric_Pad1.42x1.75mm_HandSolder
C18, C19: 22pF; C_0603_1608Metric_Pad1.05x0.95mm_HandSolder
D10, D11, D12: LED; LED_1206_3216Metric_Pad1.42x1.75mm_HandSolder
J3: Conn_02x06_Odd_Even; PinSocket_2x06_P2.54mm_Vertical
J20: Conn_02x05_Odd_Even; IDC-Header_2x05_P2.54mm_Vertical
J702: Conn_01x06; PinSocket_1x06_P2.54mm_Vertical
R31, R34, R40, R701: 1K-1%; R_0805_2012Metric_Pad1.15x1.40mm_HandSolder
R35, R38, R39: 120; R_0805_2012Metric_Pad1.15x1.40mm_HandSolder
SW1: SW_DPST_x2; SW_SPST_EVPBF
SW2: SW_DIP_x02; SW_DIP_SPSTx02_Slide_6.7x6.64mm_W7.62mm_P2.54mm_LowProfile
U13: STM32F407VGTx; LQFP-100_14x14mm_P0.5mm
Y1: 8Mhz; Crystal_HC49-U_Vertical

Connections:
5V_ICSP: J20.9, J20.10; also elsewhere on the board
+3V3: C8.2, C9.2, C10.2, C11.2, C12.1, C13.2, C15.2, C17.2, C23.1, C702.1, R34.1, R40.1, R701.1, U13.6 (VBAT), U13.11 (VDD), U13.19 (VDD), U13.21 (VREF+), U13.22 (VDDA), U13.28 (VDD), U13.50 (VDD), U13.75 (VDD), U13.100 (VDD); also elsewhere on the board
/MC34063/EN_POWER_3V3: U13.29 (PA4); also elsewhere on the board
/Microcontroller/AUX_LED1: R38.2, U13.8 (PC14)
/Microcontroller/AUX_LED2: R39.2, U13.9 (PC15)
/Microcontroller/BOOT0: J3.4, R31.1, U13.94 (BOOT0)
/Microcontroller/BUTTON: U13.33 (PC4); also elsewhere on the board
/Microcontroller/CAN1_MISO: U13.81 (PD0); also elsewhere on the board
/Microcontroller/CAN1_MOSI: U13.82 (PD1); also elsewhere on the board
/Microcontroller/CHARGER_CONNECTED: U13.4 (PE5); also elsewhere on the board
/Microcontroller/DIP_SW_1: SW2.4, U13.55 (PD8)
/Microcontroller/DIP_SW_2: SW2.3, U13.56 (PD9)
/Microcontroller/ENABLE_PRESSED: U13.34 (PC5); also elsewhere on the board
/Microcontroller/EN_SMPS: U13.83 (PD2); also elsewhere on the board
/Microcontroller/ESP07_EN: U13.45 (PE14); also elsewhere on the board
/Microcontroller/ESP07_RST: U13.46 (PE15); also elsewhere on the board
/Microcontroller/ESP_REGULAR_FLASH: U13.16 (PC1); also elsewhere on the board
/Microcontroller/GPIO0: J3.6, U13.54 (PB15)
/Microcontroller/GPIO1: J3.8, U13.53 (PB14)
/Microcontroller/GPIO2: J3.10, U13.52 (PB13)
/Microcontroller/GPIO3: J3.12, U13.51 (PB12)
/Microcontroller/GPIO4: J3.11, U13.25 (PA2)
/Microcontroller/GPIO5: J3.9, U13.26 (PA3)
/Microcontroller/GPIO6: J3.7, U13.38 (PE7)
/Microcontroller/GPIO7: J3.5, U13.39 (PE8)
/Microcontroller/GPIO8: J3.3, U13.40 (PE9)
/Microcontroller/GPIO9: J3.1, U13.41 (PE10)
/Microcontroller/I2C_SCL: R701.2, U13.95 (PB8); also elsewhere on the board
/Microcontroller/I2C_SDA: R34.2, U13.96 (PB9); also elsewhere on the board
/Microcontroller/IMU_NCS: U13.43 (PE12); also elsewhere on the board
/Microcontroller/IMU_SDO: U13.44 (PE13); also elsewhere on the board
/Microcontroller/MOT_L1: U13.2 (PE3); also elsewhere on the board
/Microcontroller/MOT_L2: U13.3 (PE4); also elsewhere on the board
/Microcontroller/MOT_PWM_L: U13.60 (PD13); also elsewhere on the board
/Microcontroller/MOT_PWM_R: U13.61 (PD14); also elsewhere on the board
/Microcontroller/MOT_R1: U13.98 (PE1); also elsewhere on the board
/Microcontroller/MOT_R2: U13.97 (PE0); also elsewhere on the board
/Microcontroller/MOT_STAND_BY: U13.1 (PE2); also elsewhere on the board
/Microcontroller/NRST: C25.2, J3.2, J20.1, R40.2, SW1.2 (B), U13.14 (NRST)
/Microcontroller/SENS_A_L: U13.23 (PA0); also elsewhere on the board
/Microcontroller/SENS_A_R: U13.31 (PA6); also elsewhere on the board
/Microcontroller/SENS_B_L: U13.24 (PA1); also elsewhere on the board
/Microcontroller/SENS_B_R: U13.32 (PA7); also elsewhere on the board
/Microcontroller/SERVO0: U13.63 (PC6); also elsewhere on the board
/Microcontroller/SERVO1: U13.64 (PC7); also elsewhere on the board
/Microcontroller/SERVO2: U13.65 (PC8); also elsewhere on the board
/Microcontroller/SERVO3: U13.66 (PC9); also elsewhere on the board
/Microcontroller/SPI1_MISO: U13.90 (PB4); also elsewhere on the board
/Microcontroller/SPI1_MOSI: U13.91 (PB5); also elsewhere on the board
/Microcontroller/SPI1_NSS: U13.77 (PA15); also elsewhere on the board
/Microcontroller/SPI1_SCK: U13.30 (PA5); also elsewhere on the board
/Microcontroller/STATUS_OUT0: U13.88 (PD7); also elsewhere on the board
/Microcontroller/STATUS_SMPS: U13.85 (PD4); also elsewhere on the board
/Microcontroller/SWCLK: J20.2, U13.76 (PA14)
/Microcontroller/SWDIO: J20.4, U13.72 (PA13)
/Microcontroller/SWIM: J20.3, U13.89 (PB3)
/Microcontroller/USART1_MISO: U13.93 (PB7); also elsewhere on the board
/Microcontroller/USART1_MOSI: U13.92 (PB6); also elsewhere on the board
/Microcontroller/USART3_ESP07_MISO: U13.48 (PB11); also elsewhere on the board
/Microcontroller/USART3_ESP07_MOSI: U13.47 (PB10); also elsewhere on the board
/Microcontroller/USART4_MISO: U13.79 (PC11); also elsewhere on the board
/Microcontroller/USART4_MOSI: U13.78 (PC10); also elsewhere on the board
/Microcontroller/USB_FS_D+: U13.71 (PA12); also elsewhere on the board
/Microcontroller/USB_FS_D-: U13.70 (PA11); also elsewhere on the board
/Microcontroller/USB_FS_VBUS: U13.68 (PA9); also elsewhere on the board
/Peripheral/CSB: U13.42 (PE11); also elsewhere on the board
/Peripheral/EN_OUT0: U13.84 (PD3); also elsewhere on the board
/Peripheral/USART2_GPS_MISO: U13.87 (PD6); also elsewhere on the board
/Peripheral/USART2_GPS_MOSI: U13.86 (PD5); also elsewhere on the board
GND: C8.1, C9.1, C10.1, C11.1, C12.2, C13.1, C15.1, C17.1, C18.2, C19.2, C20.2, C21.2, C23.2, C25.1, C702.2, D10.1 (K), D11.1 (K), D12.1 (K), J20.5, J20.6, J702.1, J702.2, J702.3, J702.4, J702.5, J702.6, R31.2, SW1.1 (A), SW2.1, SW2.2, U13.10 (VSS), U13.20 (VSSA), U13.27 (VSS), U13.74 (VSS), U13.99 (VSS); also elsewhere on the board
unnamed: C18.1, U13.12 (PH0), Y1.1
unnamed: C19.1, U13.13 (PH1), Y1.2
unnamed: C20.1, U13.49 (VCAP_1)
unnamed: C21.1, U13.73 (VCAP_2)
unnamed: D10.2 (A), R35.1
unnamed: D11.2 (A), R38.1
unnamed: D12.2 (A), R39.1
unnamed: J20.7, R35.2

Notes on the sheet:
Noise filtering
Boot
SWD
AUX LED
GPIO
RESET
DIP SWITCH

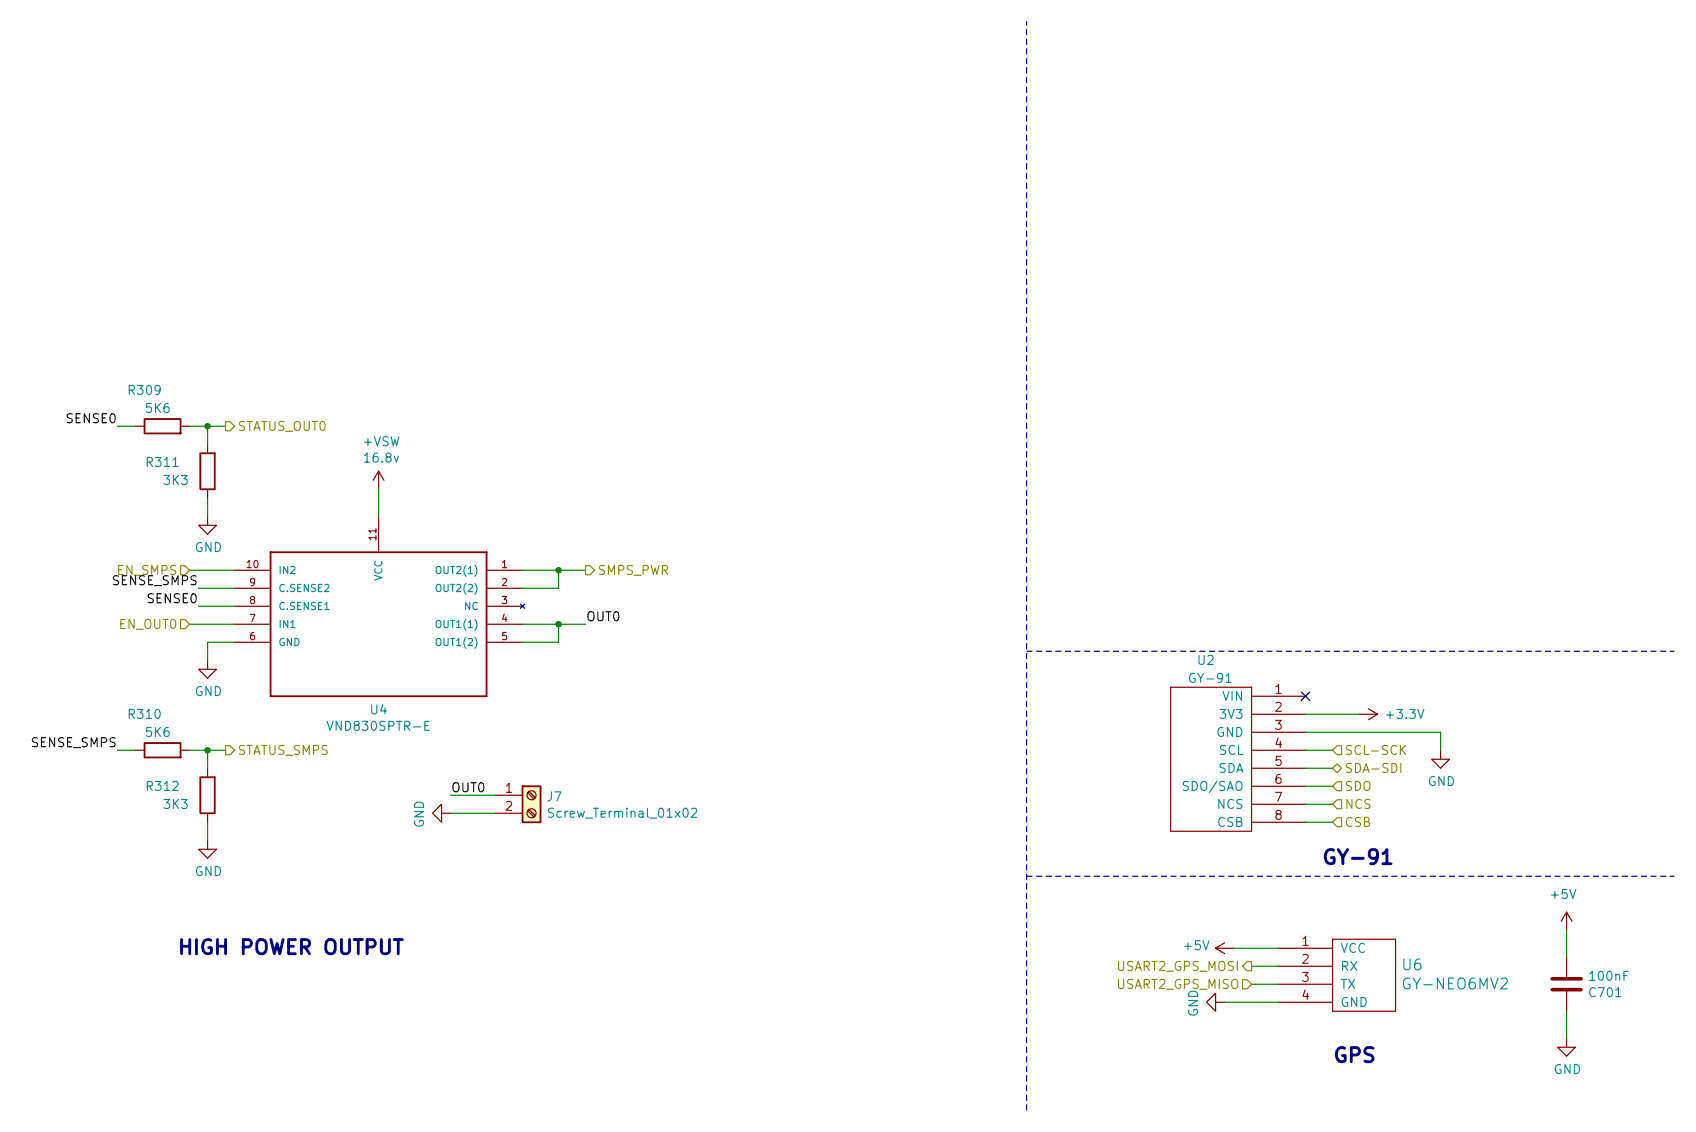
[picture p86: schematic Peripheral.sch]

Parts:
C701: 100nF; C_0805_2012Metric_Pad1.15x1.40mm_HandSolder
J7: Screw_Terminal_01x02; TerminalBlock_bornier-2_P5.08mm
R309, R310: 5K6; R_0805_2012Metric_Pad1.15x1.40mm_HandSolder
R311, R312: 3K3; R_0805_2012Metric_Pad1.15x1.40mm_HandSolder
U2: GY-91
U4: VND830SPTR-E
U6: GY-NEO6MV2

Connections:
+3V3: U2.2 (3V3); also elsewhere on the board
+5V: C701.1, U6.1 (VCC); also elsewhere on the board
+VSW: U4.11 (VCC); also elsewhere on the board
/Microcontroller/EN_SMPS: U4.10 (IN2); also elsewhere on the board
/Microcontroller/I2C_SCL: U2.4 (SCL); also elsewhere on the board
/Microcontroller/I2C_SDA: U2.5 (SDA); also elsewhere on the board
/Microcontroller/IMU_NCS: U2.7 (NCS); also elsewhere on the board
/Microcontroller/IMU_SDO: U2.6 (SDO/SAO); also elsewhere on the board
/Microcontroller/STATUS_OUT0: R309.2, R311.2; also elsewhere on the board
/Microcontroller/STATUS_SMPS: R310.2, R312.2; also elsewhere on the board
/Peripheral/CSB: U2.8 (CSB); also elsewhere on the board
/Peripheral/EN_OUT0: U4.7 (IN1); also elsewhere on the board
/Peripheral/OUT0: J7.1, U4.4 (OUT1(1)), U4.5 (OUT1(2))
/Peripheral/SENSE0: R309.1, U4.8 (C.SENSE1)
/Peripheral/SENSE_SMPS: R310.1, U4.9 (C.SENSE2)
/Peripheral/SMPS_PWR: U4.1 (OUT2(1)), U4.2 (OUT2(2)); also elsewhere on the board
/Peripheral/USART2_GPS_MISO: U6.3 (TX); also elsewhere on the board
/Peripheral/USART2_GPS_MOSI: U6.2 (RX); also elsewhere on the board
GND: C701.2, J7.2, R311.1, R312.1, U2.3 (GND), U4.6 (GND), U6.4 (GND); also elsewhere on the board

Notes on the sheet:
HIGH POWER OUTPUT
GY-91
GPS
