GonzaCerv/noah-hardware/PCB/root.kicad_pcb

## KiCad design PCB/root.kicad_pcb (continued)

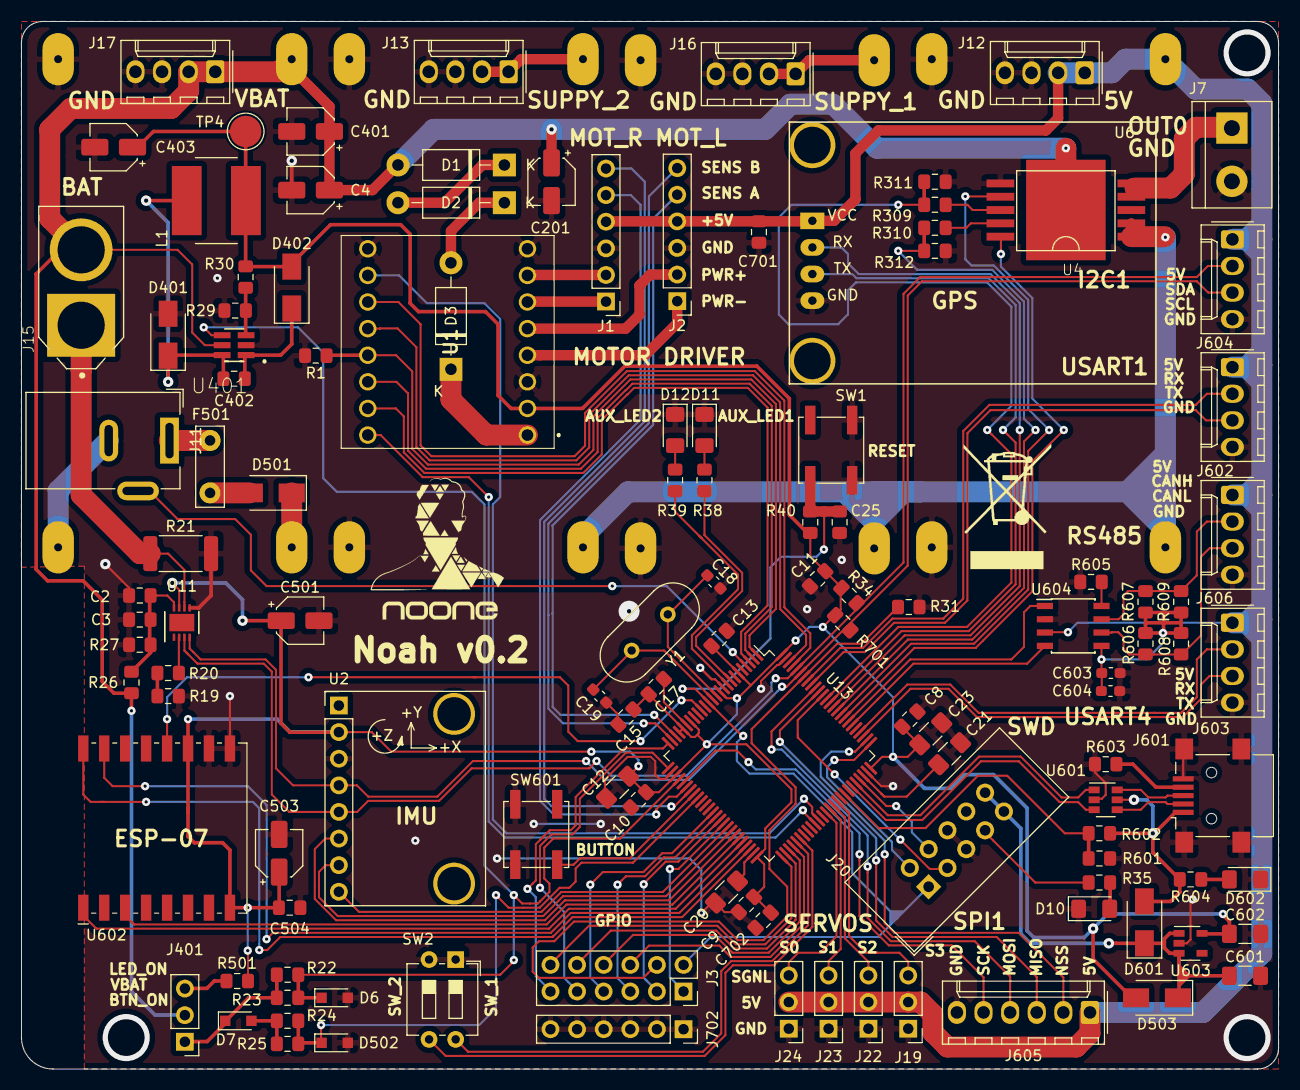
[picture p87: board root.kicad_pcb from above]

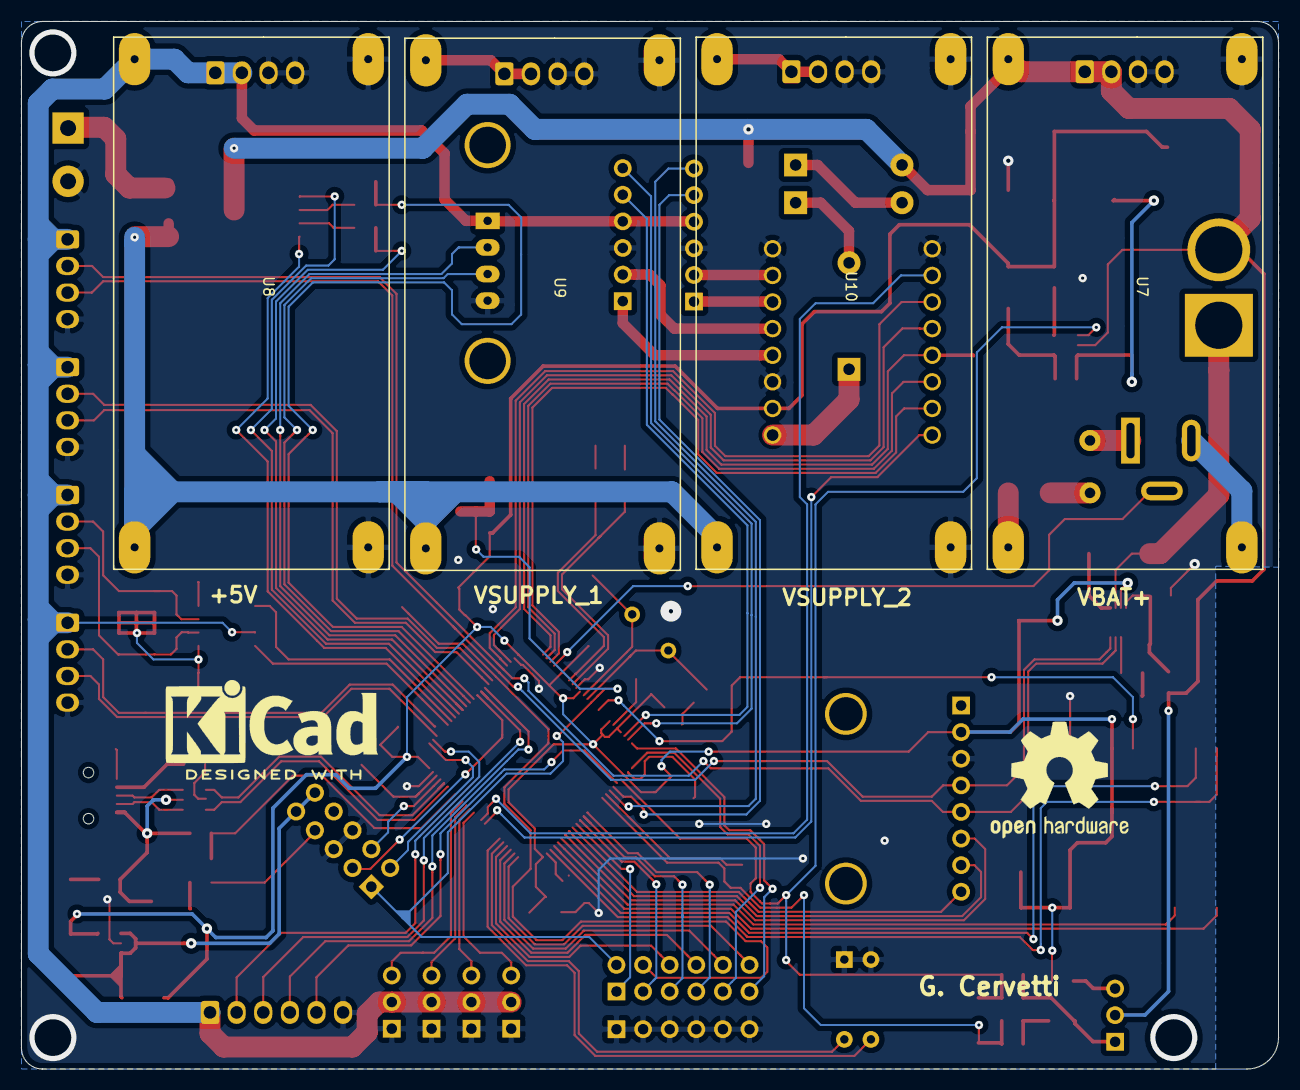
[picture p88: board root.kicad_pcb from below]

Board: 2 copper layers, 120.0 x 100.0 mm, 123 parts (4 on the bottom side), 116 nets.
