GonzaCerv/noah-hardware/firmware/firmware.ioc

Mcu.UserName=STM32F407VGTx
PA0-WKUP.GPIO_Label=SENS_A_L
PA0-WKUP.Signal=S_TIM2_CH1_ETR
PA1.GPIO_Label=SENS_B_L
PA1.Signal=S_TIM2_CH2
PA11.Signal=USB_OTG_FS_DM
PA12.Signal=USB_OTG_FS_DP
PA13.Signal=SYS_JTMS-SWDIO
PA14.Signal=SYS_JTCK-SWCLK
PA15.Signal=SPI1_NSS
PA2.GPIO_Label=GPIO4
PA2.Signal=GPIO_Output
PA3.GPIO_Label=GPIO5
PA3.Signal=GPIO_Output
PA4.GPIO_Label=EN_POWER_3V3
PA4.Signal=GPIO_Input
PA5.Signal=SPI1_SCK
PA6.GPIO_Label=SENS_A_R
PA6.Signal=S_TIM3_CH1
PA7.GPIO_Label=SENS_B_R
PA7.Signal=S_TIM3_CH2
PA9.Signal=USB_OTG_FS_VBUS
PB10.GPIO_Label=USART3_ESP07_MOSI
PB10.Signal=USART3_TX
PB11.GPIO_Label=USART3_ESP07_MISO
PB11.Signal=USART3_RX
PB12.GPIO_Label=GPIO3
PB12.Signal=GPIO_Output
PB13.GPIO_Label=GPIO2
PB13.Signal=GPIO_Output
PB14.GPIO_Label=GPIO1
PB14.Signal=GPIO_Output
PB15.GPIO_Label=GPIO0
PB15.Signal=GPIO_Output
PB3.Signal=SYS_JTDO-SWO
PB4.Signal=SPI1_MISO
PB5.Signal=SPI1_MOSI
PB6.GPIO_Label=USART1_MOSI
PB6.Signal=USART1_TX
PB7.GPIO_Label=USART1_MISO
PB7.Signal=USART1_RX
PB8.Signal=I2C1_SCL
PB9.Signal=I2C1_SDA
PC1.GPIO_Label=ESP_REGULAR_FLASH
PC1.Signal=GPIO_Output
PC10.GPIO_Label=USART4_MOSI
PC10.Signal=UART4_TX
PC11.GPIO_Label=USART4_MISO
PC11.Signal=UART4_RX
PC14-OSC32_IN.GPIO_Label=AUX_LED1
PC14-OSC32_IN.Signal=GPIO_Output
PC15-OSC32_OUT.GPIO_Label=AUX_LED2
PC15-OSC32_OUT.Signal=GPIO_Output
PC4.GPIO_Label=BUTTON
PC4.Signal=GPIO_Input
PC5.GPIO_Label=ENABLE_PRESSED
PC5.Signal=GPIO_Input
PC6.GPIO_Label=SERVO0
PC6.Signal=S_TIM8_CH1
PC7.GPIO_Label=SERVO1
PC7.Signal=S_TIM8_CH2
PC8.GPIO_Label=SERVO2
PC8.Signal=S_TIM8_CH3
PC9.GPIO_Label=SERVO3
PC9.Signal=S_TIM8_CH4
PD0.GPIO_Label=CAN1_MISO
PD0.Signal=CAN1_RX
PD1.GPIO_Label=CAN1_MOSI
PD1.Signal=CAN1_TX
PD13.GPIO_Label=MOT_PWM_L
PD13.Signal=S_TIM4_CH2
PD14.GPIO_Label=MOT_PWM_R
PD14.Signal=S_TIM4_CH3
PD2.GPIO_Label=EN_SMPS
PD2.Signal=GPIO_Output
PD3.GPIO_Label=OUT0
PD3.Signal=GPIO_Output
PD4.GPIO_Label=STATUS_SMPS
PD4.Signal=GPIO_Input
PD5.GPIO_Label=USART2_GPS_MOSI
PD5.Signal=USART2_TX
PD6.GPIO_Label=USART2_GPS_MISO
PD6.Signal=USART2_RX
PD7.GPIO_Label=STATUS_OUT0
PD7.Signal=GPIO_Input
PD8.GPIO_Label=DIP_SW_1
PD8.Signal=GPIO_Input
PD9.GPIO_Label=DIP_SW_2
PD9.Signal=GPIO_Input
PE0.GPIO_Label=MOT_R1
PE0.Signal=GPIO_Output
PE1.GPIO_Label=MOT_R2
PE1.Signal=GPIO_Output
PE10.GPIO_Label=GPIO9
PE10.Signal=GPIO_Output
PE11.GPIO_Label=IMU_CSB
PE11.Signal=GPIO_Output
PE12.GPIO_Label=IMU_NCS
PE12.Signal=GPIO_Output
PE13.GPIO_Label=IMU_SDO
PE13.Signal=GPIO_Input
PE14.GPIO_Label=ESP07_EN
PE14.Signal=GPIO_Output
PE15.GPIO_Label=ESP07_RST
PE15.Signal=GPIO_Output
PE2.GPIO_Label=MOT_STAND_BY
PE2.Signal=GPIO_Output
PE3.GPIO_Label=MOT_L1
PE3.Signal=GPIO_Output
PE4.GPIO_Label=MOT_L2
PE4.Signal=GPIO_Output
PE5.GPIO_Label=CHARGER_CONNECTED
PE5.Signal=GPIO_Input
PE7.GPIO_Label=GPIO6
PE7.Signal=GPIO_Output
PE8.GPIO_Label=GPIO7
PE8.Signal=GPIO_Output
PE9.GPIO_Label=GPIO8
PE9.Signal=GPIO_Output
PH0-OSC_IN.Signal=RCC_OSC_IN
PH1-OSC_OUT.Signal=RCC_OSC_OUT
