GonzaCerv/noah-hardware/firmware/Core/Inc/main.h

#define MOT_STAND_BY_Pin GPIO_PIN_2
#define MOT_STAND_BY_GPIO_Port GPIOE
#define MOT_L1_Pin GPIO_PIN_3
#define MOT_L1_GPIO_Port GPIOE
#define MOT_L2_Pin GPIO_PIN_4
#define MOT_L2_GPIO_Port GPIOE
#define CHARGER_CONNECTED_Pin GPIO_PIN_5
#define CHARGER_CONNECTED_GPIO_Port GPIOE
#define AUX_LED1_Pin GPIO_PIN_14
#define AUX_LED1_GPIO_Port GPIOC
#define AUX_LED2_Pin GPIO_PIN_15
#define AUX_LED2_GPIO_Port GPIOC
#define ESP_REGULAR_FLASH_Pin GPIO_PIN_1
#define ESP_REGULAR_FLASH_GPIO_Port GPIOC
#define SENS_A_L_Pin GPIO_PIN_0
#define SENS_A_L_GPIO_Port GPIOA
#define SENS_B_L_Pin GPIO_PIN_1
#define SENS_B_L_GPIO_Port GPIOA
#define GPIO4_Pin GPIO_PIN_2
#define GPIO4_GPIO_Port GPIOA
#define GPIO5_Pin GPIO_PIN_3
#define GPIO5_GPIO_Port GPIOA
#define EN_POWER_3V3_Pin GPIO_PIN_4
#define EN_POWER_3V3_GPIO_Port GPIOA
#define SENS_A_R_Pin GPIO_PIN_6
#define SENS_A_R_GPIO_Port GPIOA
#define SENS_B_R_Pin GPIO_PIN_7
#define SENS_B_R_GPIO_Port GPIOA
#define BUTTON_Pin GPIO_PIN_4
#define BUTTON_GPIO_Port GPIOC
#define ENABLE_PRESSED_Pin GPIO_PIN_5
#define ENABLE_PRESSED_GPIO_Port GPIOC
#define GPIO6_Pin GPIO_PIN_7
#define GPIO6_GPIO_Port GPIOE
#define GPIO7_Pin GPIO_PIN_8
#define GPIO7_GPIO_Port GPIOE
#define GPIO8_Pin GPIO_PIN_9
#define GPIO8_GPIO_Port GPIOE
#define GPIO9_Pin GPIO_PIN_10
#define GPIO9_GPIO_Port GPIOE
#define IMU_CSB_Pin GPIO_PIN_11
#define IMU_CSB_GPIO_Port GPIOE
#define IMU_NCS_Pin GPIO_PIN_12
#define IMU_NCS_GPIO_Port GPIOE
#define IMU_SDO_Pin GPIO_PIN_13
#define IMU_SDO_GPIO_Port GPIOE
#define ESP07_EN_Pin GPIO_PIN_14
#define ESP07_EN_GPIO_Port GPIOE
#define ESP07_RST_Pin GPIO_PIN_15
#define ESP07_RST_GPIO_Port GPIOE
#define USART3_ESP07_MOSI_Pin GPIO_PIN_10
#define USART3_ESP07_MOSI_GPIO_Port GPIOB
#define USART3_ESP07_MISO_Pin GPIO_PIN_11
#define USART3_ESP07_MISO_GPIO_Port GPIOB
#define GPIO3_Pin GPIO_PIN_12
#define GPIO3_GPIO_Port GPIOB
#define GPIO2_Pin GPIO_PIN_13
#define GPIO2_GPIO_Port GPIOB
#define GPIO1_Pin GPIO_PIN_14
#define GPIO1_GPIO_Port GPIOB
#define GPIO0_Pin GPIO_PIN_15
#define GPIO0_GPIO_Port GPIOB
#define DIP_SW_1_Pin GPIO_PIN_8
#define DIP_SW_1_GPIO_Port GPIOD
#define DIP_SW_2_Pin GPIO_PIN_9
#define DIP_SW_2_GPIO_Port GPIOD
#define MOT_PWM_L_Pin GPIO_PIN_13
#define MOT_PWM_L_GPIO_Port GPIOD
#define MOT_PWM_R_Pin GPIO_PIN_14
#define MOT_PWM_R_GPIO_Port GPIOD
#define SERVO0_Pin GPIO_PIN_6
#define SERVO0_GPIO_Port GPIOC
#define SERVO1_Pin GPIO_PIN_7
#define SERVO1_GPIO_Port GPIOC
#define SERVO2_Pin GPIO_PIN_8
#define SERVO2_GPIO_Port GPIOC
#define SERVO3_Pin GPIO_PIN_9
#define SERVO3_GPIO_Port GPIOC
#define USART4_MOSI_Pin GPIO_PIN_10
#define USART4_MOSI_GPIO_Port GPIOC
#define USART4_MISO_Pin GPIO_PIN_11
#define USART4_MISO_GPIO_Port GPIOC
#define CAN1_MISO_Pin GPIO_PIN_0
#define CAN1_MISO_GPIO_Port GPIOD
#define CAN1_MOSI_Pin GPIO_PIN_1
#define CAN1_MOSI_GPIO_Port GPIOD
#define EN_SMPS_Pin GPIO_PIN_2
#define EN_SMPS_GPIO_Port GPIOD
#define OUT0_Pin GPIO_PIN_3
#define OUT0_GPIO_Port GPIOD
#define STATUS_SMPS_Pin GPIO_PIN_4
#define STATUS_SMPS_GPIO_Port GPIOD
#define USART2_GPS_MOSI_Pin GPIO_PIN_5
#define USART2_GPS_MOSI_GPIO_Port GPIOD
#define USART2_GPS_MISO_Pin GPIO_PIN_6
#define USART2_GPS_MISO_GPIO_Port GPIOD
#define STATUS_OUT0_Pin GPIO_PIN_7
#define STATUS_OUT0_GPIO_Port GPIOD
#define USART1_MOSI_Pin GPIO_PIN_6
#define USART1_MOSI_GPIO_Port GPIOB
#define USART1_MISO_Pin GPIO_PIN_7
#define USART1_MISO_GPIO_Port GPIOB
#define MOT_R1_Pin GPIO_PIN_0
#define MOT_R1_GPIO_Port GPIOE
#define MOT_R2_Pin GPIO_PIN_1
#define MOT_R2_GPIO_Port GPIOE
