GonzaCerv/noah-hardware/(commit log)

2020-05-14 0.1.0 release
    [B00.SLDPRT, B001.SLDPRT, B002.SLDPRT, B03.SLDPRT, B04.SLDPRT, B05.SLDPRT, BALL40MM.SLDPRT, BMS.SLDPRT]
2020-08-07 Refactor case for v0.2.0
    [Adapter1(2).STL, Adapter2(2).STL, B00.SLDPRT, B001.SLDPRT, B002.SLDPRT, B01(1).STL, B01.SLDPRT, B03.SLDPRT]
2020-08-07 Change left motor direction
2020-09-15 add STL for mdf parts
    [B00.STL, B001.STL, B002.STL]
2020-09-15 added STL for printed wheels
    [B00.STL, B02.STL, B021.STL]
2020-10-05 Add mechanical manual
    [Adapter1(2).STL, Adapter1.SLDPRT, Adapter2(2).STL, Adapter2.SLDPRT, B00.SLDPRT, B00.STL, B001.SLDPRT, B001.STL]
2020-10-18 Add generic design
    [Adapter1.SLDPRT, Arduino Uno.SLDPRT, CasterJoint.SLDASM, Clamp Body 2x.SLDPRT, Clamp Body.SLDPRT, Cooler Blok.SLDPRT, L298 Board.SLDPRT, L298N Regulator.SLDPRT]
2021-04-27 Add BOM to the project #16
2021-05-18 Add BOM to project
    [BOM.ods]
2021-06-17 Generate STL for 3D printed wheels
    [adapter1_printed_noah.STL, adapter2_printed_noah.STL, tire_generic.STL, wheel_generic.STL]
