GonzaCerv/noah-hardware/(notices)

Notices in the files:
firmware/Core/Inc/main.h:
© Copyright (c) 2020 STMicroelectronics.
All rights reserved.
This software component is licensed by ST under Ultimate Liberty license
README.md:
License: MIT
